mmassico/window_air_vent/firmware/README.md

# Firmware

> **Running on the installed vent, in `webui/`.** Both sketches compile without warnings (Arduino core esp32 3.3.12). The web application runs the complete unit in a window, and it's now updated over the Wi-Fi: every part answers, and the console, the firmware update and both of its rollbacks (a crash at boot, no confirmation within 5 min) work. At every boot, a boundary test finds the damper's two ends. The SCD40's temperature matches two other thermometers within 0.2 °C, so its factory offset stays. Its CO₂ agrees with a calibrated meter (a GasDoc, calibrated outdoors, where it then read 418 ppm): 808 vs 759 ppm side by side, within the SCD40's ±(50 ppm + 5 %), so it isn't recalibrated. The microphone was calibrated on the bench against a sound level meter, before it went into its tube; it's too noisy outdoors to repeat that in place, so the tube's effect on the level hasn't been measured. `baremetal/` checked every part on the bench first.

Two sketches and the library they share:

1. **`baremetal/`**: a serial command console to check every electronic part on its own, with no Wi-Fi and no control logic.
2. **`webui/`**: the standalone application. The CO₂ control runs on the ESP32, with its own web page on the home network (LAN) for status, graphs, settings and manual control. With no sensors connected, a simulation stands in for them. See [The web application](#the-web-application-webui).
3. **`libs/WindowVent/`**: the pin map (`Pins.h`) and the drivers both sketches use (SCD40, AS5600, TMC2209, fans, DS18B20, microphone, serial console).

## Board and tools

- **Board:** Freenove ESP32-S3-WROOM Lite (FNK0099): 16 MB flash, 8 MB octal PSRAM, and two USB-C connectors: **USB-UART** (the onboard code uploader, a CH343 USB-serial chip wired to the ESP32's UART0) and **USB-OTG** (the ESP32-S3's own USB, host or device). Dimensions and pinout: [doc/esp32_s3.svg](../doc/esp32_s3.svg).
- **Software:** Arduino IDE 2.x with the **esp32 by Espressif Systems** core, version 3.x (tested to compile with 3.3.12).
- **Libraries:** the project's own `WindowVent` (in `libs/`), for both sketches; and for `webui/`, **ArduinoJson** 7.x by Benoit Blanchon (Library Manager). In the Arduino IDE, copy `libs/WindowVent` into the `libraries` folder of the sketchbook (Documents > Arduino > libraries on Windows), or link it there, so the IDE finds it.
- **Arduino IDE settings (Tools menu):**

| Setting | Value |
|---|---|
| Board | ESP32S3 Dev Module |
| USB CDC On Boot | Disabled: the console (`Serial`) then goes through the USB-UART connector. Enabled would move it to the USB-OTG connector |
| Flash Size | 16MB (128Mb) |
| Partition Scheme | 16M Flash (3MB APP/9.9MB FATFS) |
| PSRAM | OPI PSRAM |
| Upload Mode | UART0 / Hardware CDC |

Plug the cable into the **USB-UART** connector (silkscreen: onboard code uploader); it is used both to flash and for the console. Windows lists it as "USB-SERIAL CH343 (COMx)" under "Ports (COM & LPT)"; if it doesn't appear, install the CH343 driver from Freenove's package. Leave the TX/RX header pins (GPIO 43/44) unconnected. For the console, use the Serial Monitor at 115200 baud, or a terminal such as PuTTY; the up and down arrows then recall earlier commands.

The same builds from the command line, run from the `firmware` folder (`--libraries libs` points arduino-cli at the shared library; `-u -p COM3` also flashes the board on COM3):

```
arduino-cli lib install ArduinoJson
arduino-cli compile --fqbn "esp32:esp32:esp32s3:FlashSize=16M,PSRAM=opi,PartitionScheme=app3M_fat9M_16MB" --libraries libs baremetal
arduino-cli compile --fqbn "esp32:esp32:esp32s3:FlashSize=16M,PSRAM=opi,PartitionScheme=app3M_fat9M_16MB" --libraries libs webui -u -p COM3
```

## Wiring

Every pin is defined in [`libs/WindowVent/src/Pins.h`](libs/WindowVent/src/Pins.h), for both sketches. "3V3" and "GND" are the ESP32 board's pins. Every ground is common.

Wiring diagram: SCD40, AS5600, 12 V sense divider and both fans on the left of the ESP32-S3, TMC2209, stepper, two DS18B20 temperature sensors and the optional MAX9814 microphone (audio mode, with its GPIO 21 to GPIO 3 wire) or INMP441 I2S microphone (SD on GPIO 21, SCK and WS on GPIO 38 and 39) on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

The table below gives the same connections, pin by pin.

| Part | Pin | Goes to | Extra parts |
|---|---|---|---|
| **SCD40** (CO₂) | VDD, GND | 3V3, GND | |
| | SDA, SCL | GPIO 8, GPIO 9 (I²C bus 0, 100 kHz) | Most modules have pull-ups; on a 1–2 m cable, 4.7 kΩ to 3V3 at the ESP32 end helps |
| **AS5600** (encoder) | VCC, GND | 3V3, GND | |
| | SDA, SCL | GPIO 6, GPIO 7 (I²C bus 1, 400 kHz) | Pull-ups are on the module |
| | DIR | GND (sets the counting direction) | |
| **TMC2209** | VM, GND | 12 V, GND | 100 µF ≥ 25 V across VM–GND, close to the module |
| | VIO | 3V3 | |
| | EN | GPIO 10 | 10 kΩ to 3V3: the motor stays off while the ESP32 boots |
| | STEP, DIR | GPIO 11, GPIO 12 | |
| | DIAG | GPIO 13 | |
| | PDN_UART | GPIO 18 directly, and GPIO 17 through 1 kΩ | Single-wire UART, on the module's UART pin, and on its PDN pin too through JP3 (PCB v1.3). Some modules route the chip's PDN_UART to their PDN pin instead, through a 0 Ω link: see step 5 below |
| | MS1, MS2 | GND | UART address 0 |
| | A1 A2 B1 B2 | Motor coils | Never plug or unplug the motor with 12 V on |
| **Fan 0, exhaust** (upper; Noctua: black GND, yellow 12 V, green tach, blue PWM) | PWM | GPIO 4 | 10 kΩ to GND: the fan stays slow while the ESP32 boots |
| | Tach | GPIO 15 | 10 kΩ to 3V3 |
| **Fan 1, intake** (lower) | PWM | GPIO 5 | 10 kΩ to GND |
| | Tach | GPIO 16 | 10 kΩ to 3V3 |
| **12 V sense** | | GPIO 1 | 100 kΩ from 12 V to GPIO 1, 22 kΩ from GPIO 1 to GND |
| **DS18B20, outdoor** (waterproof probe through the foam insert) | VDD, GND | 3V3, GND | Three wires, no parasite power |
| | DQ | GPIO 14 | 4.7 kΩ to 3V3 |
| **DS18B20, indoor** (optional: the SCD40 also reads the room's temperature) | VDD, GND | 3V3, GND | |
| | DQ | GPIO 21 | 4.7 kΩ to 3V3 |
| **Microphone, audio mode** (optional, instead of the indoor DS18B20: a MAX9814 module) | VDD, GND | 3V3, GND | On the indoor probe's header |
| | OUT | GPIO 21, wired to GPIO 3 | No pull-up: leave the indoor probe's 4.7 kΩ out |

- **On the board itself:** the blue LED (GPIO 2) blinks as a heartbeat, and the RGB LED is on GPIO 48 (`led` command).
- **Temperature sensors:** read with the `temp` command; the sketch drives the 1-Wire bus itself (`Ds18b20.cpp`), so no library is needed. The outdoor probe goes through the foam insert, out of the sun. Its template spot, above the upper hole, now sits over the exhaust (on top since the swap), so the warm air leaving the room can reach it: a better spot is still to be chosen.
- **Audio mode (optional):** an analog microphone measures the outdoor sound level, for instance to close the damper when it's too loud outside. It takes the indoor DS18B20's header, so it replaces that probe. It stays on the room side and listens through a tube in the foam insert: see [the window insert's outdoor microphone](../window_insert/README.md#outdoor-microphone). That header's line, GPIO 21, has no ADC, so GPIO 21 is joined to GPIO 3, the only free pin on ADC1: fit JP2 on the back of the PCB (a solder jumper on v1.1 and v1.2, a 0 Ω 0402 or a short wire since v1.3), or solder a short wire on a v1.0 PCB or the perfboard. ADC2 can't be used while Wi-Fi runs. Leave out that header's 4.7 kΩ pull-up: it would pull the microphone's output toward 3.3 V. `AUDIO_MODE` is 1 in `Pins.h` (audio mode); set it to 0 to use the indoor probe instead. The firmware leaves GPIO 21 disconnected (input off, no pull-up or pull-down), reads the microphone on GPIO 3, and drops the indoor probe. GPIO 3 is a strapping pin, but only for the JTAG source, and only when an eFuse selects it, so the microphone's bias at reset does no harm. The MAX9814's output rests at about 1.25 V and swings up to 2 V peak to peak, inside the ADC's 0–3.1 V range. Tie its GAIN pin to VDD (40 dB) and leave A/R open. Its automatic gain control (AGC) holds loud sounds near a fixed output level, so above it a louder sound reads no higher. Measured at 40 dB gain against a calibrated meter (below), the readings are linear from about 50 dBA, where the ADC's own noise sets the floor (a quiet room reads about 45 dBA), up to about 76 dBA for broadband noise and 84 dBA for a 1 kHz tone (the AGC watches the peaks, and noise has higher peaks than a tone). Above that, the reading stays near 76 dBA (noise) or 83 dBA (tone). Outdoor noise of interest (60 to 75 dBA: traffic, a neighbour's mower) fits; louder still reads as about 76. At 50 or 60 dB (GAIN to GND, or open), the AGC would act 10 or 20 dB lower.
- **Audio mode with an INMP441 (optional, `MIC_INMP441` 1 in `Pins.h`):** a digital I²S microphone instead of the MAX9814. It has no AGC, so its level stays linear from about 35 dBA (its own noise) to about 120 dB, and its sensitivity is set at the factory (−26 dBFS at 94 dB SPL, ±1 dB), so `micCal` defaults to 120 with no calibration needed (`sound cal` still adjusts it for the tube). SD goes on GPIO 21 (J7's IN), WS on GPIO 39 and SCK on GPIO 38: PCB v1.4's J7 is a 2 × 3 header with WS, SCK and a GND on its second row; tie the INMP441's L/R pin to that GND (the left channel). Leave JP2 open; R9 can stay. Any GPIO can carry I²S on the ESP32-S3, and 38 and 39 are free on this board (35 to 37 belong to the octal PSRAM). It samples at 8000/s like the MAX9814 (a 512 kHz clock, inside the INMP441's 0.5 to 3.2 MHz), with the same A-weighting; the ADC then stays free, so the 12 V sense reads it directly. A saved `micCal` belongs to the microphone it was set for: after a switch, the new microphone's default applies. Compiles; not yet tested with an INMP441.
- **Power:** two adapters. A 12 V brick feeds VM, the fans and the 12 V sense; a 5 V USB-C adapter powers the ESP32 through its USB-UART connector (the board makes the 3V3 for the sensors and the TMC2209 logic). Join the brick's GND and the ESP32's GND on the perfboard. The [layout drawing](../doc/ebox_layout.svg) shows where the parts go in the box.
- **Driving the fan PWM directly:** the 3.3 V PWM output drives the Noctua PWM input as is (Noctua accepts a 3.3 V signal). If you ever add an inverting transistor, set `FAN_PWM_INVERT` to 1.

## Bring-up, one part at a time

Each step only needs the parts before it. Each line shows a command, then what you should see.

1. **ESP32 alone, on USB.**
   - Flash the sketch, open the console, and type `info`: the chip, 16 MB of flash and 8 MB of PSRAM should be listed.
   - `led 0 0 40`: the RGB LED turns blue.
2. **Encoder.**
   - `i2c scan 1` shows `0x36`.
   - `enc` gives the angle, with the magnet status "OK" and an AGC around mid-range (about 60–200).
   - Turn the shaft by hand: the angle follows.
   - "Too weak" means the magnet is too far away; "too strong" means it's too close.
3. **CO₂ sensor.**
   - `i2c scan 0` shows `0x62`, and `co2 serial` prints a number.
   - `co2 start`, wait 5 s, then `co2`: about 400–1000 ppm indoors, with the room's temperature and humidity. Breathe near it and the next reading jumps up.
   - The NDIR cell reads a little high in its first hours. `co2 frc 420` sets it against outdoor air: run `co2 start` outside for 3 minutes, then `co2 stop` and `co2 frc 420`.
4. **12 V on.**
   - `info`: Supply ≈ 12 V.
   - `fan all 30`, then `fan` a few seconds later: both fans report a speed.
   - Try `fan 0 100` and `fan 1 0`: each fan follows its own command.
   - The NF-A8s tested stop at 0% and 5%, and start between 5 and 10% (about 180 rpm). With the dampers open, they reach about 2200 rpm at 100%.
5. **Driver and motor.**
   - `tmc init`, then `tmc status`: version `0x21`, and IFCNT goes up by one after each `tmc wr` or `mot cur` command. That proves both directions of the UART work.
   - No answer, while `tmc wr 0 0x1C0` still says OK: the ESP32 hears its own bytes, so the line is fine up to the module's UART pin, but the chip isn't on it. Some modules, such as the TMC2209-LA, have a 0 Ω link that routes the chip's PDN_UART to either their PDN pin (pin 4) or their UART pin (pin 5), and come with it on PDN. On a v1.3 PCB, check that JP3 (pin 4) and JP4 (pin 5) are both fitted. Nothing else uses pin 4 on an older PCB or the perfboard, so join pins 4 and 5 with a short wire on the board's underside there (or move the link to the UART pad).
   - `mot en 1`, then `mot step 800`: a quarter turn at the default 16 microsteps. The report compares the expected angle with the encoder's. If their signs are opposite, the firmware will simply flip one of them.
   - `mot step -800` comes back.
   - `mot vel 1000` turns continuously with the driver's own step generator. Run `mon`, slow the shaft with your fingers, and watch SG drop. `mot vel 0` stops it.
   - When the damper is fitted, the same test against the lips gives the StallGuard number for "closed".
6. **Temperature probes.**
   - `info` lists each DS18B20 as "answers" or "absent" (the indoor one is optional).
   - `temp`: both temperatures after a 0.75 s conversion. Warm the probe in your hand and the next reading rises.
   - `temp rom`: each probe's ROM code; family `28` is a genuine DS18B20 type.
   - "absent" means no presence pulse: check the three wires and the 4.7 kΩ pull-up. "CRC error" usually means a weak or missing pull-up, or a long cable.
7. **Microphone (audio mode only).**
   - `info`: the microphone's DC level is about 1250 mV with a MAX9814. Near 0 or 3300 mV means no bias: check its power and the GPIO 21 to GPIO 3 wire.
   - `sound`: one 0.25 s reading. It gives the level in dBFS (0 dB is a sine filling the ADC's whole range), the DC bias, the peak-to-peak swing and the achieved sample rate (8000 samples/s aimed). Clap: the level jumps.
   - "CLIPPING" means the signal reaches the ADC's limits. The MAX9814's AGC caps its output at about 2 V peak to peak, so it shouldn't happen; if it does, check that GAIN is tied to VDD and that the DC level is near 1250 mV.
   - `sound mon` prints the level every 0.5 s, with a 10 s average, the loudest so far and a bar graph.
   - To read dB SPL instead of dBFS, play a steady noise, read it on a phone sound meter app, and type `sound cal <dB>` with that value. The offset lasts until a reboot; to keep it, copy the printed value into `MIC_CAL_DB` in `Pins.h`.
   - The level is measured in short bursts of one-shot reads, after a 150 Hz high-pass filter that cuts wind rumble and the fans' hum. The 12 V sense also reads ADC1 one-shot, and the core's continuous (DMA) mode can't share a unit with it. For a sound level, that's enough.
8. **Everything at once.** `mon 1000` prints one line per second with every reading, until a key is pressed. In audio mode, the indoor temperature's place shows the sound level.

Note any number that looks wrong: the magnet status, the AGC, the SG values while turning freely and against the lips, and the fan speeds at 30% and 100%. They become the settings of the final firmware.

## Command list

Type `help` on the console for the full list. In brief:

| Group | Commands |
|---|---|
| General | `help`, `cls`, `info`, `reboot`, `led <r> <g> <b>`, `mon [ms]` |
| I²C | `i2c scan <bus>`, `i2c rd <bus> <addr> <reg> [n]`, `i2c wr <bus> <addr> <reg> <data>...` |
| CO₂ | `co2 start`, `co2 stop`, `co2`, `co2 serial`, `co2 selftest`, `co2 frc <ppm>` |
| Encoder | `enc`, `enc zero` |
| Motor | `mot en <0\|1>`, `mot step <n> [speed]`, `mot vel <speed>`, `mot cur <mA> [hold%]`, `mot ustep <n>`, `mot sgt <n>` |
| Driver registers | `tmc init`, `tmc status`, `tmc rd <reg>`, `tmc wr <reg> <value>` |
| Fans | `fan`, `fan <0\|1\|all> <duty%>` |
| Temperature | `temp`, `temp rom` |
| Sound (audio mode) | `sound`, `sound mon [ms]`, `sound cal <dB>` |

Numbers can be written as `42`, `0x2A`, `2Ah`, `0b101010` or `101010b`. A long move or `mon` stops when any key is pressed.

## Defaults

The settings applied at boot are in `baremetal.ino`:
- 16 microsteps (interpolated to 256 by the driver);
- 500 mA run current, with 50% hold current;
- StealthChop;
- 800 microsteps/s, which is a quarter turn per second.

The current calculation assumes 0.11 Ω sense resistors (`TMC_RSENSE` in `Pins.h`), the usual value on StepStick-style modules.

## The web application (`webui/`)

The ESP32 runs the ventilation on its own and serves a web page on the home network: no cloud, no app.

**First start: Wi-Fi.** With no network saved, the vent opens its own Wi-Fi network, **WindowVent-setup** (no password). Join it with a phone: the setup page opens by itself (or go to http://192.168.4.1). Pick the home network, type its password, and the vent joins it; the setup network closes two minutes later. Then open **http://window-vent.local**, or the address the router gives it (the serial console prints it, and so does `info`). The ESP32-S3 has 2.4 GHz Wi-Fi only. If it can't join the saved network, the setup network opens again (after 20 s at start-up, or 5 min after losing the network), and the vent keeps trying to join meanwhile. On the serial console, `wifi <ssid> <password>` does the same (for a network name without spaces), and `wifi forget` erases it.

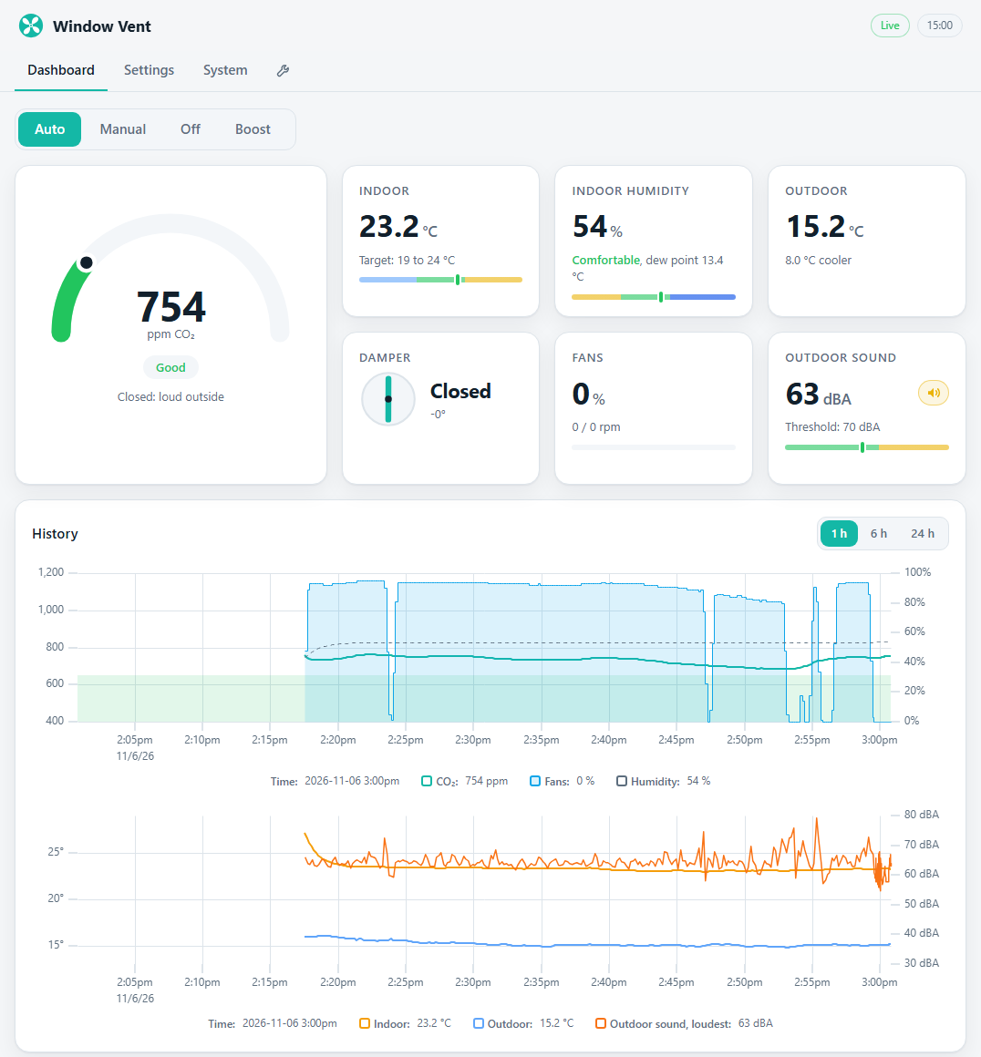
[picture p41: firmware/images/webui-dashboard.png]
The dashboard in the light theme, on the installed vent: Auto mode, a CO2 gauge at 754 ppm with the line Closed: loud outside, tiles for the indoor and outdoor temperatures, humidity, the closed damper, the fans at 0 % and the outdoor sound at 63 dBA with its loud icon, and about 40 minutes of two 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


*The dashboard on the installed vent, on a noisy day: the damper closes and the fans stop each time the outdoor sound crosses its threshold, here 70 dBA. The speaker icon in the sound's tile says so.*

**The page**, in four tabs:
- **Dashboard:** the mode (Auto, Manual, Off, Boost), a CO₂ gauge with the target range, the indoor and outdoor temperatures, humidity (with its comfort range and the dew point), the damper's position, the fans, the outdoor sound in audio mode, a line saying why the vent does what it does, and two graphs over 1, 6 or 24 hours (a point every 10 s, kept in PSRAM; a page that was in the background fetches what it missed when it comes back): CO₂ with the fans and the humidity (in %), and the indoor and outdoor temperatures with the outdoor sound in audio mode (in dBA, on the right).
- **Settings:** the CO₂ curve (drag its points), the damper's opening and closing levels, the absolute maximum and the target range; temperature, quiet hours, outdoor noise, fans, boost, the damper motor, network and time; then the page's theme and colours. The Save button stores the settings on the vent (NVS), and every other open page picks them up within a second or two, keeping any edits it hasn't saved. The theme stays with each browser; the colours can be saved on the vent and loaded in another browser. On a phone, the sliders take a horizontal drag only: a vertical swipe that starts on one scrolls the page, and a tap leaves it alone.
- **System:** the Wi-Fi network, the firmware, the local time (NTP), restart, and the firmware update.
- **Developer** (the wrench): the simulation, the control outputs, which parts answer, the damper's boundary test, and the log with a console under it.

**How it decides (Auto).** Every second, the CO₂ curve gives a fan speed. The damper opens above the opening level and closes below the closing level (the gap between them keeps it from hunting), each state held a minimum time. Caps then lower the speed: cold outside (linear between two outdoor temperatures), a room below its comfort range, warmer air outside, quiet hours, outdoor noise. A cap of 0 % closes the damper, and the dashboard says which limit did. A warm room with cooler air outside gets free cooling. Above the absolute maximum, ventilation goes full whatever the caps. The fans ramp at 5 % per second, and the balance setting trims intake against exhaust. Without a CO₂ reading, the fans run at 30 %. The details are at the top of [`webui/Control.h`](webui/Control.h).

**The damper's boundary test.** At every boot, as soon as the driver and the encoder answer, the damper closes slowly until it stops on the lips, then opens until it stops at the other end; the encoder watches it, as for any move. The closed stop becomes the encoder's zero (`encZero`, saved when it changes), and the open angle stays 2° short of the open stop, whatever `openDeg` asks. Closing then aims 2° past the closed stop, so the disc always seats on the lips. If the encoder goes more than 20° the wrong way while closing, `motorDir` is flipped and the test starts again; it's saved only if the test succeeds (a disc already on the lips bounces back a few degrees, which doesn't count). If the two stops come out too close together, it also tries the other direction, once: a disc that starts near the open stop can't show a wrong direction while closing. It fails, keeping the saved settings, if it finds no stop within 20 s or the two stops are less than 20° or more than 200° apart. It takes about 10 s; the log shows each step, `status` shows the stops, and `damper cal` (or the Developer tab's button) runs it again. On the bench: closed at raw 3569, 100.4° to the open stop.

**The microphone's calibration.** The firmware A-weights the microphone's signal (two biquads at 8000 samples/s, within 0.8 dB of IEC 61672 from 31 Hz to 3.9 kHz; see [`Sound.h`](libs/WindowVent/src/Sound.h)), so once calibrated it reads dBA, as a sound level meter does: dBA = A-weighted dBFS + `micCal`. The bench unit was calibrated against a REED R8080 meter (dBA, FAST), next to the MAX9814, with a USB speaker playing pink noise and tones stepped by 6 dB: `micCal` = 90.8 dB, now the default (`MIC_CAL_DB` in `Pins.h`). The vent's own reading then matched the meter within 0.7 dB from 57 to 75 dBA (within 0.2 dB from 63 to 75), and tones from 250 Hz to 3 kHz within ±1 dB. Without the A-weighting, the flat reading would read low-pitched noise such as traffic about 6 dB louder than the meter. For another module, or the microphone in its tube, play a steady noise above 55 dBA, read it on a meter, and type `sound cal <dBA>` on the console: it sets `micCal` and saves it. `sound [ms]` gives the level over the last ms, up to 8 s, with its loudest 1/8 s.

**How it listens.** The web firmware samples the microphone without a pause, at 8000 samples/s: the ADC's DMA mode does the sampling, and a small task filters the samples into blocks of 1/8 s, a sound level meter's FAST response (see [`SoundStream.h`](libs/WindowVent/src/SoundStream.h)). A short sound such as a dog's bark can't fall between two readings. The noise threshold looks at the loudest 1/8 s, so one bark is enough, and each one restarts the hold time. The dashboard's tile shows that same value, the loudest 1/8 s of the last second, and so does the graph: each second's loudest while the page is open, each 10 s's loudest from the vent's history, so what closed the damper stays visible. The 12 V sense shares ADC1, and DMA can't share it with one-shot reads, so its reading comes through the same stream. The vent's own fans count too: at full speed they raised the reading from 57 to about 63.5 dBA here, so keep the threshold clear of that, or the damper will close, go quiet, reopen and close again. The baremetal sketch keeps its one-shot bursts.

**The SCD40's temperature offset.** The SCD40 reads warm: it heats itself, and the ESP32, the driver and the box around it add to that. It subtracts a temperature offset (4 °C from the factory) from its temperature, and uses the corrected temperature for its humidity too, so the right offset fixes both. It depends on where the sensor ends up and the air around it, so set it with the vent in its final place, after it has run for at least an hour: put a reference thermometer beside the sensor (not in the sun, not in the fans' airflow), let both settle, and type `co2 tref <the reference's °C>` on the console. It sets the offset so the sensor reads the same, and keeps it in the sensor's EEPROM (good for about 2000 writes, so not a thing to repeat often). `co2 offset` shows it, and `co2 offset <C>` sets it directly. Both stop and restart the sensor's measurement, and its temperature drifts for a few minutes after that: wait at least 5 minutes before comparing again.

**Simulation.** At start-up, the simulation stays on unless the SCD40 answers within 8 s; the Developer tab switches it either way. It stands in for the sensors, the fans and the damper, and the real fans and motor stay still meanwhile. **Manual values**: a slider per reading. **Room model**: occupants breathe CO₂ into a room, the ventilation carries it out and moves the room toward the outdoor temperature, and time can run up to 300 times faster.

**Editing the page.** Its sources are in `webui/web/` (`index.html`, `app.css`, `app.js`, `setup.html`, and uPlot for the graphs, MIT licence, in `web/vendor/`). After a change, run `python tools/webui_pack.py` from the `window-vent` folder: it inlines and gzips them into `webui/WebPage.h` and `webui/SetupPage.h`; then build and flash. To try a change without flashing, serve the folder from the PC (`python -m http.server` in `webui/web`) and open `http://localhost:8000/?host=<the vent's address>`: the page then talks to the vent.

**Interface.** On port 80: `GET` and `POST /api/settings` (any subset, saved at once), `GET /api/history` (binary, see [`webui/History.h`](webui/History.h)), `POST /api/cmd` (a command, as on the WebSocket), `GET /api/scan` and `POST /api/wifi`, `GET` and `POST /api/ui` (the shared colours), and `/ws`, a WebSocket that sends the whole state every second and takes commands such as `{"cmd":"mode","mode":"boost"}`. The list is at the top of [`webui/Web.h`](webui/Web.h).

**The password.** The console and the firmware update need the vent's password; both are refused until one is set. Set it on the serial console with `pass <password>` (no spaces), and change it the same way, there or from the web console; `pass -` removes it. It stays in NVS and the vent never sends it back. The page asks for it once per browser tab, and other clients send it in an `X-Pass` header. A wrong password costs a second. The rest of the page (the mode, the settings) stays open to anyone on the home network, as before.

**Console and log over the Wi-Fi.** The serial console's commands also work over the Wi-Fi, from the box under the log in the Developer tab, or from a PC:

```
curl -H "X-Pass: <password>" --data-binary "status" http://window-vent.local/api/console
curl "http://window-vent.local/api/log?since=0"
```

`help` lists the commands. `info` gives the firmware, the last reset's cause (power-on, crash, watchdog, brown-out), the uptime, memory and Wi-Fi. `status` gives every reading, the control's outputs, the damper, the fans and which parts answer. `log [n]` gives the last lines. For the hardware there are `enc`, `tmc` (its registers), `tmc rd` and `tmc wr`, `i2c scan <0|1>`, `sound` and `sound cal <dBA>`, `co2 offset [C]` and `co2 tref <C>`. `cpu` gives each task's share of its core since the last `cpu`. `sockets` lists the web server's connections (HTTP or WebSocket, client, age) with its counters since boot, and the Wi-Fi drops; the System tab shows the same counters with each core's load. A page that stops reading (asleep in a background tab, or on a phone) never holds up the server: its WebSocket skips states while it is behind, and after 15 s without progress the vent closes it (counted as "closed for not reading"); the page reconnects when it wakes up. Commands run in the main loop, between its tasks, so they never collide with the sensors' readings. The log keeps the last 2000 lines since boot in PSRAM; the page fetches them when it connects, and `GET /api/log?since=N` gives them to any client, numbered from 0 at boot.

**Fan roles.** The fans mount either way round in the housing, so which connector is the intake is a setting (Settings > Fans, "Intake on the lower fan (FAN1)"; the default comes from `INTAKE_FAN` in `App.h`): FAN0 is the upper fan, FAN1 the lower one, as on the PCB. The default is the intake on FAN1: the cold air comes in low and the warm exhaust leaves high, so neither loops back into the other. The control, the balance, the dashboard and `status` work in intake and exhaust, whichever connector each one is on.

**Test mode.** `fan <0|1|all> <duty%>` (by connector) or `fan intake|exhaust <duty%>` (by role) and `damper <deg>` drive the fans and the damper directly, and switch on test mode: the control keeps computing (`status` shows it) but no longer drives them. `test off` hands them back. Test mode also ends by itself after 10 minutes without a test command, so a forgotten test can't leave the vent stuck. `damper` moves with the encoder, as the control does, and clears a previous fault.

**Firmware update over the Wi-Fi.** Once this firmware is on the vent (by USB, once), the next ones can go over the Wi-Fi. Build it (Arduino IDE: Sketch > Export Compiled Binary; arduino-cli: add `--output-dir build`) and send `webui.ino.bin`, not the much larger `webui.ino.merged.bin`. Either pick it in the System tab's Firmware update, or:

```
curl -H "X-Pass: <password>" --data-binary @build/webui.ino.bin http://window-vent.local/update
```

The flash has two application slots (`app0`, `app1`, from the partition scheme above). The update goes to the slot that isn't running, and the vent restarts into it, keeping the other one. The new firmware then has to prove itself: it confirms itself once it has been on the Wi-Fi for 30 s. If it crashes before that, or isn't on the Wi-Fi within 5 minutes, the vent goes back to the previous firmware, so a bad build can't strand the vent out of reach. The log says which happened, and `ota` shows the two slots. Settings, Wi-Fi and the password stay in NVS through an update. Uploading another sketch this way (`baremetal`) would skip that check and stay, with no way back but USB.

## License

The firmware is released under the [MIT License](LICENSE).
