mmassico/window_air_vent/doc/foam_template.pdf

# Foam insert: drilling template, full size (mm)

Print at 100 % (Actual size, not Fit to page); both bars must measure 100 mm.
Tape it on the foam, centred across the insert's width, EXHAUST on top (it works from either face). Drill a pilot hole right through each centre: mark it with an awl, or set the drill_guide on the lines. Cut with a 3-1/4 in (83 mm) hole saw, halfway from each face, centred on the pilot hole.
Outdoor probe: if possible, put it far from the exhaust (the top hole), not in the spot marked below.

100
112
insert width

# EXHAUST

Ø 83 hole
top: room air out

# INTAKE

Ø 83 hole
bottom: outdoor air in

dashed circle: stop ring Ø 90 (the housing on the room face)

### 96 between centres

Optional: outdoor DS18B20

probe, Ø 6.5 hole
keep it in the shade

100 mm

100 mm

tools/foam_template_svg.py (hole 83, pitch 96, stop_od 90, widths 100 and 112)
