mmassico/window_air_vent/window_insert/doc/latch_template.pdf

# Window insert: latch cover notch template, full size (mm)

Print two copies at 100 % (Actual size, not Fit to page); both bars must measure 100 mm.
Copy 1: cut along the OUTER rectangle. Lay it on the foam's room face, its left edge on the foam's end (the side frame's end), and trace it: that is the top edge of the three 45° slopes.
Copy 2: cut along the INNER rectangle: the notch's floor, 9.5 mm deep. Lay it in the notch to check the floor. Line both up in height with the notch in the assembled side cap; carve a little small, then sand to the cover.

OUTER: on the room face

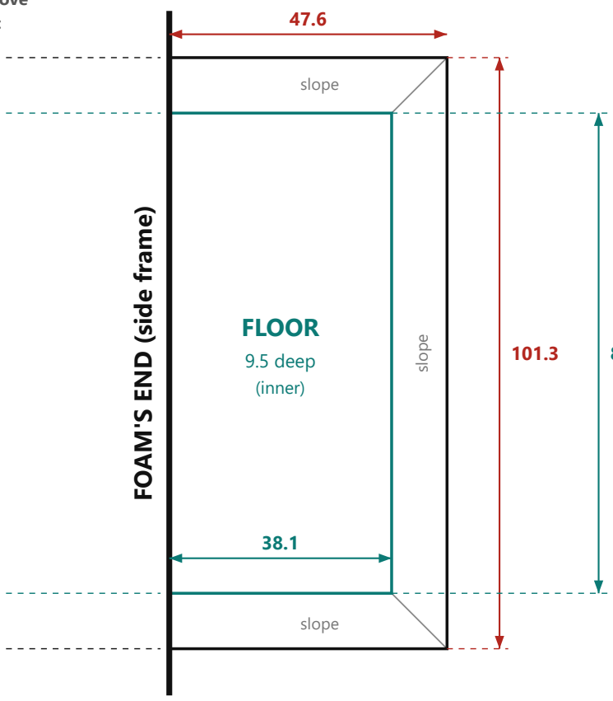
[picture p78: figure]
D (sid; e fra; slope; FLOOR; 9.5 deep (inner)

82.3

slopes: 45°, 9.5 wide on the face and 9.5 deep

On the foam, above
its bottom edge:
582.1 outer

572.6 inner

490.4 inner

480.9 outer

The foam's bottom edge is
below this page: TOP is up.

TOP

100 mm

100 mm

tools/latch_template_svg.py (outer 47.6 x 101.3, inner 38.1 x 82.3, 9.5 deep)
