mmassico/window_air_vent/pcb/view/render_top.png

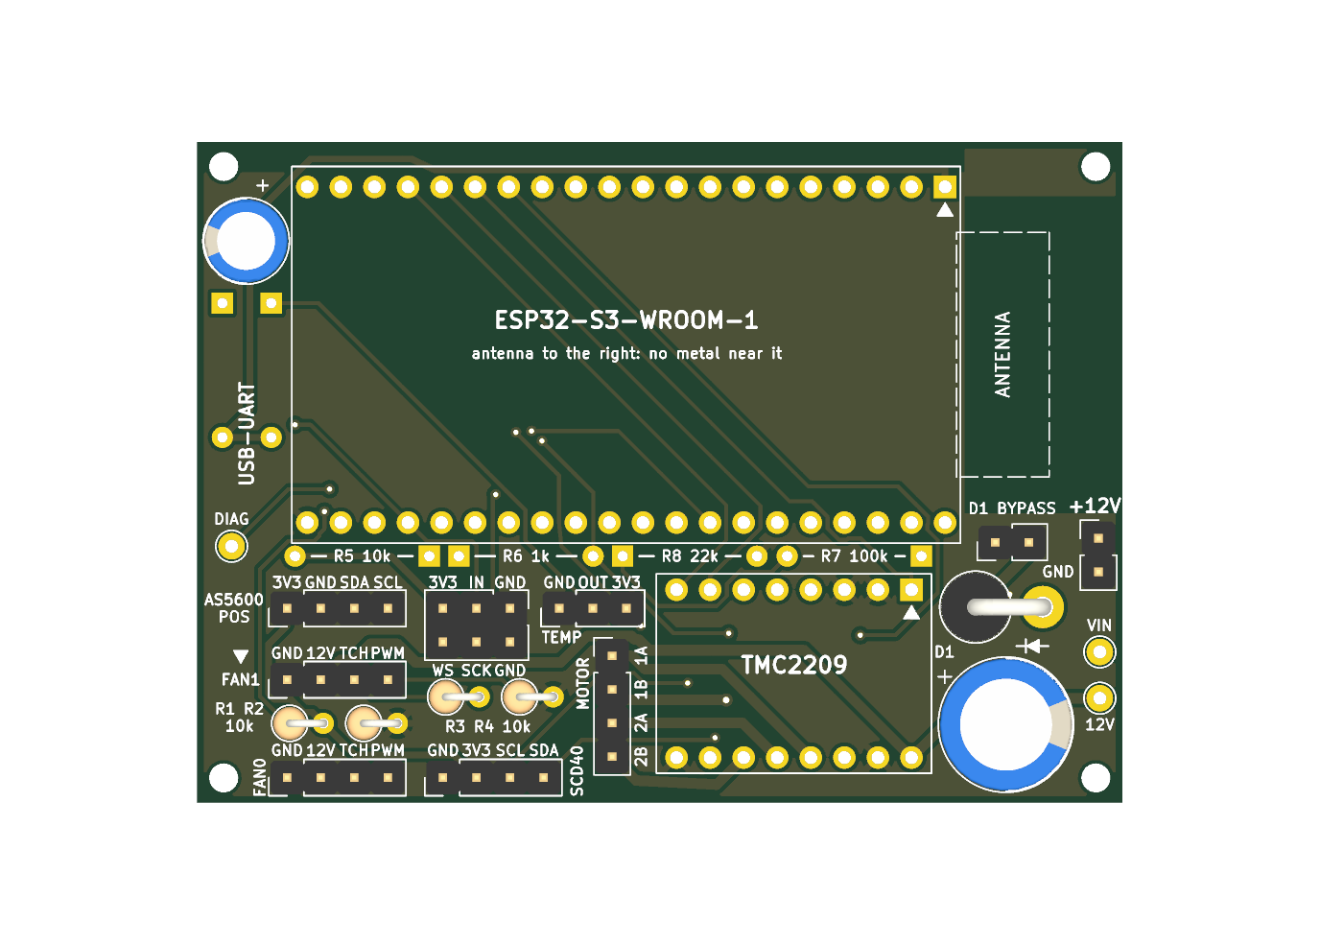
pcb/view/render_top.png
