mmassico/window_air_vent/stl/fan_shim.stl

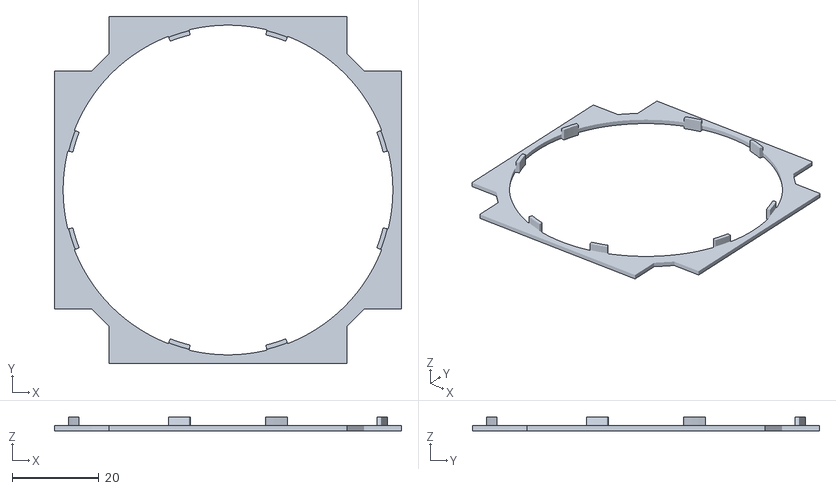
[picture p80: CAD file, 2026-11-14]
stl/fan_shim.stl
80.0 x 80.0 x 3.25
