mmassico/window_air_vent/window_insert/stl/mic_elbow_upper.stl

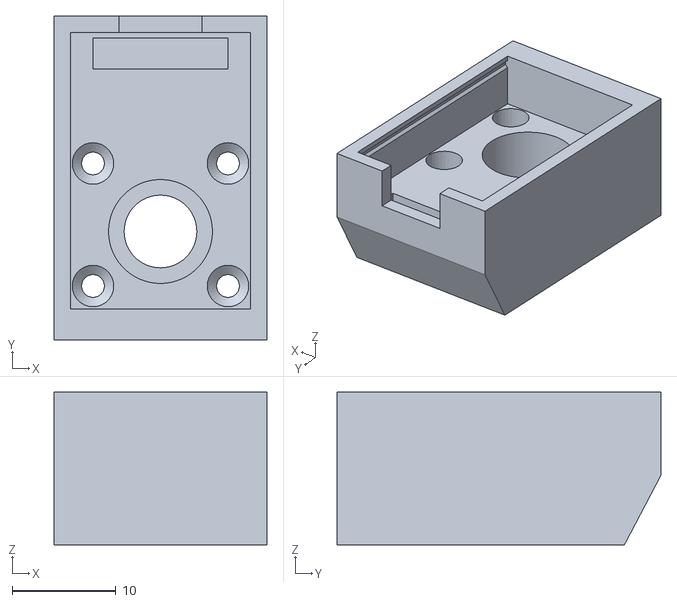
[picture p81: CAD file, 2026-11-07]
window_insert/stl/mic_elbow_upper.stl
20.5 x 31.2 x 14.7
