mmassico/window_air_vent/stl/fan_gasket_template.stl

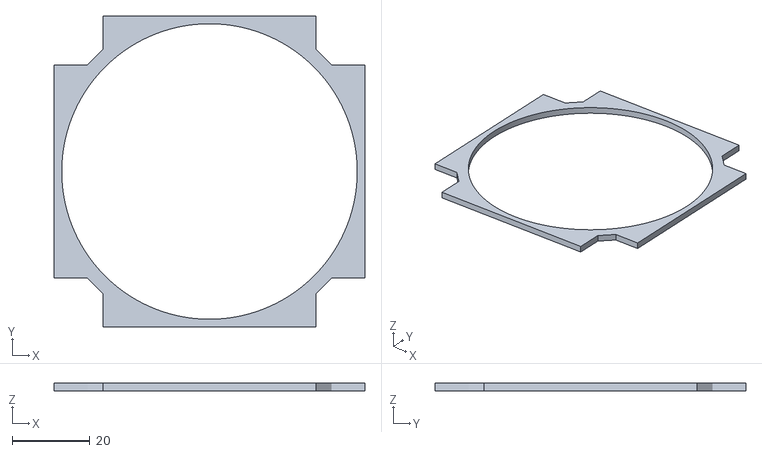
[picture p82: CAD file, 2026-11-14]
stl/fan_gasket_template.stl
80.0 x 80.0 x 2.00
