mmassico/window_air_vent/window_insert/stl/mic_elbow_lower.stl

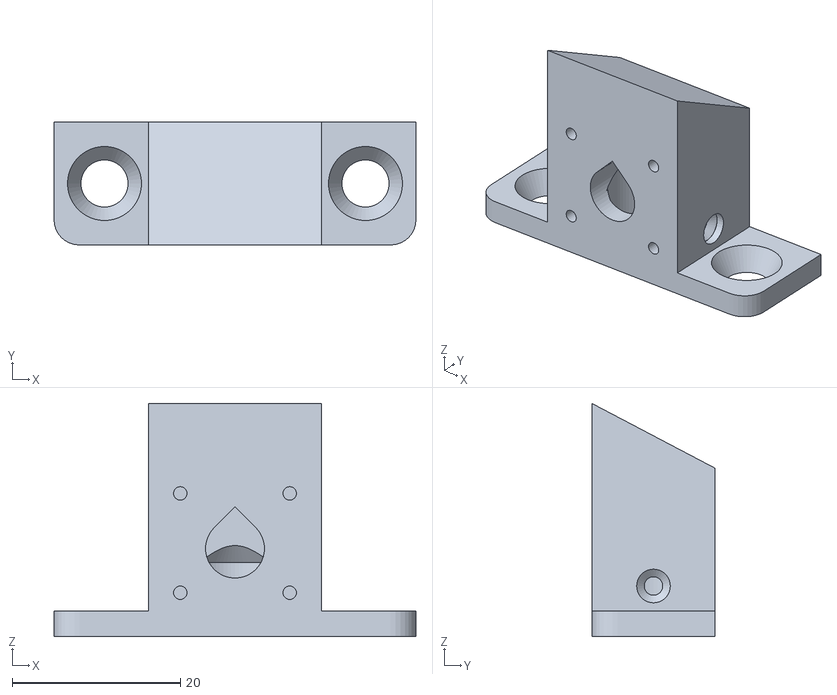
[picture p83: CAD file, 2026-11-07]
window_insert/stl/mic_elbow_lower.stl
43.0 x 14.6 x 27.7
