mmassico/window_air_vent/stl/fan_spacer.stl

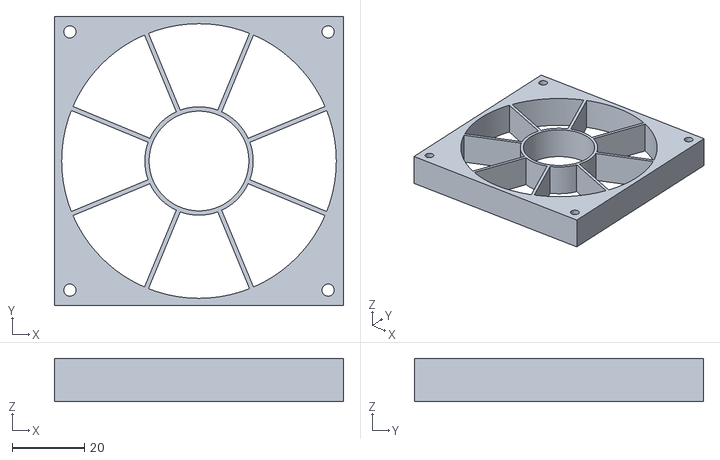
[picture p84: CAD file, 2026-11-14]
stl/fan_spacer.stl
80.0 x 80.0 x 12.0
