mmassico/window_air_vent/window_insert/stl/mic_bore_test.stl

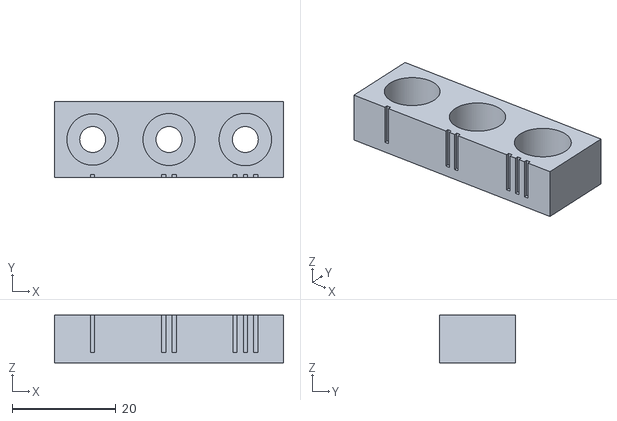
[picture p85: CAD file, 2026-11-07]
window_insert/stl/mic_bore_test.stl
44.1 x 14.7 x 9.18
