mmassico/window_air_vent/stl/body_bottom.stl

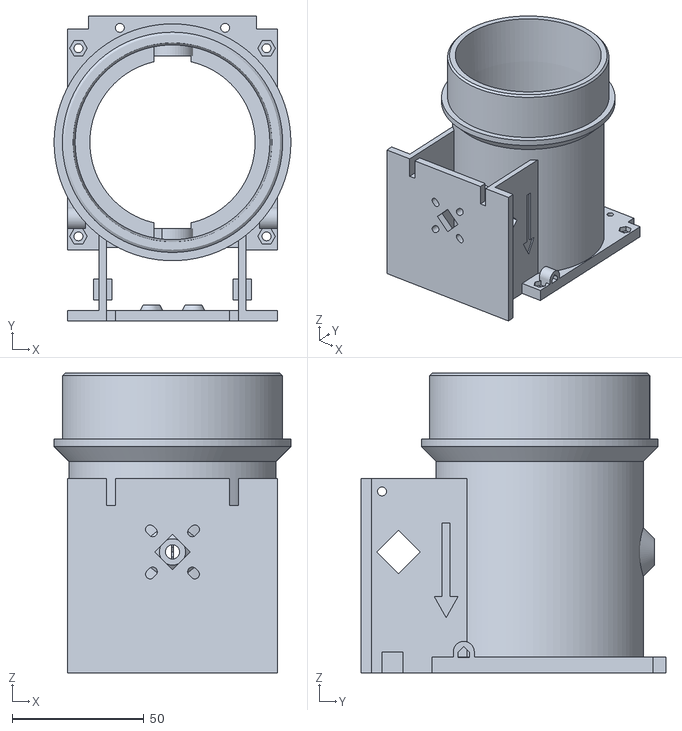
[picture p86: CAD file, 2026-11-08]
stl/body_bottom.stl
90.0 x 115.9 x 114.0
