mmassico/window_air_vent/window_insert/stl/mic_lid.stl

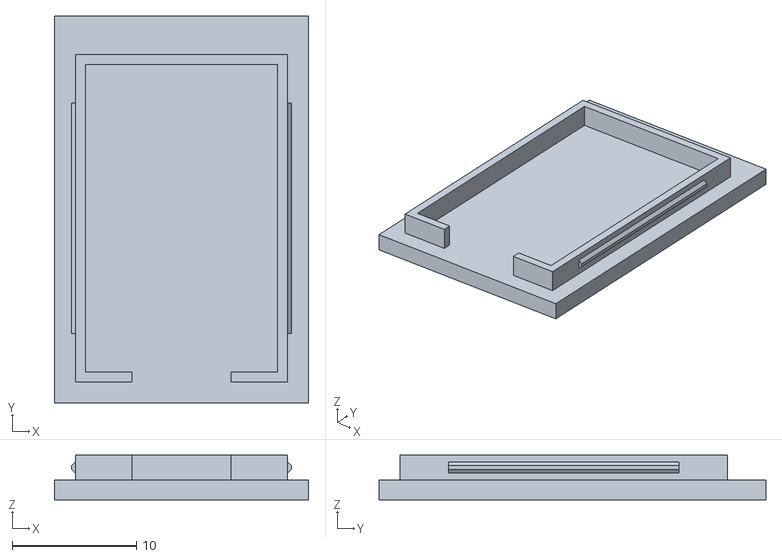
[picture p87: CAD file, 2026-11-07]
window_insert/stl/mic_lid.stl
20.5 x 31.2 x 3.60
