mmassico/window_air_vent/stl/body_top.stl

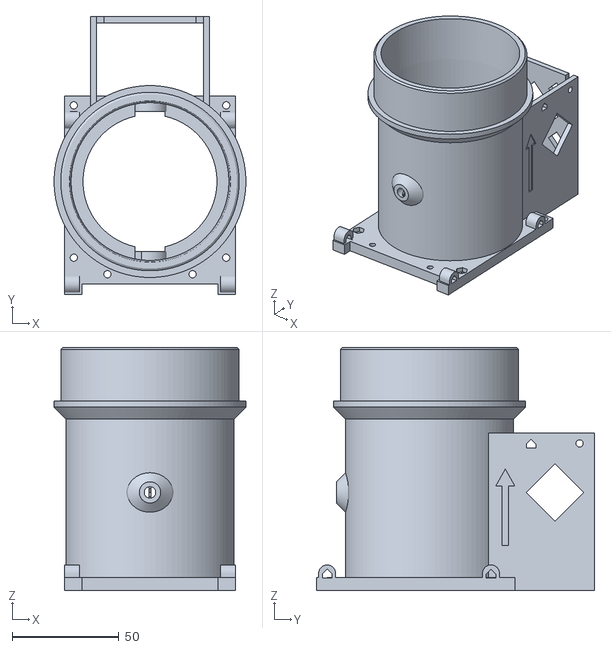
[picture p88: CAD file, 2026-11-08]
stl/body_top.stl
90.0 x 130.4 x 114.0
