mmassico/window_air_vent/window_insert/stl/mic_tube.stl

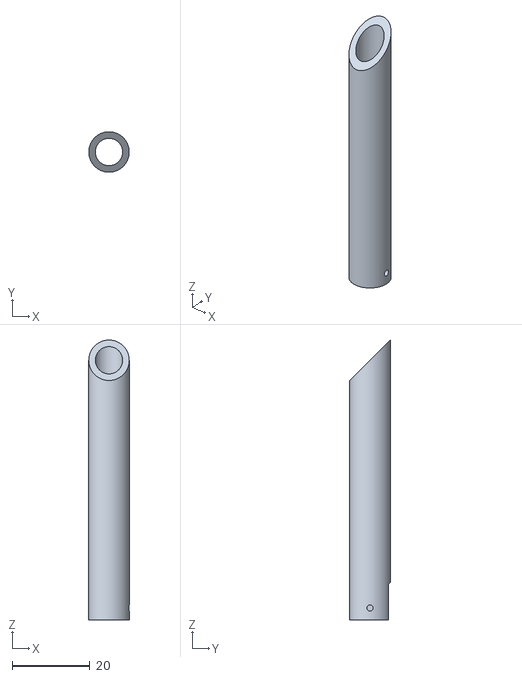
[picture p89: CAD file, 2026-11-06]
window_insert/stl/mic_tube.stl
10.4 x 10.4 x 71.9
