mmassico/window_air_vent/stl/body.stl

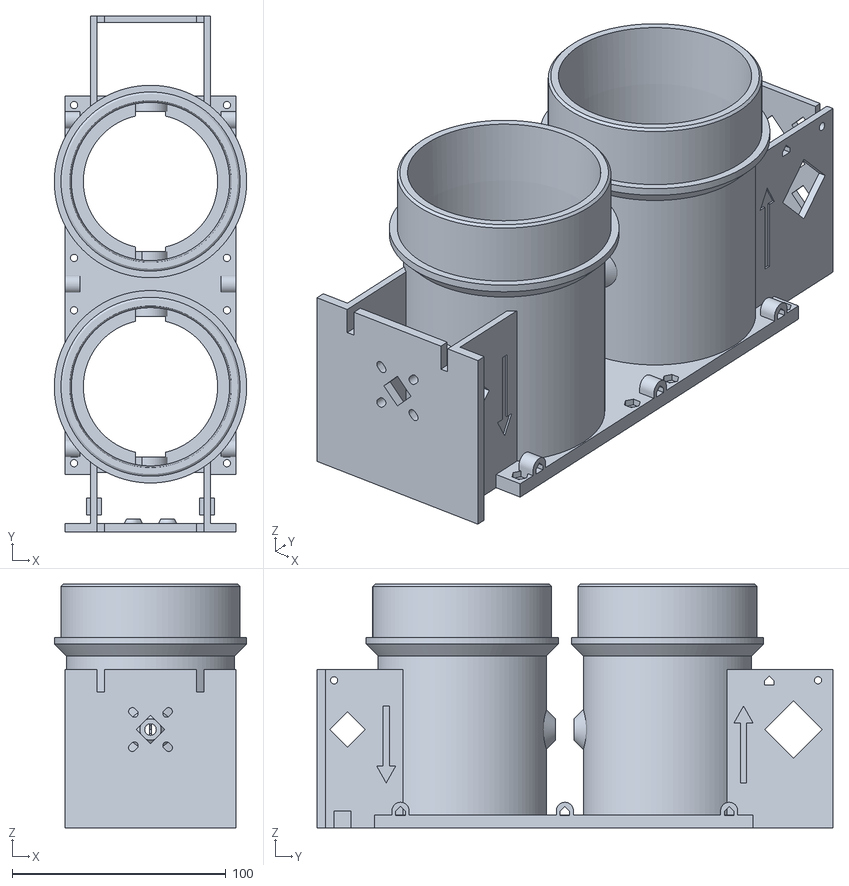
[picture p90: CAD file, 2026-11-08]
stl/body.stl
90.0 x 241.3 x 114.0
