mmassico/window_air_vent/window_insert/stl/latch_cover.stl

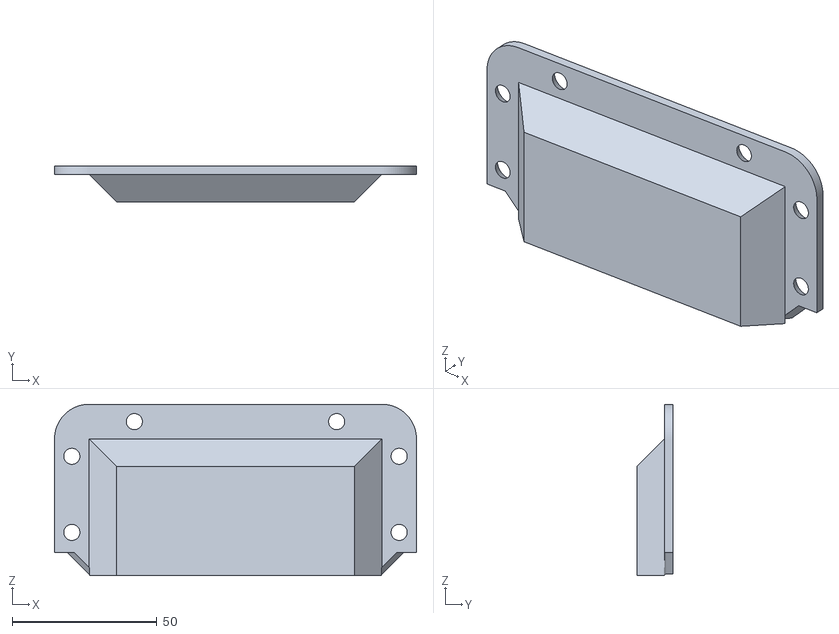
[picture p91: CAD file, 2026-11-04]
window_insert/stl/latch_cover.stl
125.3 x 12.5 x 59.3
