mmassico/window_air_vent/stl/tray_test.stl

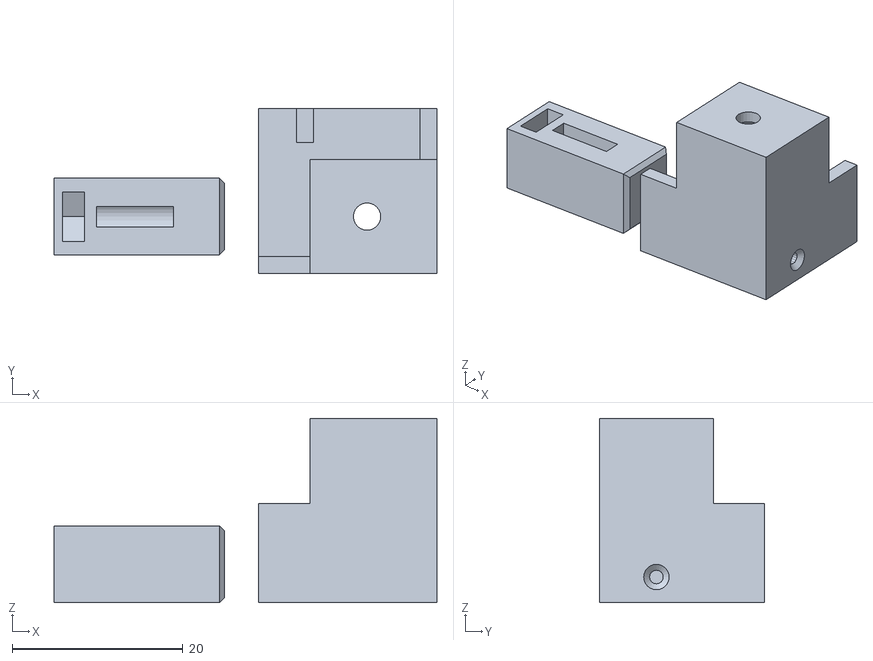
[picture p92: CAD file, 2026-11-05]
stl/tray_test.stl
44.9 x 19.4 x 21.6
