mmassico/window_air_vent/stl/tray.stl

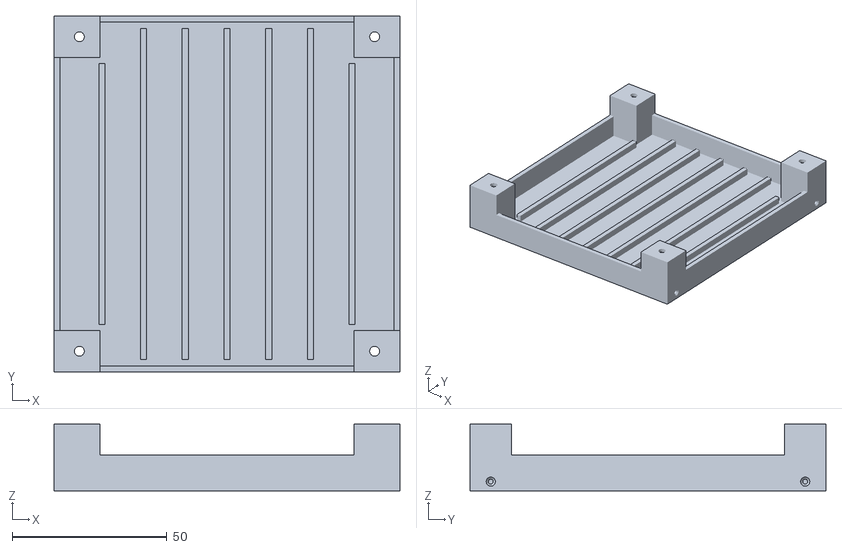
[picture p94: CAD file, 2026-11-05]
stl/tray.stl
111.8 x 115.0 x 21.6
