mmassico/window_air_vent/stl/tray_feet.stl

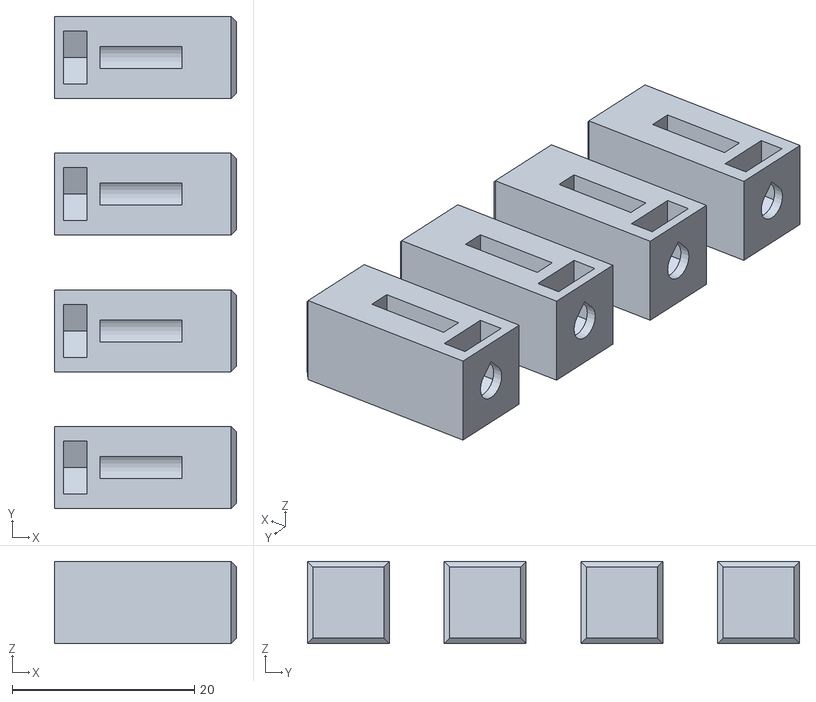
[picture p96: CAD file, 2026-11-04]
stl/tray_feet.stl
20.0 x 54.0 x 9.00
