mmassico/window_air_vent/window_insert/stl/side_3a.stl

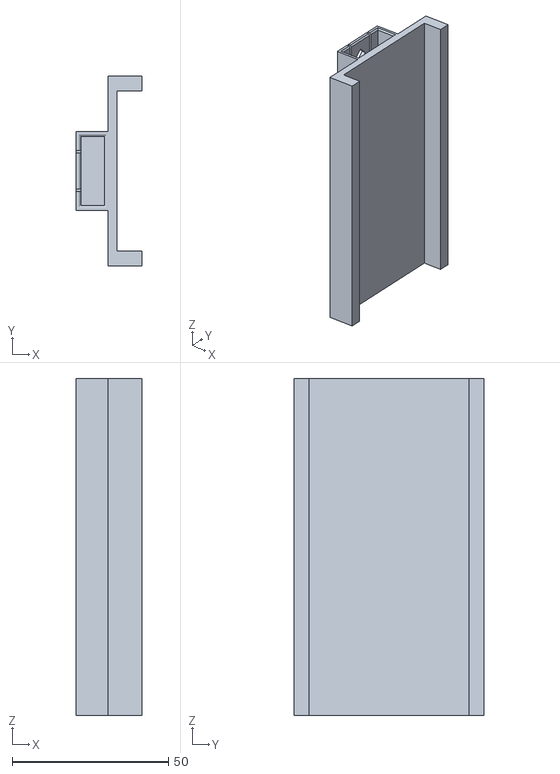
[picture p97: CAD file, 2026-11-02]
window_insert/stl/side_3a.stl
21.2 x 60.8 x 108.0
