mmassico/window_air_vent/stl/screen_test.stl

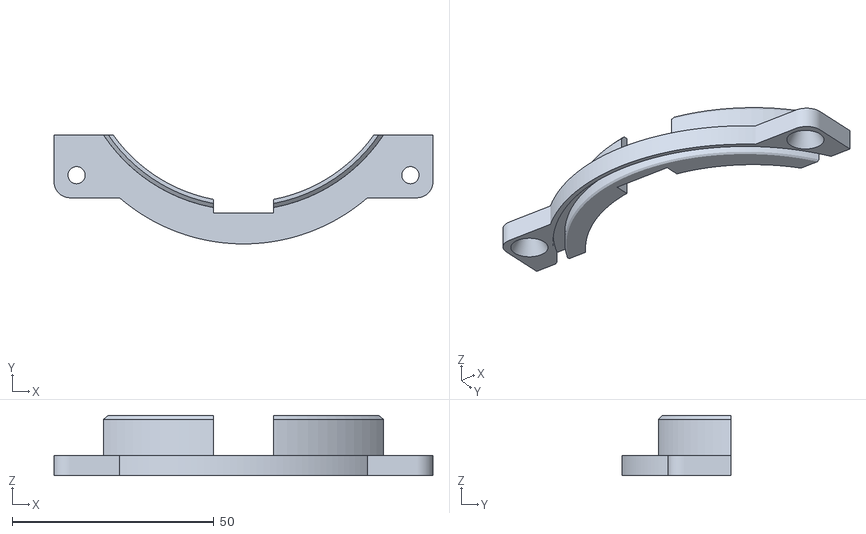
[picture p98: CAD file, 2026-11-04]
stl/screen_test.stl
94.0 x 27.0 x 15.0
