mmassico/window_air_vent/window_insert/stl/sash_1a.stl

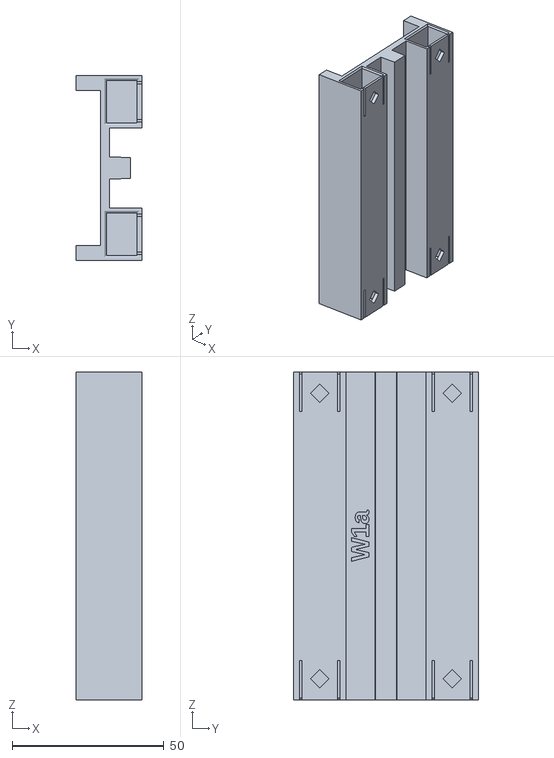
[picture p99: CAD file, 2026-11-02]
window_insert/stl/sash_1a.stl
21.7 x 60.8 x 108.0
