mmassico/window_air_vent/stl/screen_frame.stl

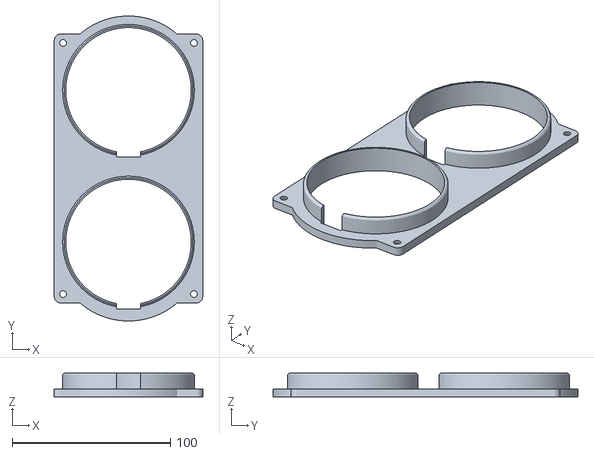
[picture p100: CAD file, 2026-11-04]
stl/screen_frame.stl
94.0 x 193.0 x 15.0
