mmassico/window_air_vent/window_insert/stl/side_0a.stl

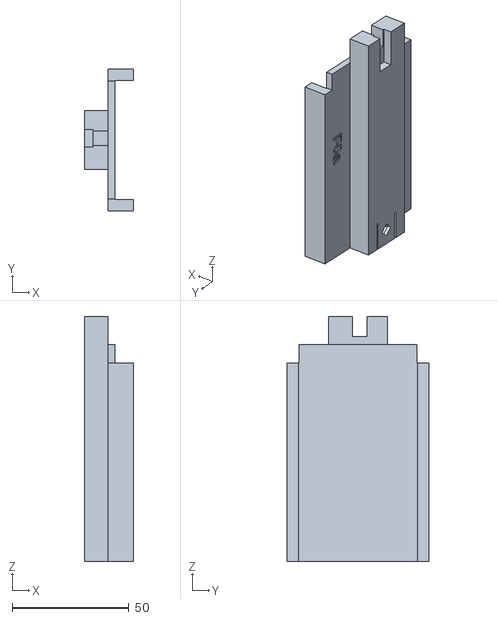
[picture p101: CAD file, 2026-11-02]
window_insert/stl/side_0a.stl
21.2 x 60.8 x 105.0
