mmassico/window_air_vent/stl/foam_guide_b.stl

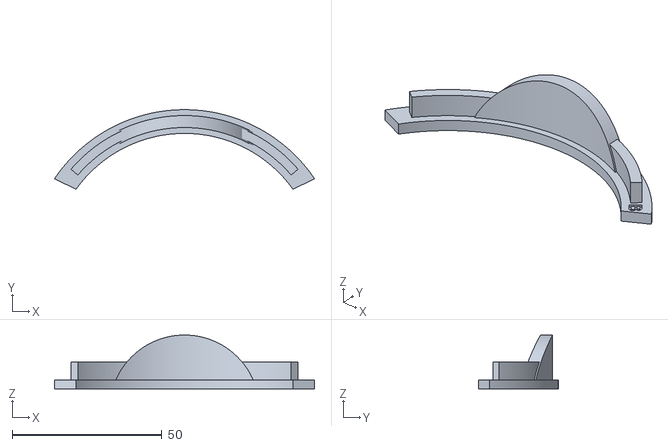
[picture p102: CAD file, 2026-10-28]
stl/foam_guide_b.stl
86.7 x 26.6 x 18.0
