mmassico/window_air_vent/window_insert/stl/side_2b.stl

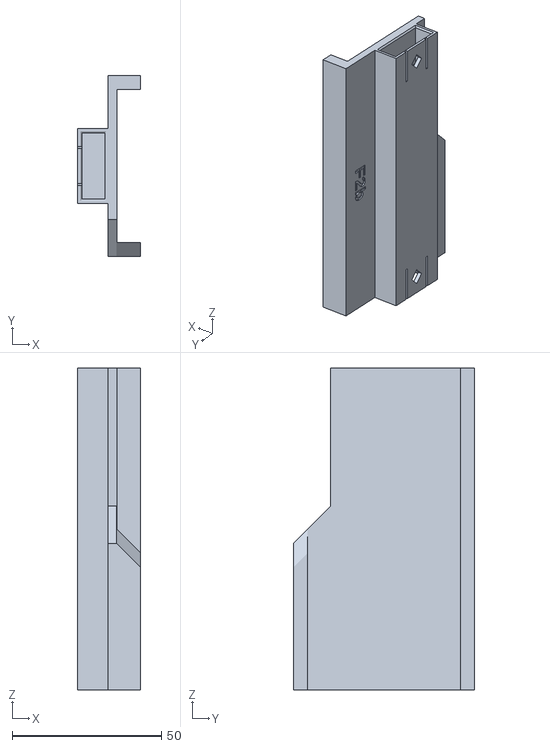
[picture p103: CAD file, 2026-11-02]
window_insert/stl/side_2b.stl
21.2 x 60.8 x 108.0
