mmassico/window_air_vent/stl/foam_guide_a.stl

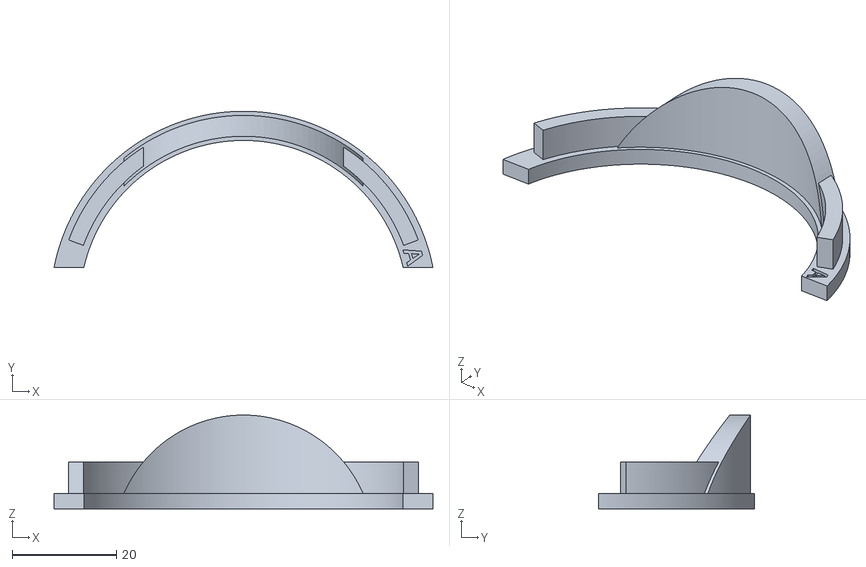
[picture p104: CAD file, 2026-10-28]
stl/foam_guide_a.stl
72.7 x 30.0 x 18.0
