mmassico/window_air_vent/stl/disc.stl

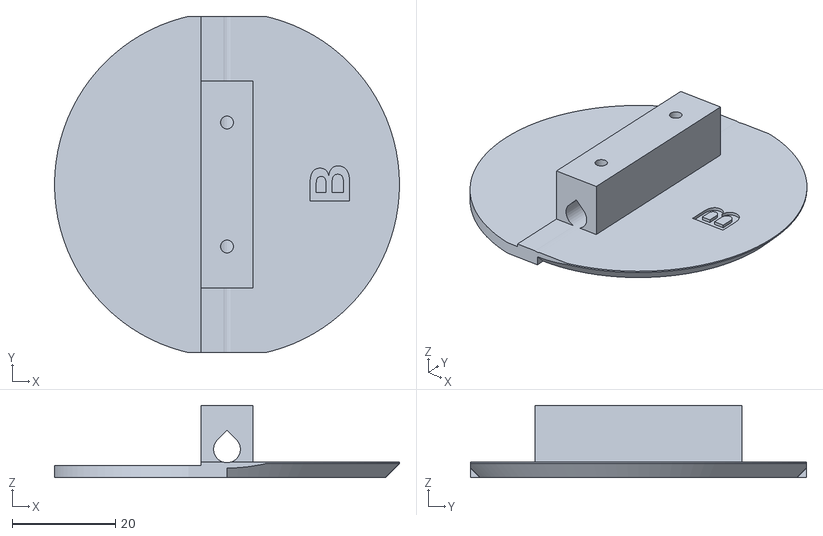
[picture p105: CAD file, 2026-10-28]
stl/disc.stl
66.8 x 65.1 x 14.0
