mmassico/window_air_vent/stl/disc_nofoam.stl

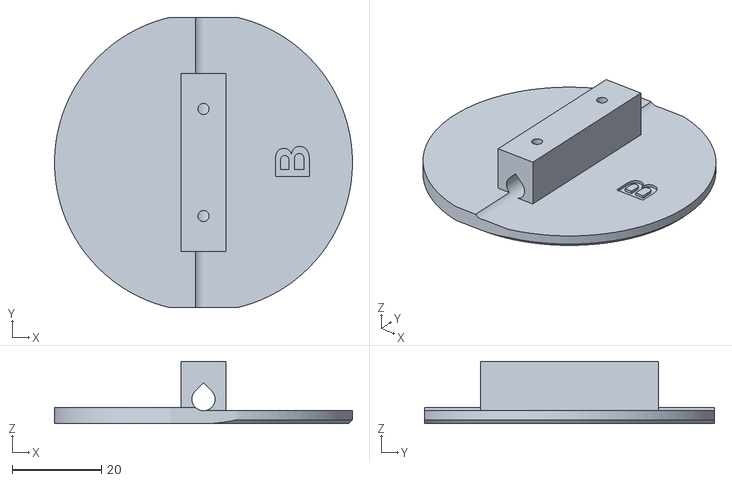
[picture p106: CAD file, 2026-10-28]
stl/disc_nofoam.stl
66.8 x 65.1 x 14.0
