mmassico/window_air_vent/stl/drill_guide.stl

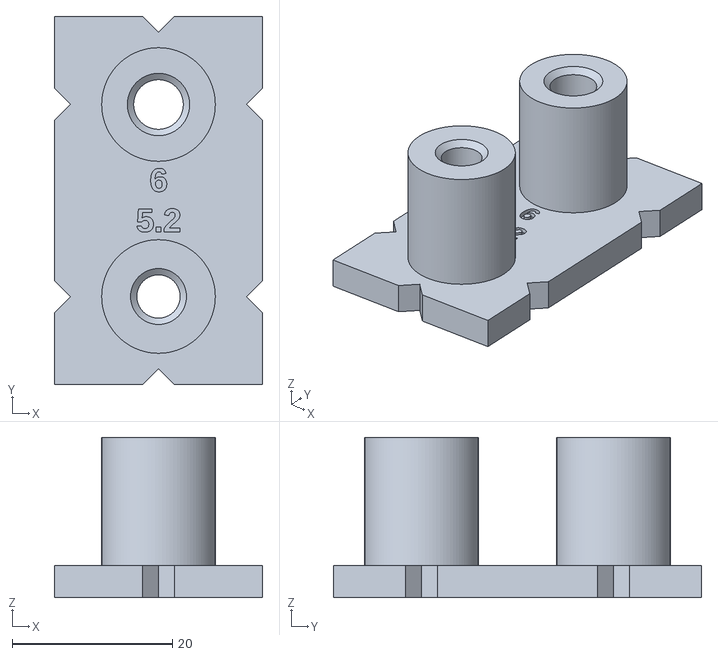
[picture p107: CAD file, 2026-10-27]
stl/drill_guide.stl
26.0 x 46.0 x 20.0
