mmassico/window_air_vent/window_insert/stl/sash_4b.stl

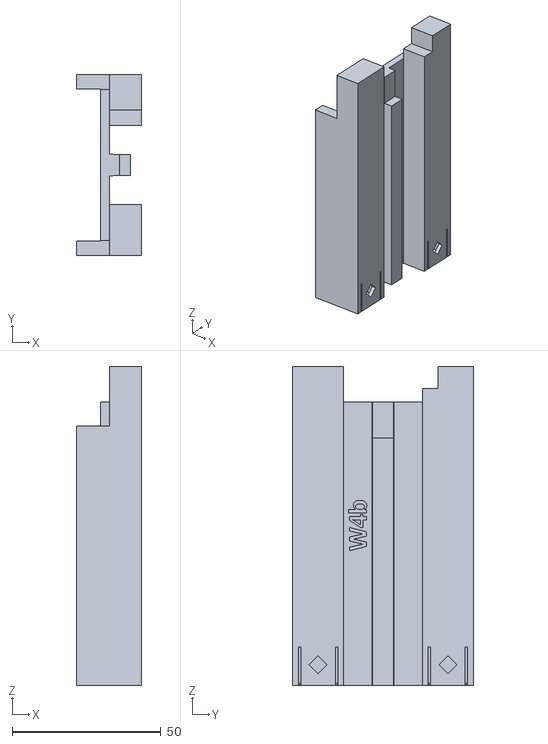
[picture p108: CAD file, 2026-11-02]
window_insert/stl/sash_4b.stl
21.7 x 60.8 x 107.2
