mmassico/window_air_vent/stl/tube_spacer.stl

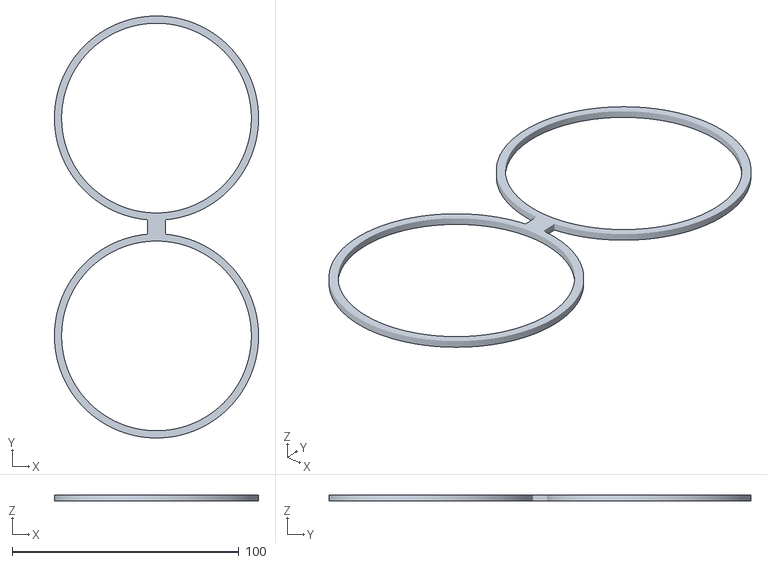
[picture p109: CAD file, 2026-10-26]
stl/tube_spacer.stl
90.0 x 186.0 x 2.50
