mmassico/window_air_vent/stl/louver_link.stl

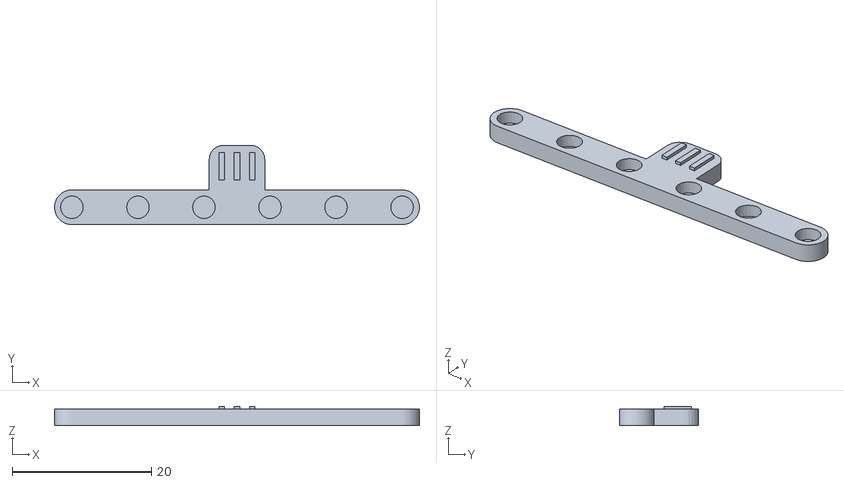
[picture p110: CAD file, 2026-10-26]
stl/louver_link.stl
52.5 x 11.4 x 2.80
