mmassico/window_air_vent/stl/louver_link_nopad.stl

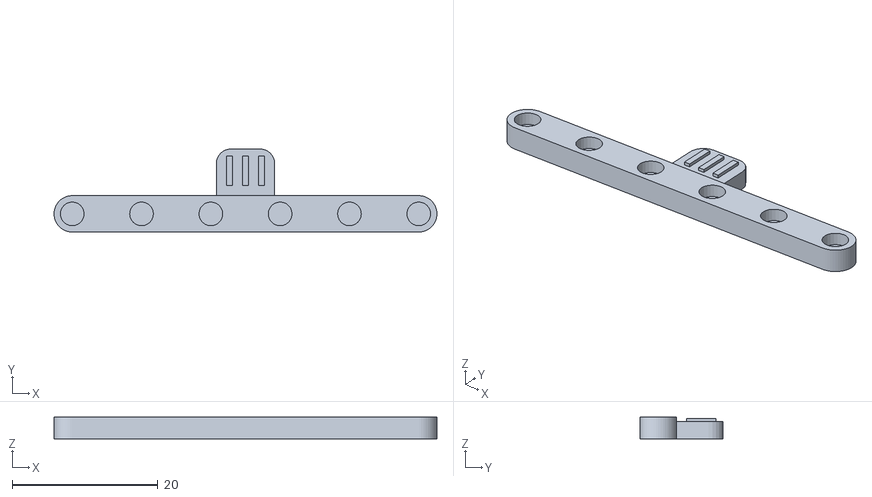
[picture p111: CAD file, 2026-10-26]
stl/louver_link_nopad.stl
52.5 x 11.4 x 3.00
