mmassico/window_air_vent/stl/louver_chassis.stl

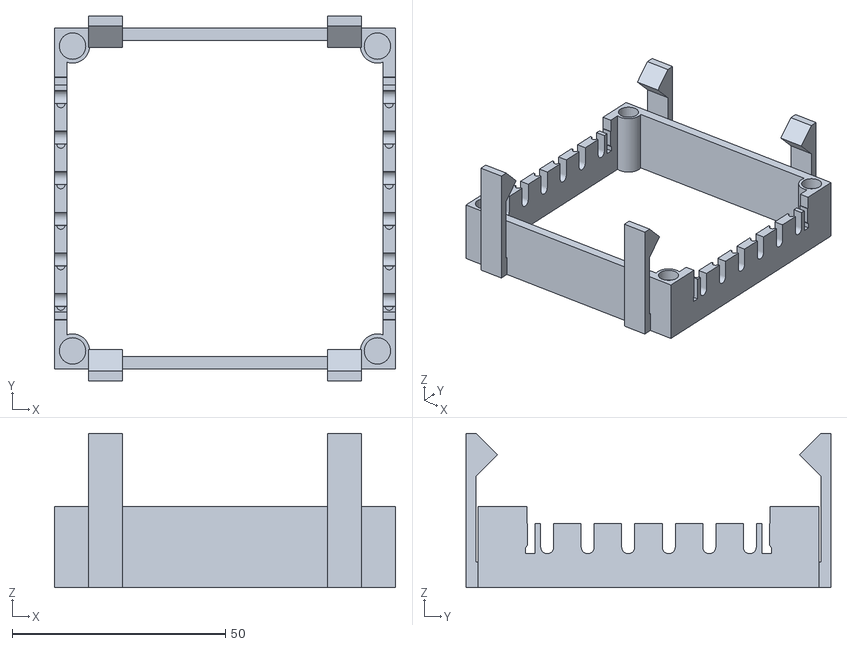
[picture p112: CAD file, 2026-10-26]
stl/louver_chassis.stl
80.0 x 85.6 x 36.2
