mmassico/window_air_vent/stl/louver_peg_test2.stl

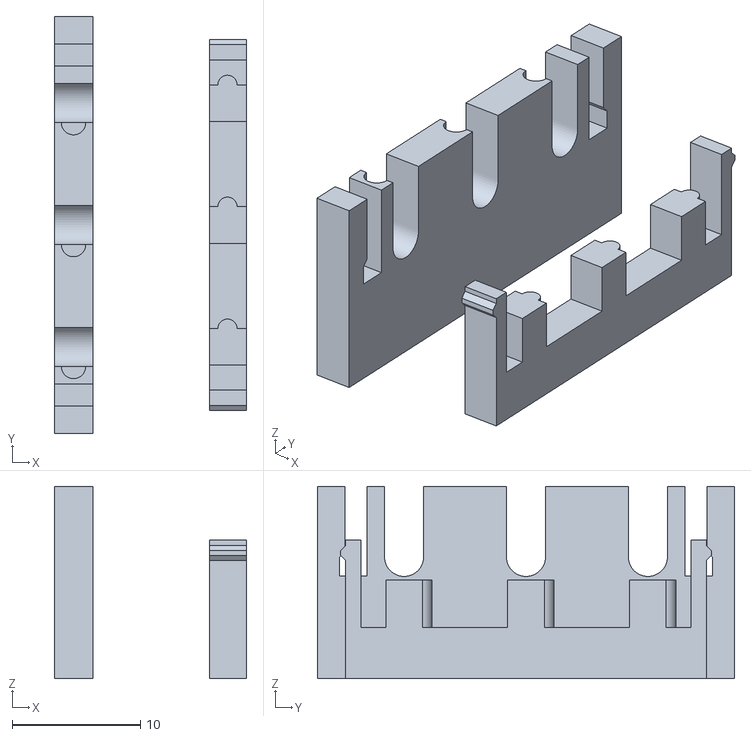
[picture p113: CAD file, 2026-10-26]
stl/louver_peg_test2.stl
15.0 x 32.5 x 15.0
