mmassico/window_air_vent/stl/louver_retainer.stl

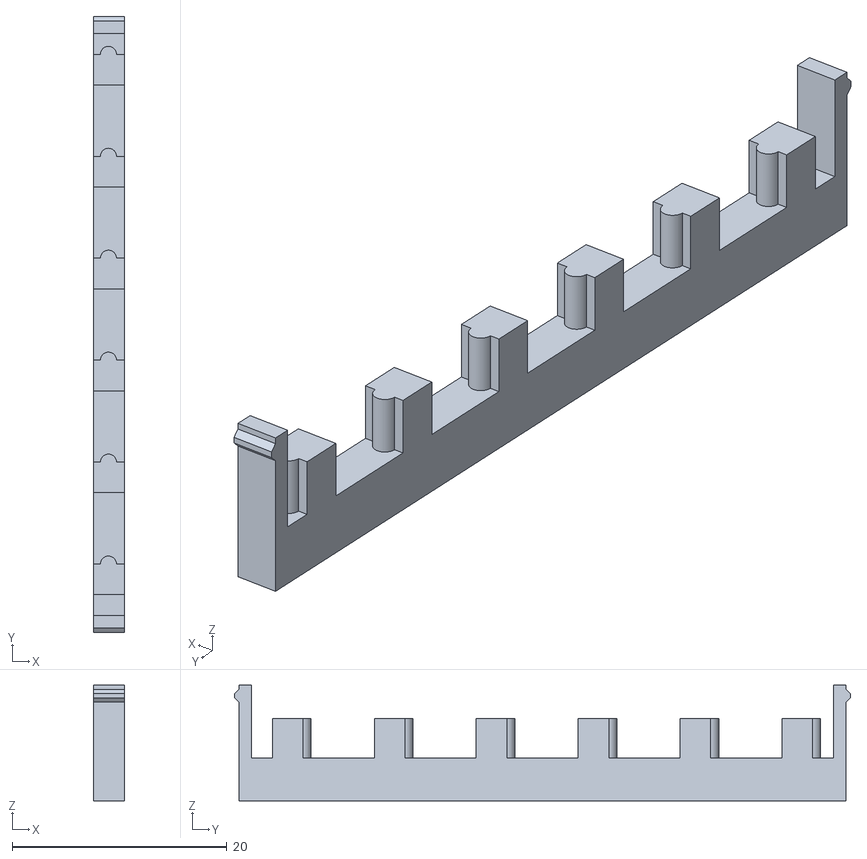
[picture p114: CAD file, 2026-10-26]
stl/louver_retainer.stl
2.90 x 57.4 x 10.8
