mmassico/window_air_vent/window_insert/stl/joiners.stl

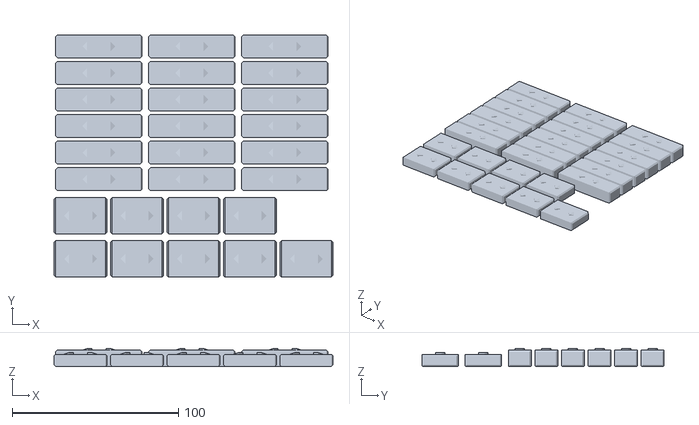
[picture p115: CAD file, 2026-11-02]
window_insert/stl/joiners.stl
168.0 x 145.8 x 10.9
