mmassico/window_air_vent/stl/fin_test.stl

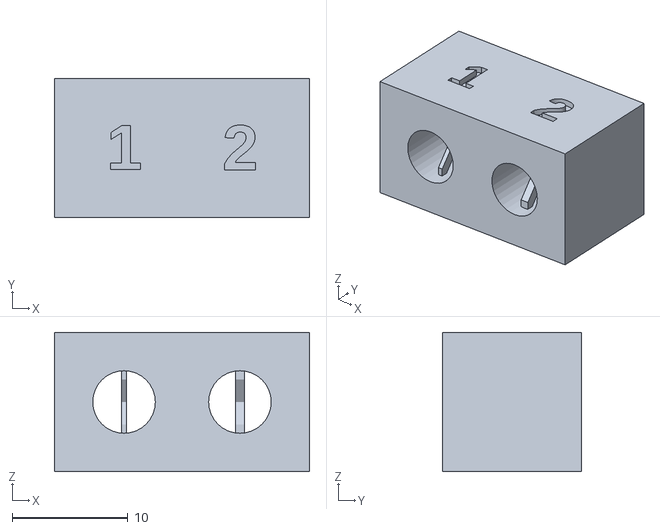
[picture p116: CAD file, 2026-10-25]
stl/fin_test.stl
22.0 x 12.0 x 12.0
