mmassico/window_air_vent/stl/ebox.stl

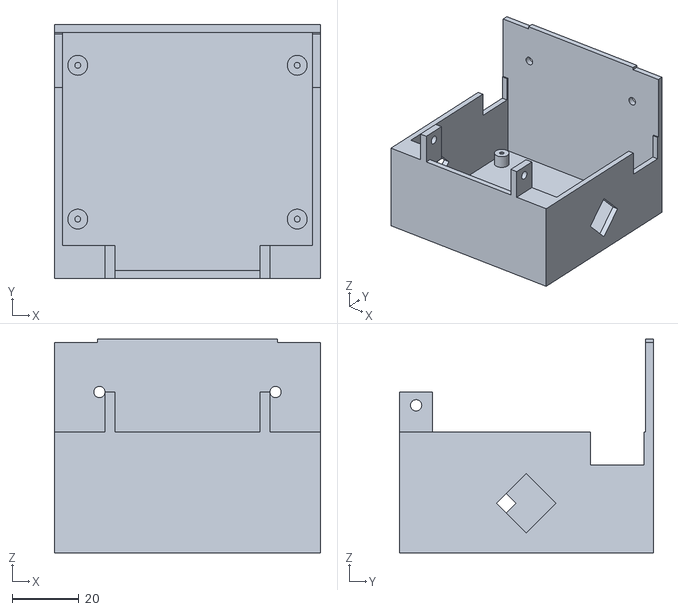
[picture p117: CAD file, 2026-10-25]
stl/ebox.stl
80.0 x 76.4 x 64.3
