mmassico/window_air_vent/stl/fittest.stl

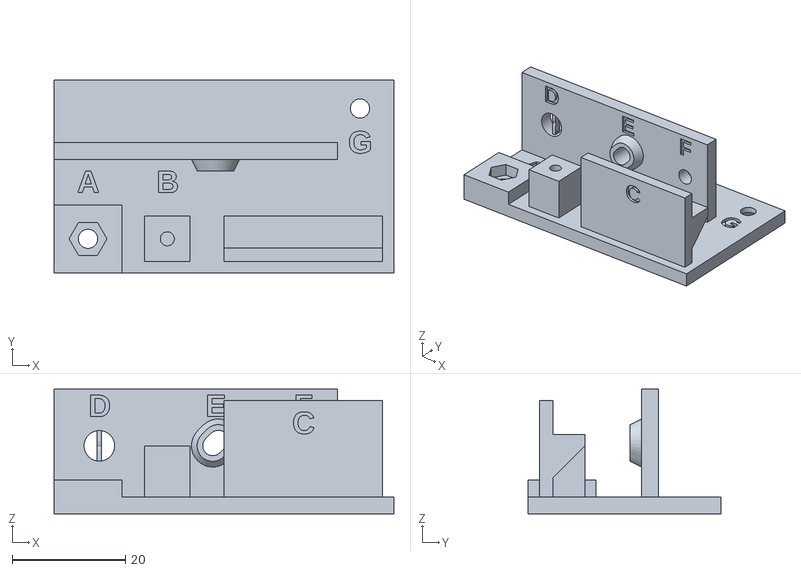
[picture p118: CAD file, 2026-10-25]
stl/fittest.stl
60.0 x 34.0 x 22.0
