mmassico/window_air_vent/stl/oring_test.stl

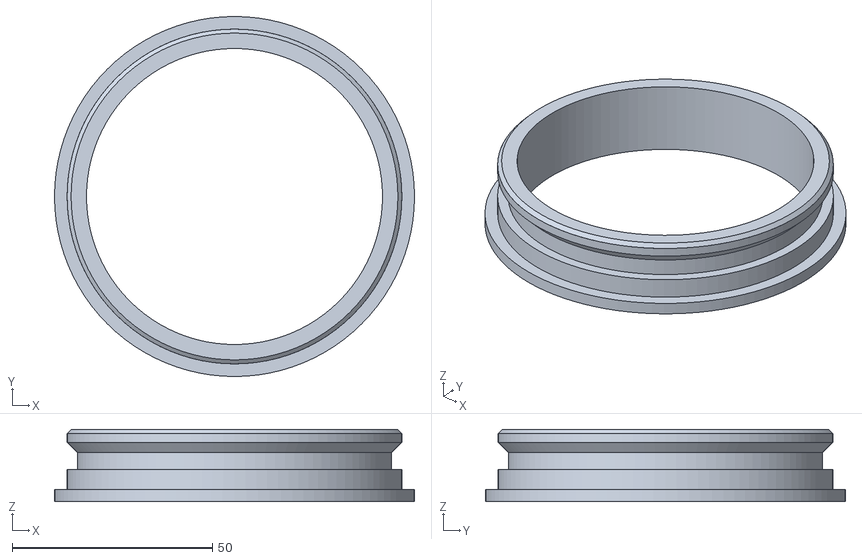
[picture p119: CAD file, 2026-10-22]
stl/oring_test.stl
90.0 x 90.0 x 18.0
