mmassico/window_air_vent/stl/motor_plate.stl

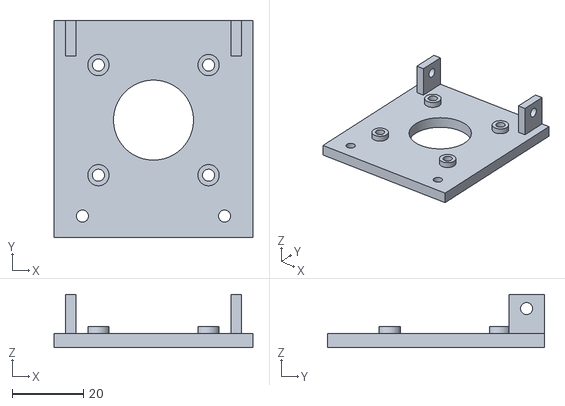
[picture p120: CAD file, 2026-10-21]
stl/motor_plate.stl
56.0 x 61.0 x 15.0
