mmassico/window_air_vent/stl/magnet_cap.stl

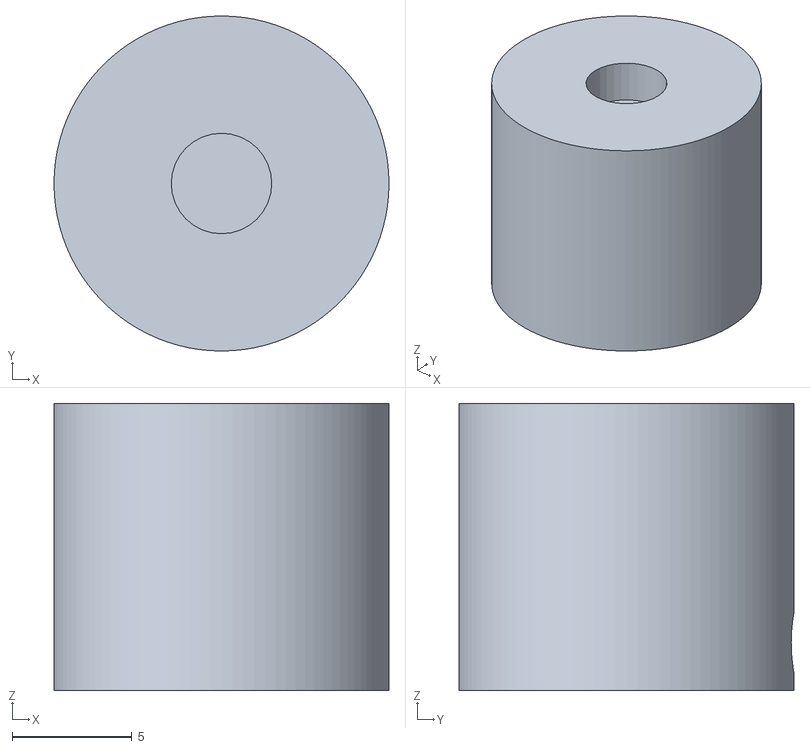
[picture p121: CAD file, 2026-10-21]
stl/magnet_cap.stl
14.0 x 14.0 x 12.0
