mmassico/window_air_vent/window_insert/stl/snap_test.stl

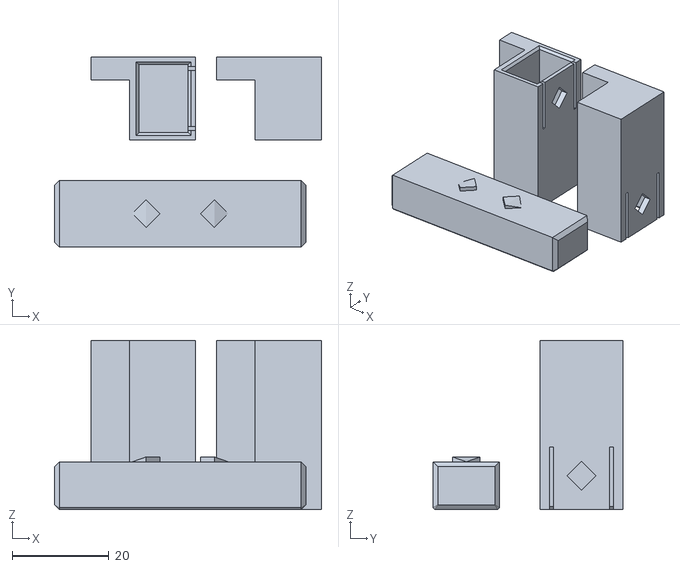
[picture p122: CAD file, 2026-11-02]
window_insert/stl/snap_test.stl
55.2 x 39.3 x 35.0
