mmassico/window_air_vent/stl/splice.stl

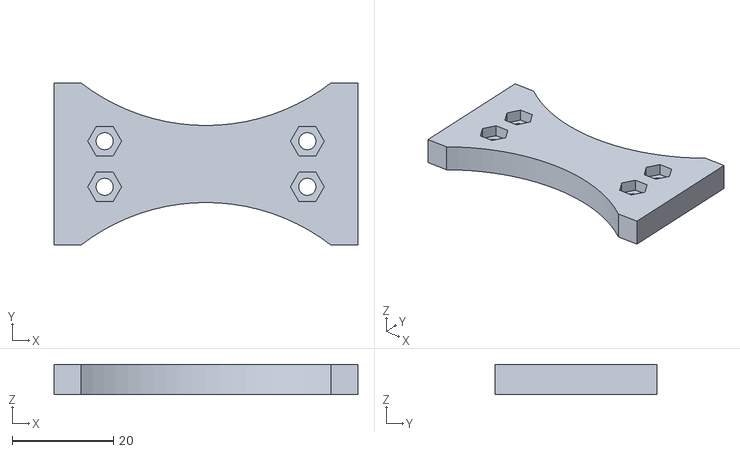
[picture p123: CAD file, 2026-10-21]
stl/splice.stl
60.0 x 32.0 x 6.00
