mmassico/window_air_vent/window_insert/stl/box_3.stl

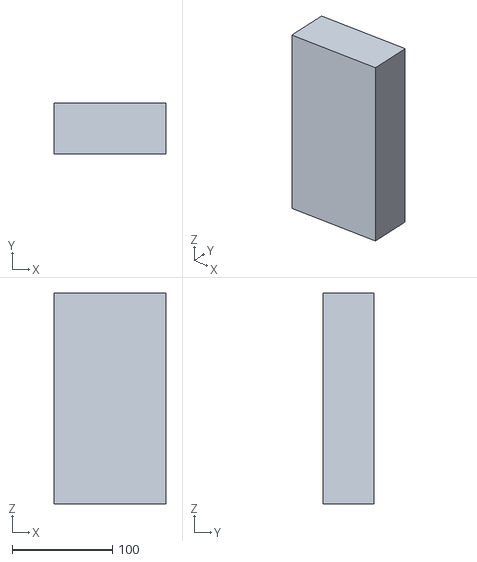
[picture p124: CAD file, 2026-11-02]
window_insert/stl/box_3.stl
111.5 x 50.8 x 210.1
