mmassico/window_air_vent/stl/louver_blade.stl

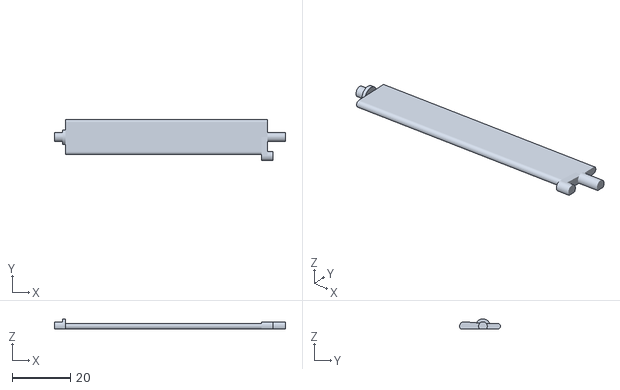
[picture p125: CAD file, 2026-10-20]
stl/louver_blade.stl
79.0 x 14.0 x 3.50
