mmassico/window_air_vent/window_insert/stl/joint_side_lower.stl

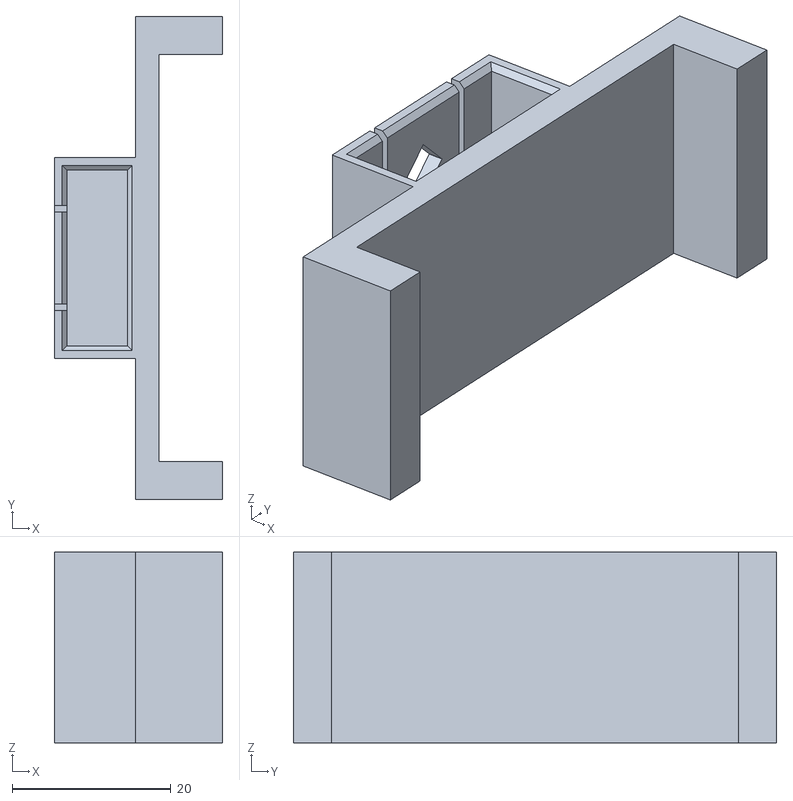
[picture p126: CAD file, 2026-11-02]
window_insert/stl/joint_side_lower.stl
21.2 x 60.8 x 24.0
