mmassico/window_air_vent/window_insert/stl/joint_side_upper.stl

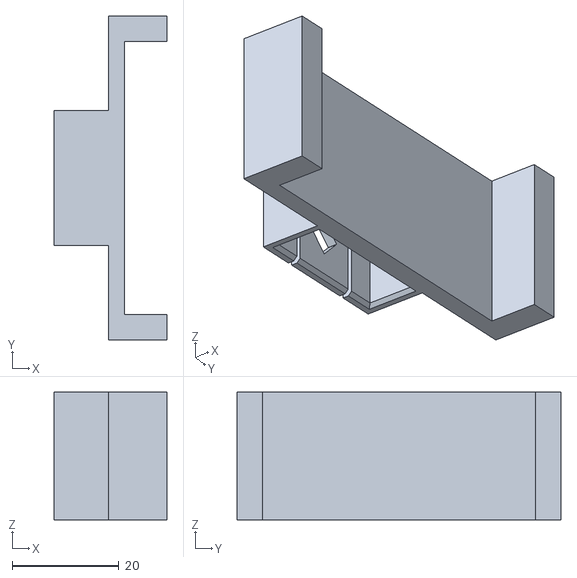
[picture p127: CAD file, 2026-11-02]
window_insert/stl/joint_side_upper.stl
21.2 x 60.8 x 24.0
