mmassico/window_air_vent/window_insert/stl/box_1c.stl

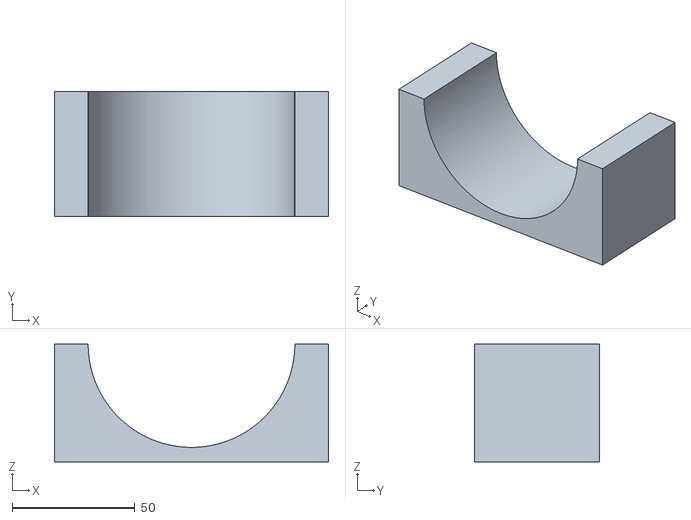
[picture p128: CAD file, 2026-11-02]
window_insert/stl/box_1c.stl
111.5 x 50.8 x 48.0
