mmassico/window_air_vent/window_insert/stl/box_1d.stl

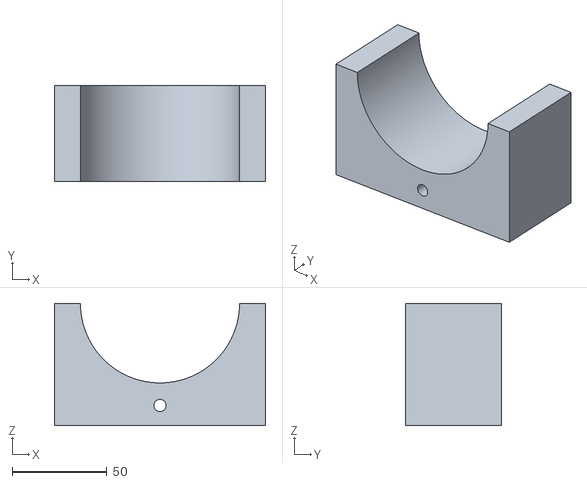
[picture p129: CAD file, 2026-11-02]
window_insert/stl/box_1d.stl
111.5 x 50.8 x 64.6
