mmassico/window_air_vent/window_insert/stl/joint_tests.stl

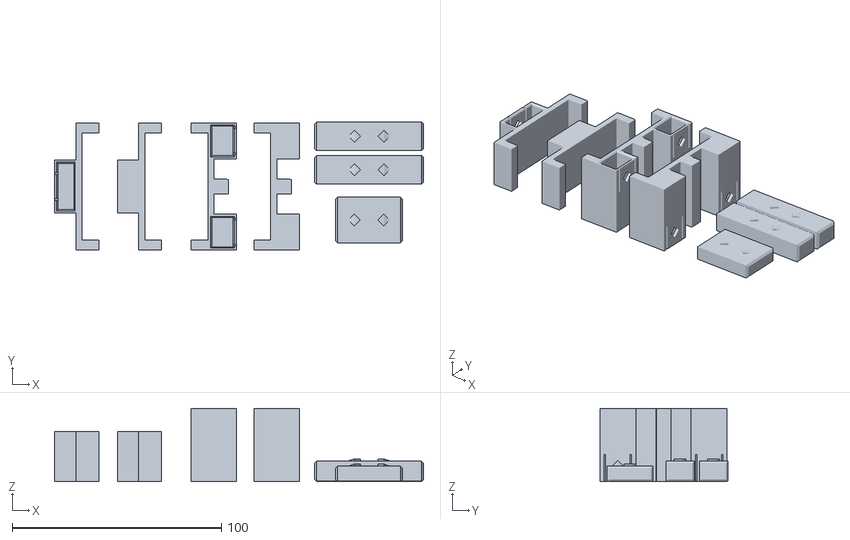
[picture p130: CAD file, 2026-11-02]
window_insert/stl/joint_tests.stl
176.2 x 61.3 x 35.0
