mmassico/window_air_vent/window_insert/stl/joiner_sash.stl

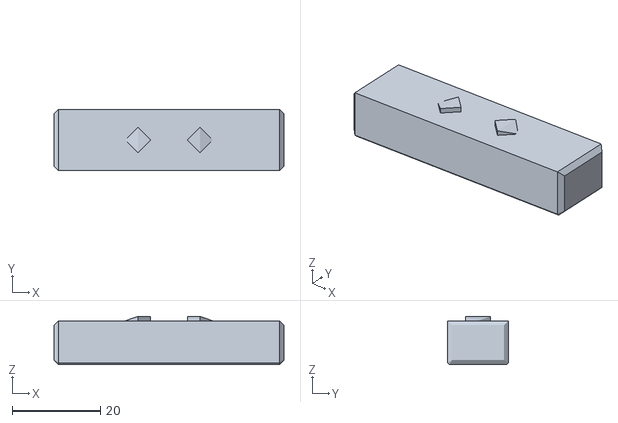
[picture p131: CAD file, 2026-11-02]
window_insert/stl/joiner_sash.stl
52.0 x 13.8 x 10.9
