mmassico/window_air_vent/window_insert/stl/bore_test.stl

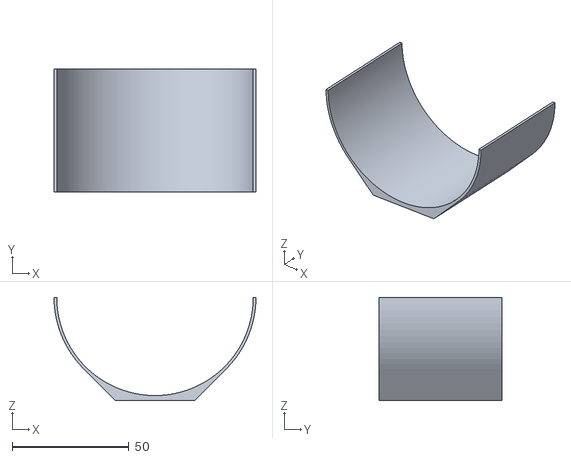
[picture p133: CAD file, 2026-11-02]
window_insert/stl/bore_test.stl
86.5 x 52.8 x 44.2
