mmassico/window_air_vent/window_insert/stl/joint_sash_upper.stl

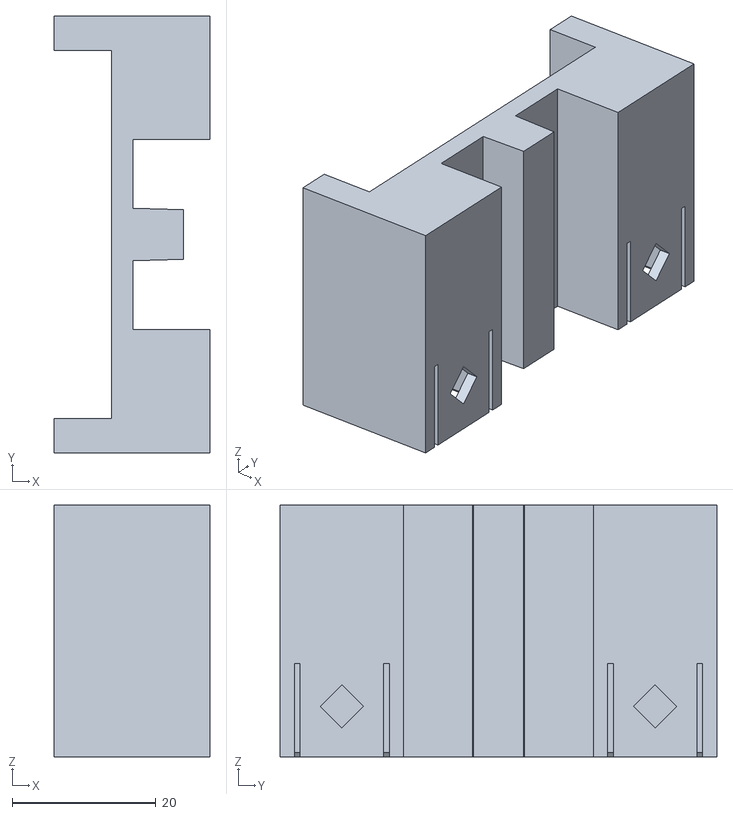
[picture p134: CAD file, 2026-11-02]
window_insert/stl/joint_sash_upper.stl
21.7 x 60.8 x 35.0
