mmassico/window_air_vent/window_insert/stl/box_1a.stl

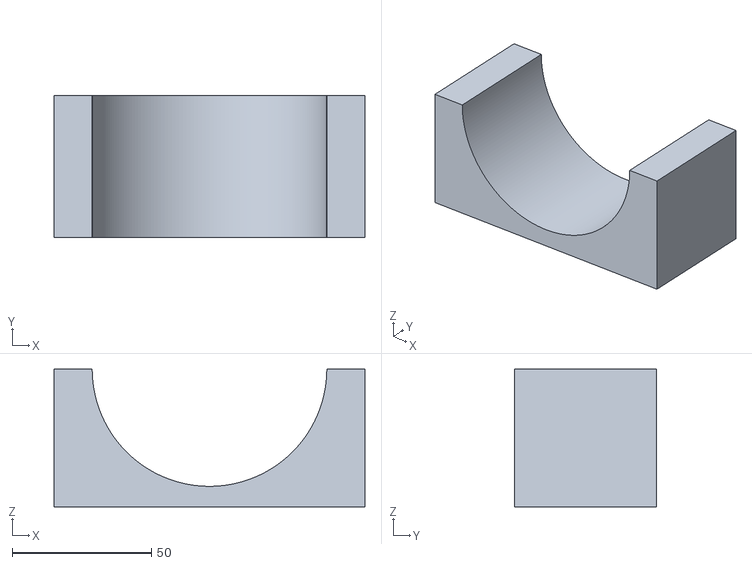
[picture p135: CAD file, 2026-11-02]
window_insert/stl/box_1a.stl
111.5 x 50.8 x 49.5
