mmassico/window_air_vent/window_insert/stl/cap_bottom.stl

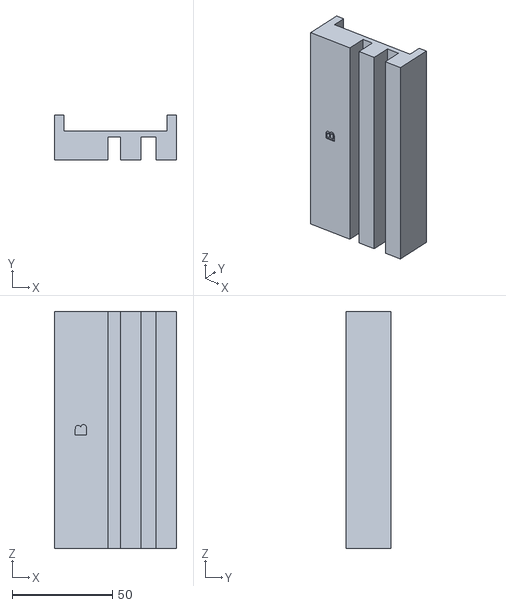
[picture p136: CAD file, 2026-11-01]
window_insert/stl/cap_bottom.stl
60.8 x 22.5 x 118.0
