mmassico/window_air_vent/window_insert/stl/cap_top.stl

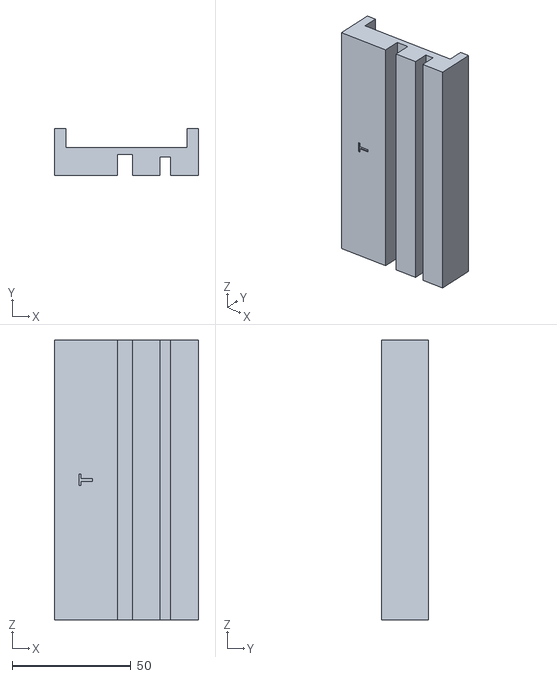
[picture p137: CAD file, 2026-11-01]
window_insert/stl/cap_top.stl
60.8 x 20.0 x 118.0
