mmassico/window_air_vent/window_insert/stl/latch_slice.stl

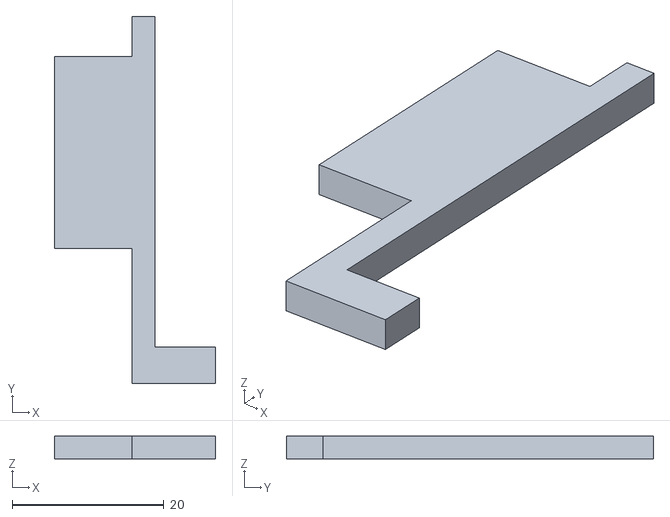
[picture p138: CAD file, 2026-11-01]
window_insert/stl/latch_slice.stl
21.2 x 48.3 x 3.00
