mmassico/window_air_vent/window_insert/stl/joiner_side.stl

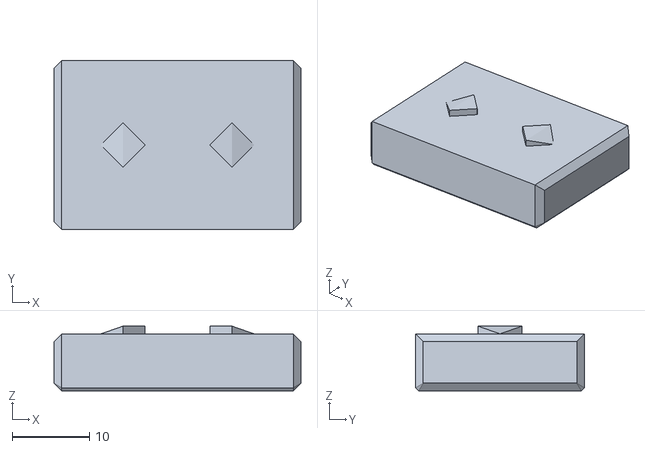
[picture p139: CAD file, 2026-11-01]
window_insert/stl/joiner_side.stl
32.0 x 21.9 x 8.40
