mmassico/window_air_vent/window_insert/stl/corner_side_top.stl

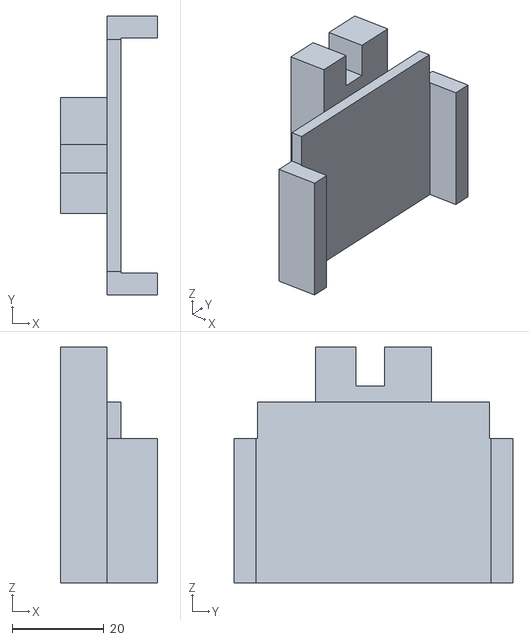
[picture p140: CAD file, 2026-11-01]
window_insert/stl/corner_side_top.stl
21.2 x 60.8 x 51.5
