mmassico/window_air_vent/window_insert/stl/corner_sash_bottom.stl

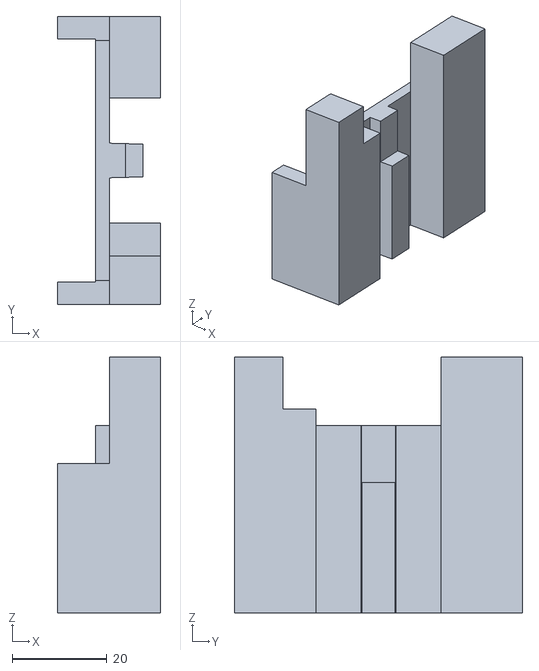
[picture p142: CAD file, 2026-11-01]
window_insert/stl/corner_sash_bottom.stl
21.7 x 60.8 x 54.0
