mmassico/window_air_vent/window_insert/stl/corner_sash_top.stl

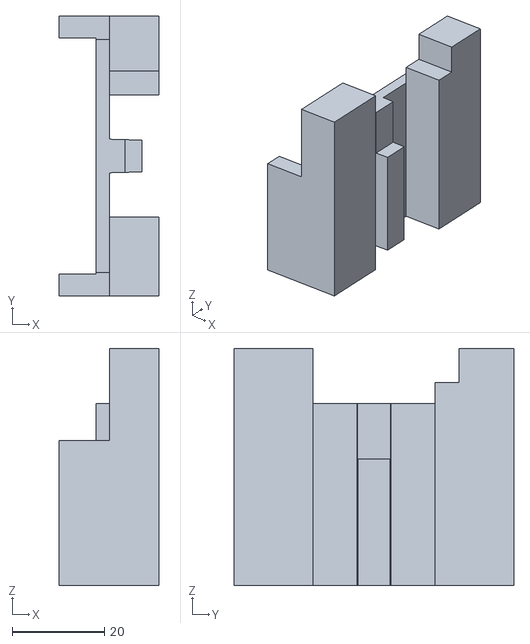
[picture p143: CAD file, 2026-11-01]
window_insert/stl/corner_sash_top.stl
21.7 x 60.8 x 51.5
