mmassico/window_air_vent/window_insert/stl/corners.stl

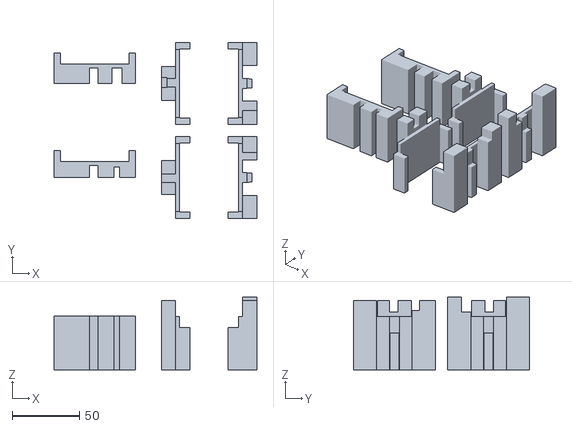
[picture p144: CAD file, 2026-11-01]
window_insert/stl/corners.stl
151.1 x 130.8 x 54.0
