mmassico/window_air_vent/window_insert/stl/corner_bottom.stl

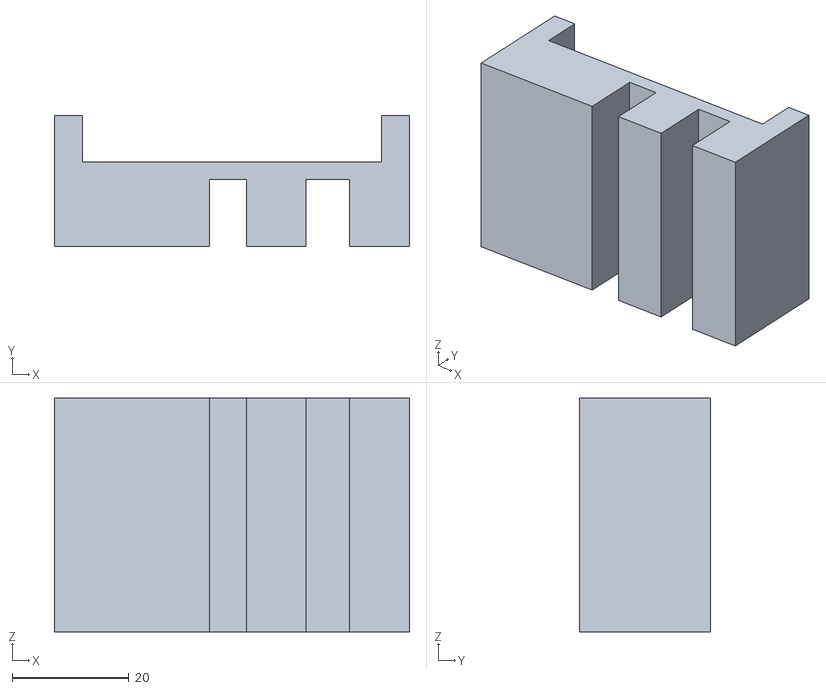
[picture p145: CAD file, 2026-11-01]
window_insert/stl/corner_bottom.stl
60.8 x 22.5 x 40.0
