mmassico/window_air_vent/window_insert/stl/corner_top.stl

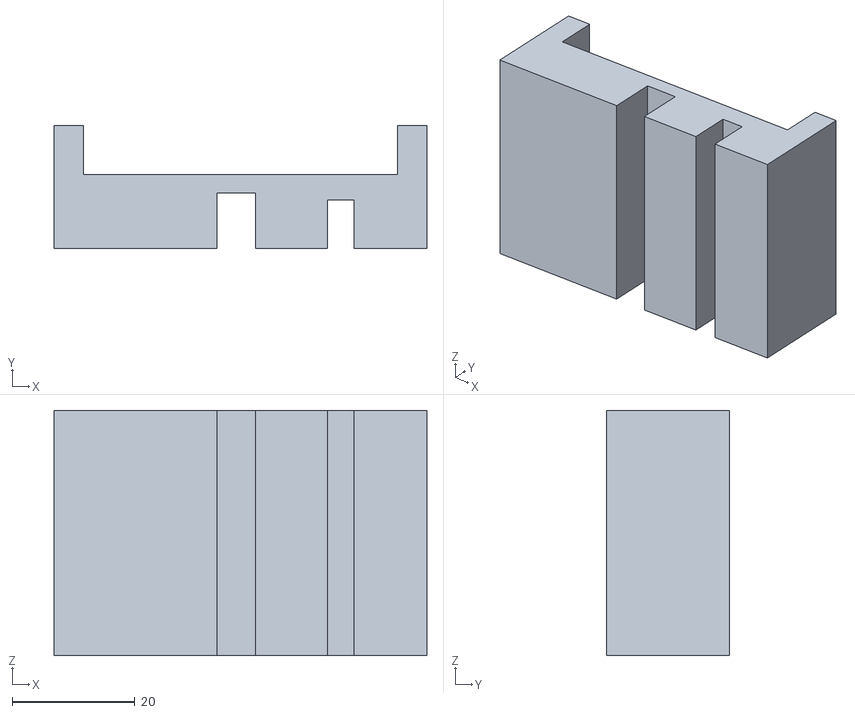
[picture p146: CAD file, 2026-11-01]
window_insert/stl/corner_top.stl
60.8 x 20.0 x 40.0
