mmassico/window_air_vent/window_insert/stl/slice_top.stl

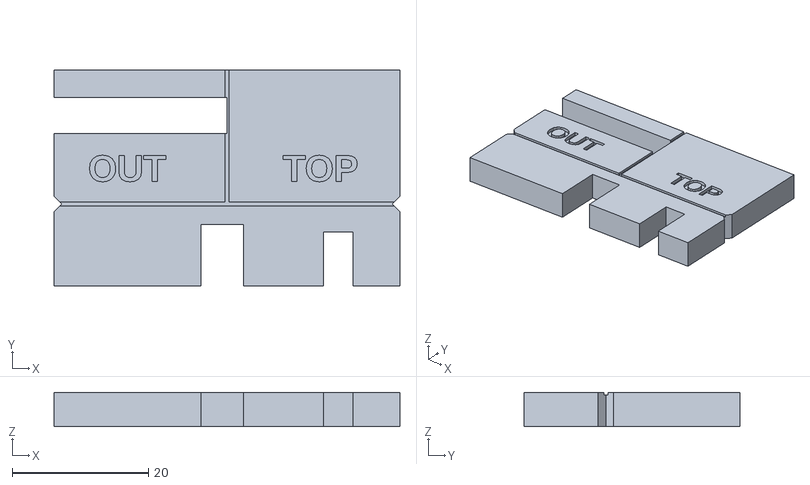
[picture p147: CAD file, 2026-10-31]
window_insert/stl/slice_top.stl
50.8 x 31.6 x 5.00
