mmassico/window_air_vent/window_insert/stl/slice_sash.stl

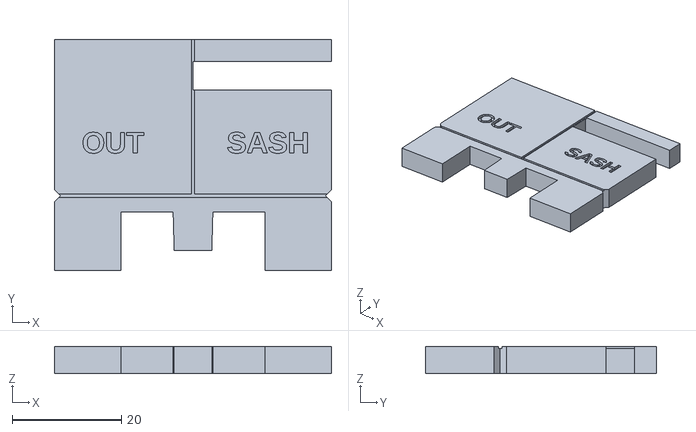
[picture p148: CAD file, 2026-10-31]
window_insert/stl/slice_sash.stl
50.8 x 42.3 x 5.00
