mmassico/window_air_vent/window_insert/stl/slices.stl

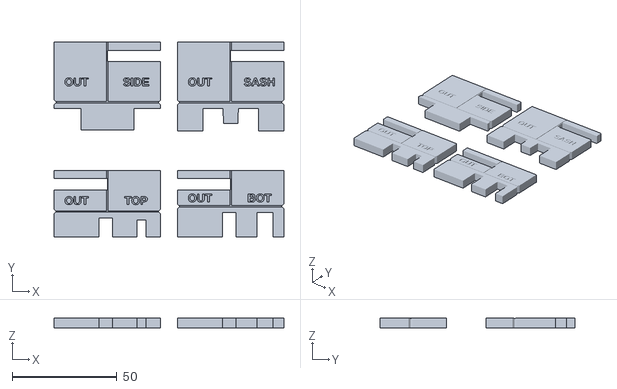
[picture p149: CAD file, 2026-10-31]
window_insert/stl/slices.stl
109.6 x 92.7 x 5.00
