mmassico/window_air_vent/window_insert/stl/slice_side.stl

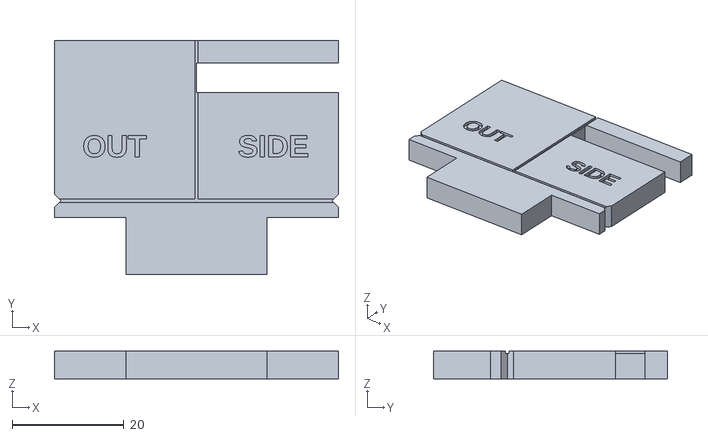
[picture p150: CAD file, 2026-10-31]
window_insert/stl/slice_side.stl
50.8 x 41.8 x 5.00
