mmassico/window_air_vent/cad/louvers.scad

// =====================================================================
//  Window vent: adjustable louvers for the intake fan (optional add-on)
//  Parametric OpenSCAD model (tested with OpenSCAD 2021.01).
//
//  * A frame clips onto the room face of the intake fan: four hooks reach
//    back over the fan's corner flanges and catch behind them. Recesses in
//    its corners fit over the fan's screw heads. A firm pull takes it off.
//  * Six horizontal blades pivot on pins at both ends, in U-slots that
//    open toward the fan: the blades drop in from behind, and the fan's
//    face closes the slots.
//  * A link bar joins an offset pin on each blade, so turning any blade
//    turns them all. The pins' snug fit in the slots holds the angle.
//  * Two retaining combs, one per side wall, plug the slots behind the
//    pins, so the blades can't come out.
//  * The link bar runs 0.2 mm from the side wall (link_nopad). Optionally,
//    a thinner bar with a strip of 1 mm felt or foam tape on its outer face
//    rubs on the wall instead, for vibration damping and friction
//    (link_pad = true). On the other side, a collar on each blade's pivot
//    bears on the wall.
//
//  Coordinates: x across (blade span), z up, y along the airflow
//  (y = 0 on the fan face, y = depth on the room side).
// =====================================================================

/* [Part to show or export] */
part  = "assembly"; // [assembly, chassis, blade, link, link_nopad, retainer, peg_test2, peg_test2_view]
angle = 30;         // [-45:5:45] blade angle in the assembly preview (positive: air deflected upward)

/* [Frame] */
fan      = 80;      // fan size (the frame matches it)
fan_hole = 71.5;    // fan screw spacing
depth    = 19;      // frame depth along the airflow (room for the link's swing)
wall     = 3;       // frame walls
tube_r   = 4;       // corner posts, over the fan's screw heads
head     = [6.2, 3.5];  // recess for the fan screw heads (diameter, depth from the back face)

/* [Clips] */
flange   = 7;       // fan corner flange, front face (with the rubber pad) to its back side
clip_w   = 8;       // clip width (along x)
clip_edge = 8;      // distance from the fan's side edge to the clip: 8+ keeps them clear of the corner screws
                    // (closer, the retainer must stay under 2.8); the fan's flange allows clips up to 16 mm from the edge
clip_lip = 5;       // how far the retainer reaches in behind the flange (the fan allows 5 for clips under 14 wide)
clip_t   = 2.4;     // arm thickness
clip_root = 6;      // the arms are joined to the frame only over its front clip_root mm, so they flex over a long length

/* [Blades] */
n_blades = 6;
pitch    = 9.5;     // blade spacing (z); the link bar's ends then clear the corner posts at 45 deg
chord    = 12;      // blade width (along the airflow when open)
thick    = 2;       // blade thickness
pin_d    = 3;       // pivot and link pins
slot_w   = 3.05;    // pivot slots: just over the pin, so the blades turn stiffly and hold their angle
pin_in   = 2.5;     // how far the pivot pins reach into the walls
arm      = 6.5;     // link pin offset from the pivot (the bar clears the pivot pins up to 45 deg)

/* [Retaining combs] */
comb_t   = 4;       // spine thickness (y), in a rebate at the back of each side wall
comb_clr = 0.3;     // pegs stop this far short of the pivot pins
comb_fit = 0.2;     // peg clearance in its slot (z) (test prints: 0.15 a bit tight, 0.25 a bit loose)
comb_key = [1.5, 0.75];   // guide ridge under each peg (width, height), in a groove in the slot's floor: it keeps the
                    //   pegs centred in the wall as the comb goes in
key_shape = "round";  // [round, v] the ridge and groove: a half-cylinder (no sharp corners for the nozzle to round off)
                    //   or a 90 deg V (with comb_key[1] = comb_key[0] / 2)
key_clr  = 0.2;     // the groove's clearance around the ridge
snap_l   = 7;       // snap arm at each end of the comb: its length past the spine (y),
snap_t   = 1.2;     //   its thickness (z),
snap_b   = 0.4;     //   and the height of the barb near its tip

/* [Link] */
link_side = "front";  // [front, back] front: the blades go in turned over, so the link runs on the room side,
                    //   where a tab on it sets the angle; back: hidden between the blades and the fan
tab_w    = 8;       // front link: the tab's width (z)
tab_out  = 4;       //   how far it sticks out of the frame at +/- 45 deg (6.5 at 0)
rib      = [3, 0.4];   //   grip ribs along the tab near its tip, across the push (up or down), on the blade side
                    //   (count, height)
link_t   = 2.4;     // link bar thickness (x)
link_w   = 5;       // link bar width (y)
link_hole = 1.6;    // blind holes for the link pins, from the blade side (the pad side stays solid)
gap      = 0.5;     // running clearance
pad_t    = 1;       // friction pad on the link bar's outer face (felt or foam tape)
pad_sq   = 0.2;     // how much the pad is squeezed against the wall
link_pad = false;   // false: link_nopad, its bar thick enough to need no strip (tested); true: the link with a felt strip
nopad_clr = 0.2;    // link_nopad: its bar's clearance to the wall
collar   = [5, 1];  // collar on each blade's pivot, plain side (diameter, thickness), 0.2 from the wall

/* [Hidden] */
$fn = 48;
eps = 0.01;
xi  = fan / 2 - wall;                         // inner face of the side walls
yp  = depth / 2;                              // pivot axis (y)
zs  = [for (i = [0 : n_blades - 1]) (i - (n_blades - 1) / 2) * pitch];   // pivot heights
x0  = -xi + 0.2 + collar[1];                  // blade end, plain side (the collar sits between it and the wall)
xl  = xi - pad_t + pad_sq - link_t;           // link bar, inner face (its pad touches the wall)
link_np_t = xi - nopad_clr - xl;              // link_nopad: its bar's thickness (it fills the pad's room)
ya  = link_side == "front" ? arm : -arm;     // the link pins' offset from the pivot axis (y), installed
comb_peg = yp - pin_d / 2 - comb_clr;         // the comb's pegs reach this far (y)
x1  = xl - gap;                               // blade end, link side

assert(max(zs) + chord / 2 < fan_hole / 2 - tube_r, "outer blades would hit the corner tubes when turned");
assert(arm * cos(45) > link_w / 2 + pin_d / 2 + 0.3, "at 45 deg the link bar would touch the pivot pins");
assert(link_side == "front" || yp - arm - link_w / 2 > 0.3, "the link bar would touch the fan");
assert(link_side == "back" || yp + arm + link_w / 2 < depth, "the link bar would stick out of the frame");

/* =================== CHASSIS =================== */
// Prints front face down (y = depth on the bed): the slots open upward, nothing overhangs.
module chassis() {
    difference() {
        union() {
            difference() {
                translate([-fan / 2, 0, -fan / 2]) cube([fan, depth, fan]);
                translate([-xi, -1, -xi]) cube([2 * xi, depth + 2, 2 * xi]);
            }
            for (dx = [-1, 1], dz = [-1, 1])   // corner posts
                translate([dx * fan_hole / 2, 0, dz * fan_hole / 2]) rotate([-90, 0, 0]) cylinder(r = tube_r, h = depth);
            clips();
        }
        for (dx = [-1, 1], dz = [-1, 1])       // recesses over the fan's screw heads
            translate([dx * fan_hole / 2, -1, dz * fan_hole / 2]) rotate([-90, 0, 0]) cylinder(d = head[0], h = head[1] + 1, $fn = 32);
        for (sx = [-1, 1])                     // rebates for the retaining combs, at the back of the side walls
            translate([sx > 0 ? xi - eps : -fan / 2 - 1, -1, zs[0] - pitch / 2]) cube([wall + 1 + eps, comb_t + 1, (n_blades) * pitch]);
        for (z = zs, sx = [-1, 1]) {           // pivot slots, open toward the fan, through the side walls
            translate([sx > 0 ? xi - 1 : -fan / 2 - 1, 0, z]) rotate([0, 90, 0]) linear_extrude(wall + 2)
                hull() { translate([0, yp]) circle(d = slot_w); translate([0, -1]) circle(d = slot_w); }
            // the comb's guide groove in the slot floor, centred in the wall, 0.2 past the peg's end
            translate([sx * (xi + wall / 2), -1, z - slot_w / 2]) comb_key_shape(comb_key[0] + 2 * key_clr, comb_key[1] + key_clr, 1 + comb_peg + 0.2);
        }
        for (sx = [0, 1]) mirror([sx, 0, 0]) {   // channels for the combs' snap arms
            snap_channel(0, -1);
            snap_channel(n_blades - 1, 1);
        }
    }
}

// Four snap hooks, top and bottom near the corners. Seen from the side, each arm lies just outside the frame
// (0.4 mm away, so it flexes freely) and is joined to it only at the front; behind the frame it runs over the fan's
// flange, then a triangular retainer with 45 deg faces reaches in behind it (both faces print without overhang).
module clips() {
    g  = 0.4;                        // arm to frame gap
    z0 = fan / 2 + g;                // arm inner face
    yc = -(flange + 0.2);            // where the retainer starts (0.2 mm clearance behind the flange)
    for (sx = [-1, 1], sz = [-1, 1])
        translate([sx * (fan / 2 - clip_edge - clip_w / 2) - clip_w / 2, 0, 0]) mirror([0, 0, sz < 0 ? 1 : 0])
            rotate([90, 0, 90]) linear_extrude(clip_w) polygon([
                [depth, fan / 2 - eps], [depth, z0 + clip_t], [yc - 2 * clip_lip, z0 + clip_t], [yc - 2 * clip_lip, z0],
                [yc - clip_lip, z0 - clip_lip], [yc, z0], [depth - clip_root, z0], [depth - clip_root, fan / 2 - eps]]);
}

/* =================== BLADE =================== */
// Modelled open (chord along y), pivot axis on the x axis. Prints flat: the pins are flattened on the bed side.
module blade() {
    intersection() {
        union() {
            translate([x0, 0, 0]) rotate([0, 90, 0]) linear_extrude(x1 - x0)   // rounded-edge slat
                hull() for (s = [-1, 1]) translate([0, s * (chord / 2 - thick / 2)]) circle(d = thick);
            translate([-xi - pin_in, 0, 0]) rotate([0, 90, 0]) cylinder(d = pin_d, h = x0 + xi + pin_in + eps);   // pivot, plain side
            translate([x0 - collar[1], 0, 0]) rotate([0, 90, 0]) cylinder(d = collar[0], h = collar[1] + eps);       // collar
            translate([x1 - eps, 0, 0]) rotate([0, 90, 0]) cylinder(d = pin_d, h = xi + pin_in - x1 + eps);       // pivot, link side
            translate([x1 - eps, -arm, 0]) rotate([0, 90, 0]) cylinder(d = pin_d, h = gap + link_hole - 0.2 + eps); // link pin
            hull() {   // arm carrying the link pin, inside the blade's end
                translate([x1 - 2, 0, 0]) rotate([0, 90, 0]) cylinder(d = thick, h = 2);
                translate([x1 - 2, -arm, 0]) rotate([0, 90, 0]) cylinder(d = pin_d, h = 2);
            }
        }
        translate([-fan, -fan, -thick / 2]) cube([2 * fan, 2 * fan, fan]);   // flat underside for printing
    }
}

/* =================== RETAINING COMB =================== */
// Modelled in place in the +x wall (mirror it for the other one). A spine in the wall's back rebate, and a peg
// in each slot up to just short of the pivot pin. Prints flat, spine down.
// Each peg has a guide ridge along its underside, in a groove in the slot's floor. Past each end peg, a snap arm
// runs from the spine into its own channel through the wall, parallel to the pegs, 7 mm long so it flexes easily:
// a barb near its tip (45 deg faces) pushes it toward the pegs as it goes in, then clicks into a pocket at the
// bottom of the channel. A firm pull takes the comb out again (45 deg catch). Once the frame is on the fan, the
// fan's face holds the combs in anyway.
// i0, i1: its first and last pegs (0-based; the peg test makes a short one).
module retainer(i0 = 0, i1 = n_blades - 1) {
    zr = [zs[i0] - pitch / 2 + 0.2, zs[i1] + pitch / 2 - 0.2];
    snap_arm(i0, -1);
    snap_arm(i1, 1);
    translate([xi + 0.1, 0, 0]) {
        translate([0, 0, zr[0]]) cube([wall - 0.1, comb_t, zr[1] - zr[0]]);
        for (i = [i0 : i1]) {
            w = slot_w - comb_fit;
            translate([0, 0, zs[i] - w / 2]) {
                cube([wall - 0.1, comb_peg, w]);
                translate([wall / 2 - 0.1, 0, eps]) comb_key_shape(comb_key[0], comb_key[1] + eps, comb_peg);
            }
        }
    }
}
// the ridge or groove profile (width b, reaching down by h: a half-ellipse, a half-circle when h = b / 2, or a
// triangle), along y from 0 to len, its flat side centred on the origin
module comb_key_shape(b, h, len) rotate([-90, 0, 0]) linear_extrude(len)
    if (key_shape == "v") polygon([[-b / 2, 0], [b / 2, 0], [0, h]]);
    else intersection() { scale([1, 2 * h / b]) circle(d = b, $fn = 48); translate([-b, 0]) square(2 * b); }
// The arm and barb (comb), or the channel and pocket (wall, with clearances), past peg i, on side s (+1: up, -1: down).
// Drawn in (y, u), u outward from the arm's outer face, which is flush with the end of the spine.
module snap_arm(i, s) {
    zo = zs[i] + s * (pitch / 2 - 0.2);
    cd = comb_t + snap_l;
    translate([xi + 0.1, 0, 0]) rotate([90, 0, 90]) linear_extrude(wall - 0.1) polygon([for (q = [
        [comb_t - eps, -snap_t], [cd - 0.2, -snap_t], [cd - 0.2, 0],
        [cd - 0.6, 0], [cd - 0.6 - snap_b, snap_b], [cd - 1.0 - snap_b, snap_b],
        [cd - 1.0 - 2 * snap_b, 0], [comb_t - eps, 0]]) [q[0], zo + s * q[1]]]);
}
module snap_channel(i, s) {
    zo = zs[i] + s * (pitch / 2 - 0.2);
    cd = comb_t + snap_l;
    gi = snap_b + 0.05;   // room on the inner side for the arm to flex into
    yb = cd - 1.0 - 2 * snap_b;   // where the barb's catch face starts
    translate([xi - 1, 0, 0]) rotate([90, 0, 90]) linear_extrude(wall + 2) polygon([for (q = [
        [-1, -snap_t - gi], [cd, -snap_t - gi], [cd, snap_b + 0.1],
        [yb - 0.15 + snap_b + 0.1, snap_b + 0.1], [yb - 0.15, 0.05], [-1, 0.05]]) [q[0], zo + s * q[1]]]);
}

/* =================== LINK =================== */
// Prints flat. Modelled in place for the open position (blade angle 0). In front, it carries a tab in its middle,
// reaching out of the frame's front at every angle (the bar draws back by arm * (1 - cos a) as the blades turn).
// tb: the bar's thickness, link_t (with the felt strip) or link_np_t (link_nopad, no strip). The tab keeps link_t,
// flush with the bar's outer face, so both lie on the bed when printing.
module link(tb = link_t) {
    tab_l = depth + tab_out - (yp + arm * cos(45));   // the tab's reach, from the link pins' line
    y1 = yp + ya + tab_l;                              // its tip
    xt = xl + tb - link_t;                             // the tab's inner face
    difference() {
        union() {
            hull() for (z = [zs[0], zs[n_blades - 1]]) translate([xl, yp + ya, z]) rotate([0, 90, 0]) cylinder(d = link_w, h = tb);
            if (link_side == "front") {
                translate([xt, 0, 0]) rotate([90, 0, 90]) linear_extrude(link_t) hull() {   // drawn in (y, z)
                    translate([yp + ya, -tab_w / 2]) square([eps, tab_w]);
                    for (s = [-1, 1]) translate([y1 - 2, s * (tab_w / 2 - 2)]) circle(r = 2, $fn = 24);
                }
                for (i = [0 : rib[0] - 1])   // grip ribs along the tab, on the blade side (up when printing), clear of the blades
                    translate([xt - rib[1], y1 - 5, (i - (rib[0] - 1) / 2) * 2.2 - 0.4]) cube([rib[1] + eps, 4, 0.8]);
            }
        }
        for (z = zs) translate([xl - 1, yp + ya, z]) rotate([0, 90, 0]) cylinder(d = pin_d + 0.25, h = 1 + link_hole, $fn = 24);
    }
}

// The friction pad (bought: felt or foam tape), on the link bar's outer face, for the preview only.
module pad() hull() for (z = [zs[0], zs[n_blades - 1]]) translate([xl + link_t, yp + ya, z]) rotate([0, 90, 0]) cylinder(d = link_w, h = pad_t - pad_sq);

/* =================== PREVIEW =================== */
// The blade is modelled with its link pin toward the fan; in front, it goes in turned over (the same printed part).
module blade_at(z, a) translate([0, yp, z]) rotate([a + (link_side == "front" ? 180 : 0), 0, 0]) blade();
// the link follows the link pins: they turn about the pivot axis with the blades
module link_at(a) translate([0, ya * cos(a) - ya, ya * sin(a)]) link(link_pad ? link_t : link_np_t);

module assembly(a = angle) {
    color([0.85, 0.85, 0.88]) chassis();
    for (z = zs) color([0.55, 0.75, 0.95]) blade_at(z, a);
    color([0.95, 0.6, 0.25]) link_at(a);
    for (sx = [0, 1]) color([0.4, 0.75, 0.4]) mirror([sx, 0, 0]) retainer();
    if (link_pad) color([0.3, 0.3, 0.3]) translate([0, ya * cos(a) - ya, ya * sin(a)]) pad();
    %translate([-fan / 2, -25, -fan / 2]) cube([fan, 25, fan]);   // the fan (ghost)
}

if (part == "assembly") assembly();
if (part == "chassis")  translate([0, 0, depth]) rotate([-90, 0, 0]) chassis();              // front face on the bed
if (part == "blade")    translate([-x0 + pin_in + 3, 0, thick / 2]) blade();                  // flat, flattened pins down
if (part == "link")     rotate([0, 90, 0]) translate([-(xl + link_t), 0, 0]) link();   // flat, holes up
if (part == "link_nopad") rotate([0, 90, 0]) translate([-(xl + link_np_t), 0, 0]) link(link_np_t);   // the same, no felt
if (part == "retainer") rotate([90, 0, 0]) translate([-xi, 0, 0]) retainer();   // x2, spine down, pegs up
if (part == "peg_test2") peg_test2();
if (part == "peg_test2_view") peg_test2_view();

/* =================== PEG TEST (optional) =================== */
// The combs' fit without printing the whole frame: a slice of the +x side wall with three slots, cut from the
// chassis itself (so the same rebate, slots, grooves and snap channels), front face on the bed as the chassis
// prints; and a three-peg comb with its snap arms beside it, spine down.
module peg_test2_wall() {
    z0 = zs[1] - pitch / 2 - 2;
    difference() {
        intersection() {
            chassis();
            translate([xi - 1, -1, z0]) cube([wall + 2, depth + 2, 3 * pitch + 4]);
        }
        snap_channel(1, -1);
        snap_channel(3, 1);
    }
}
module peg_test2_comb() retainer(1, 3);
module peg_test2() {
    translate([0, 0, depth]) rotate([-90, 0, 0]) translate([-xi, 0, -zs[2]]) peg_test2_wall();
    translate([12, 0, 0]) rotate([90, 0, 0]) translate([-xi, 0, -zs[2]]) peg_test2_comb();
}
// in place, cut through the middle of the wall: how the arms sit in their channels
module peg_test2_view() intersection() {
    union() { color([0.8, 0.8, 0.85]) peg_test2_wall(); color([0.3, 0.7, 0.35]) peg_test2_comb(); }
    translate([xi + wall / 2, -2, zs[0]]) cube([wall, depth + 4, 4 * pitch]);
}
