mmassico/window_air_vent/cad/window_vent.scad

// =====================================================================
//  Window vent: dual butterfly damper with two 80 mm fans (prototype)
//  Parametric OpenSCAD model (tested with OpenSCAD 2021.01).
//
//  * A foam insert fills the window gap (about 100 mm wide). Two 83 mm
//    holes, stacked vertically, go through it: exhaust on top, intake
//    below (the cold air comes in low, the warm exhaust leaves high, so
//    neither loops back into the other).
//  * This housing sits on the ROOM face of the foam (warm side, so no
//    ice on the moving parts). Its spigots slide into the foam holes and
//    fit snugly (two O-rings each are optional).
//  * One vertical 5 mm shaft runs through both ducts and carries a
//    butterfly disc in each, so a quarter turn opens or closes both.
//    A NEMA 17 pancake stepper drives it from the top; an AS5600 magnetic
//    encoder reads the shaft angle at the bottom.
//  * Each disc closes against two half-ring lips (lined with thin foam
//    tape), one on each side of the shaft: the classic butterfly seat.
//  * Two 80 mm fans screw onto the room end.
//
//  Coordinates (installed): x across the window, y toward the room
//  (y = 0 on the room face of the foam), z up.
// =====================================================================

/* [Part to show or export] */
part  = "assembly"; // [assembly, tray, tray_feet, tray_test, tray_view, assembly_noplug, assembly_spc, body, disc, disc_nofoam, motor_plate, magnet_cap, ebox, fittest, fin_test, oring_test, assembly_nofan, body_top, body_bottom, splice, split_view, split_assembly, ebox_elec, ebox_elec_alt, drill_guide, foam_guide_a, foam_guide_b, tube_spacer, screen_frame, screen_test]
angle = 30;         // [0:5:90] damper opening in the assembly preview (0 = closed)

/* [Ducts and foam] */
duct_id   = 74;     // duct bore (80 mm fans have about a 76 mm blade circle)
wall      = 2.4;    // duct wall (6 perimeters at 0.4 mm)
pitch     = 96;     // vertical distance between the two duct centres
sp_len    = 25;     // spigot length inside the foam hole
sp_od     = 83.7;   // spigot OD: snug in the foam hole, about 0.4 mm of squeeze in XPS. The 3-1/4 in hole saw measures
                    //   83.3 across its teeth, so its hole is about 83.3 (doc/holesaw_83.svg);
                    //   a tight hole can be sanded, a loose one takes the O-rings
sp_lead   = 1;      // 45 deg lead-in chamfer on the spigot tip, so it enters the foam without tearing it
sp_wall   = 4;      // spigot wall at its tip: the bore widens from duct_id at the stop ring to sp_od - 2 sp_wall at
                    //   the tip, so condensation runs out toward the outdoor end
orings    = false;  // O-ring grooves in the housing's spigots: off, the plain spigot grips the foam along its whole
                    //   length; on, for 74 x 3 O-rings in a hole that came out loose (oring_test always has one)
oring_cs  = 3;      // O-ring cross-section (default: 74 x 3 mm O-rings; optional, see sp_od)
oring_floor = 78.5; // groove floor diameter: the 74 x 3 O-rings stretch about 6%, squeeze about 20% in an 83.3 hole;
                    //   width is 1.4 x cs
oring_pos = [6, 16];// groove starts, measured from the foam face into the foam
oring_slope = true; // 45 deg groove wall on the spigot-tip side: the spigots print tip up, so that wall would
                    // otherwise be a flat overhang; floor depth (squeeze) and the other wall are unchanged
stop_od   = 90;     // stop ring that rests on the room face of the foam
stop_t    = 3;
spacer   = [2.5, -0.05, 8];  // tube_spacer (optional): thickness, clearance on the spigots (negative: a press fit;
                    //   0.2 and 0.05 were loose), width of the bridge between its two rings (it grips both spigots
                    //   against the stop rings, so their ends can't spread)

/* [Damper] */
ys       = 43;      // shaft position, from the foam face
duct_len = 89;      // foam face to the fan face of the housing
disc_t   = 3;       // disc plate thickness
hc       = 5.5;     // shaft axis above the disc plate bottom (the disc prints flat, hub up)
hub_w    = 10;      // hub width
hub_l    = 40;      // hub length along the shaft
hub_h    = 14;      // hub height above the plate bottom
grub_n   = 2;       // [1:1:3] M3 grub screws per disc (2 = no rocking on the shaft)
grub_sp  = 24;      // spacing between them along the shaft
gasket   = 1;       // foam tape thickness on the lips (sets the lips' position in the housing)
// The housing stays as printed (lips placed by gasket); each disc seat moves instead, by seat_rlf: [0] half A's face
// (lowered when positive, raised when negative), [1] half B's bevel (set back square to the slope when positive,
// brought forward when negative). The gap at a seat is then gasket + seat_rlf, less 0.1 on A and plus 0.07 on B: the
// grub screws press the shaft into one side of its bore (0.2 larger), which moves the disc 0.1 toward lip A.
lip_foam  = true;          // false: no lip foam, the disc closes on the bare lips (disc_nofoam)
seat_foam = [0.6, 0.5];    // with 1.6 mm neoprene: gaps 1.5 (A, face at 2.4) and 1.57 (B), squeezed lightly
                           // (at gasket = 1 with no relief, a finger could not close the disc)
seat_bare = [-0.6, -0.8];  // without foam: gaps 0.3 (A, face at 3.6) and 0.27 (B). Smaller risks a binding disc
seat_rlf  = lip_foam ? seat_foam : seat_bare;
lip_ovl  = 2;       // lips overlap the disc edge by this much
lip_t    = 2;       // lip thickness (along the flow)
lip_gap  = 7;       // no lip within this distance of the shaft (clears the hub and the edge-on disc)
disc_bev = 2;       // 45 deg bevel on the foam-side rim of the disc half that closes against lip B (engraved B);
                    // lip B is a matching 45 deg cone, so neither prints a flat overhang
dam_h    = 3;       // drip dam near the fan end, on the lower part of each bore (sizes the disc; its inner face follows the disc sweep)
dam_ang  = 60;      // the dam covers +/- this angle from the bottom of the bore
sboss_d  = 16;      // bosses around both shaft holes inside each duct: at the bottom, water flows around it
                    // instead of down the shaft; at both ends, they close the gap the lips leave around the shaft
flat_boss = true;   // the bosses' inner faces are flat, square to the shaft, and the disc's two shaft ends are cut to
                    // matching flats. A flat end turning about the shaft stays in its plane, so the gap is fboss_clr
                    // at every angle. false: the first design (v1), curved faces coaxial with the bore (0.75 mm gap
                    // closed, 0.3 at worst). Housing and discs must match: print discs with false for a v1 housing
fboss_clr = 0.2;    // flat_boss: gap between each disc flat and its boss face (0.4 in all along the shaft: centre the
                    // disc with 0.2 mm shims before tightening its grub screws)
sboss_clr = 0.3;    // flat_boss = false: the curved face sits this far outside the disc's sweep

/* [Fans] */
fan       = 80;     // fan frame size
fan_t     = 25;
fan_hole  = 71.5;   // fan screw spacing (80 mm fans)
fan_plate = 6;      // fan plate thickness; M3 nuts sit in pockets on its back

/* [Shaft, motor and encoder] */
shaft_d   = 5;      // steel rod, same as the NEMA 17 shaft
shaft_clr = 0.4;    // clearance in the bearing holes
fin_t     = 0.8;    // sacrificial X fin in the bearing holes, horizontal when printing (two 0.4 mm nozzle lines; 0 = none):
                    //   it holds up the top of the hole instead of slicer supports; drill it out with the bit
boss_h    = 4;      // bearing bosses on the duct walls
nema      = 42.3;   // NEMA 17 frame
nema_hole = 31;     // NEMA 17 screw spacing (M3)
nema_boss = 22;     // NEMA 17 centring boss
coupler_room = 31;  // space under the frame for a 5-5 mm flexible coupler (19 x 25 mm)
mp_t      = 3;      // motor frame (the tower's roof) thickness, the same as the walls
mplate    = 56;     // motor plate width; it covers the top of the tower from its open back to just past the front screws. The motor screws to it
mplate_t  = 4;      //   on the bench, then it goes on the frame: two screws in front of the motor (M3 x 10 + nuts,
mp_front  = [20, 27];  //   from the tower's open front), at x = +/- [0], [1] in front of the shaft, and two tabs at the back
mp_tab    = [3, 10, 8];  // back tabs (thickness, width, depth below the frame), flush with the back edge: through notches in the frame, against the
                    //   inner faces of the tower walls, one M3 + nut each through the wall
mp_boss   = [6, 2]; // motor screw bosses under the plate (diameter, height): with the 4 mm plate, an M3 x 8 reaches 2 mm
                    //   into the motor, whose holes are 2.5 deep. They sit in the frame's small diamonds
mp_pocket = 8;      // those diamonds, across their flats: 1 mm clear around each boss
tower_t   = 3;      // motor and encoder bracket walls
cap_h     = 12;     // magnet cap on the shaft end
cap_d     = 14;     // wide enough for a radial M3 grub screw
cap_grub_z = 2;     // grub screw height above the cap's shaft end (the shaft reaches about 4.6 mm in)
cap_slide = 1;      // the cap can slide this much up or down before its grub screw is tightened
magnet    = "diametric"; // [diametric:diametric disc lying flat (as sold with AS5600 boards), sideways:2 x 2 mm axial cylinder lying across the shaft]
magnet_d  = 4;      // diametric magnet diameter (the kit magnet measures 3.95 x 2 mm; other kits: 6 x 2.5 or 6 x 3)
magnet_h  = 2;      // diametric magnet thickness
enc_gap   = 1.5;    // nominal magnet face to AS5600 chip top (datasheet: 0.5-3); set on assembly with a shim
enc_chip  = 1.62;   // AS5600 package height above the board (kit board measured: 3.22 with the 1.6 board)
enc_board = 1.6;    // board thickness (measured)
enc_standoff = 2;   // pads lift the board over its solder joints
enc_holes = [15, 17];  // board hole squares supported by the diagonal slots (20 x 20 boards: 15 x 15; the kit
                       // board, 23.3 x 22.8: 16.7 x 16.2, a rectangle, so its screws sit 0.18 off the slot axis)
enc_slot  = 3.5;    // slot width: an M3 screw (3.0) passes even 0.18 off the slot axis
enc_pad   = 5.5;    // standoff pads around the slots (a 1 mm wall around a 3.5 slot)
enc_pad_bev = 1;    // 45 deg flare at the pads' base (they stick out sideways when printing); more would reach the
                    // solder joints under the board's end pins
enc_win   = 13.5;   // wire window: a diamond (point to point) under the chip; the wires soldered to the board
                    // run inward under it (the standoffs leave 2 mm) and down through it

/* [Electronics box and cables] */
ebox_w    = 80;     // box width (= fan width); the encoder plate widens to match and becomes its lid
ebox_h    = 34;     // inside height under the encoder plate (soldered, the TMC2209's heatsink reaches 24.0; in female
                    // headers, 32.5)
ebox_t    = 2.4;    // walls and floor
eb_tab    = [3, 10, 8];  // back tabs (thickness, width, height above the encoder plate), flush with the back edge:
                    //   up through notches in the plate, against the inner faces of the bay walls, as the motor plate's
fan_rubber = [1, 13];  // the lower fan's corner rubber bumpers: notches in both top corners of the box's front cover
                    //   (depth down from its top edge, length in from each side)
pb_size   = [70, 50];  // perfboard carrier (5 x 7 cm protoboard)
pb_holes  = [66, 46.26]; // its corner hole spacing (measured: Ø 2.3 holes, for M2, about 2 mm from the edges)
pb_t      = 1.51;   // its thickness (measured)
pb_grid   = [24, 18]; // its pin holes, 2.54 apart and centred: 24 columns along x (labelled A to X), 18 rows along y
                    //   (18 at the back to 1 at the front, as printed). Indices below count from 0: column 0 (A) at
                    //   the right wall's side, row 0 (18) at the back
pb_y      = 56;     // perfboard centre (y)
pb_stand  = 5;      // standoff height
usb_port  = "diamond"; // [none, mark, diamond] the ESP32's USB-C cable (5 V power and console) through a side wall:
                    // an 18 mm diamond opening, or only an engraved cross to drill a 12 mm hole later
usb_side  = "both"; // [left, right, both] which side wall gets it: both lets one box take either ESP32 layout
esp_usb   = "left"; // [left, right] the ESP32's USB end toward the left wall (view ebox_elec) or the right one
                    // (turned 180 deg, view ebox_elec_alt); shown in the assembly
esp_mount = "soldered"; // [soldered, headers] ESP32 soldered straight into the perfboard, or in female headers
tmc_mount = "soldered"; // [soldered, headers] TMC2209 likewise
header_h  = 8.5;    // female header height
esp_w     = 28.5;   // ESP32 board width; it lies across the back half of the perfboard, USB end toward a side wall
esp_l     = 50;     // ESP32 PCB length (the module's antenna sticks out 7 more, over the middle 18.5)
esp_col   = 22;     // ESP32 soldered on the grid: its USB-end pins in column 22 (0 to 23; the right layout mirrors it
                    //   into column 1). One free column beyond them, easy to solder; the pins clear the corner
                    //   standoff by 3.1 and the spacer clears the M2 screw head by 3.6. The plug enters the box
esp_row   = 0;      // its back pin row in row 0; the front row is 10 holes on (25.4; the board's rows are 25.3 apart)
esp_pcb   = [1.62, 2.78, 5.54];  // ESP32 PCB thickness, pin spacer, pin length below the spacer (measured)
tmc_pcb   = [20.81, 15.08, 1.62]; // TMC2209 module, measured (along x = along its pin rows, along y, thickness; see doc/tmc2209.svg)
tmc_spacer = 2.62;  // its pin spacer, measured
tmc_pin   = 5.8;    // its pins below the spacer, measured; 2 rows of 8, 12.7 apart
tmc_sink  = [15, 14.4, 13.08]; // its heatsink, on top, fins along the pin rows; measured 15 x 14.4 x 13.2 with its thermal
                    //   sticker, 14.70 from the PCB underside to its top once pressed on
tmc_col   = 4;      // TMC2209 on the grid: its first pin in column 4 (room for the 12 V terminal by the right wall)
tmc_row   = 12;     // its back pin row in row 12, the front one in row 17: one free row behind the ESP32's front row
usb_dy    = 6;      // the USB-UART connector's offset from the board's centre line, toward the room (measured: 8.25 from the
                    // board's TX/GND edge, which faces the room; the USB-OTG one is 5.5 off on the other side)
cable_in  = [16, 10];  // cable entries at the top of both side walls, toward the front (length along y, depth)
anchor_h  = 6;      // tie-wrap anchors: height off the back of the fan plate, to the top of their rounded back (the
                    // wires rest on it). Their slot is house-shaped (floor on the plate, 2 mm straight walls 4.5 apart,
                    // 45 deg roof), so it prints without a flat ceiling

/* [Split housing, for printers under 241 mm (e.g. 180 mm beds)] */
splice_t  = 6;      // splice plate behind the fan plate, in the gap between the ducts
splice_w  = 60;     // its width (x); stays inside the tie-wrap anchors
splice_h  = 32;     // its height (z), before the 1 mm clearance cuts around the ducts
split_sx  = 20;     // joint screws (4 x M3 x 12 countersunk) at x = +/- split_sx ...
split_sz  = 4.5;    //   ... and z = +/- split_sz: in the band between the fans
split_csk = 7;      // 90 deg countersinks for their heads, this wide at the fan face (M3 flat heads: 5.5-6.7); 45 deg walls print from the bed

/* [Drill guide for the foam insert's pilot holes] */
guide_d     = [5.2, 6];   // bits: A, the hole saw's pilot holes (5.2: the saw's 5.8 pilot drill follows it); B, the
                           //   outdoor probe's hole (6: snug on the 6 mm probe). Set them to your bits; each bore gets
                           //   guide_clear more, and the bit itself sizes it on the first pass
guide_clear = 0.2;
guide_h     = 20;   // bushing height, base included: 20 mm and 0.2 clearance keep the bit within about 0.6 deg
guide_pitch = 24;   // between the two bushings
guide_base  = [26, 46, 4];   // base: width, length (along the bushings), thickness
guide_notch = 2;    // depth of the 90 deg V-notches set on the template's lines

/* [Cutting guides for the lip foam] */
fg_t    = 3;          // plate: the foam strip's exact outline, this thick; the knife runs along its edges
fg_rib  = [3, 6, 5];  // stiffening rib along the middle of the strip: width, height above the plate, and how far it
                      //   stops short of each end (room for the knife across the ends)
fg_grip = [4, 18, 25];  // finger grip in the middle of the rib: width, top height above the bed, radius of its arched top
                      //   (sets its length: about 38 mm above the rib)

/* [Insect screen frame] */
// a frame on the foam's outdoor face, over both holes: fibreglass mesh pressed into a groove around its edge by screen
// spline (0.125 in) or 3 mm O-ring cord, one loop. Sleeves on its back plug into the holes' outdoor ends (the spigots
// fill only 25 mm of the foam), so it is centred and held by them; four countersunk screws into the foam keep it there
scr_w      = 94;    // width: the foam shows 96 mm between the caps' lips
scr_t      = 5;     // plate thickness: flush with the caps' lips, 5 mm proud of the foam
scr_groove = [2.8, 3, 1.5];   // spline groove: width, depth, and the wall outside it at the frame's sides
scr_chamf  = 0.4;   // 45 deg chamfer on the groove's mouth (on the bed): eases the cord in, offsets elephant's foot
scr_sleeve = [83.3, 2, 10, 1];   // sleeves: OD (the hole saw's 83.3), wall, length past the plate, lead-in chamfer;
                    //   the windows in the plate are the sleeves' bore
scr_screw  = [4.25, 8, 3.5];  // screws: hole, head diameter, head height (countersunk; as the latch cover's)
scr_csk    = 0.8;   // the countersinks' diameter at the face, past the head's: the head sits 0.75 below the face
                    //   (about 0.5 as printed: the latch cover's, 0.4 wide at the top, came out 0.25 shallower)
scr_edge   = 1.2;   // material between a countersink and the groove or the frame's edge
scr_drain  = [15, 1];   // drain at the bottom of each hole: width, and the drop of its floor from the hole's floor
                    //   (inside) to the outdoor face, so condensation runs out under the mesh instead of pooling
                    //   against the sleeve's end

/* [Drip tray] */
// a tray under the unit on the window ledge, for drips of condensation (they evaporate indoors); the electronics box
// stands on ribs above its floor. A leg in each corner levels it: an M3 button head screw, put in from below with its
// head up in a pyramid at the top of a corner post's socket and turned from above with a 2 mm hex key, drives a
// square foot with a captive nut up and down in the socket. An M2 screw through the post's wall rides in a groove up
// the foot: it holds the leg in and stops its travel. Nothing in the post or the foot needs a bridge or a support.
// The posts stand beside the box, inside the tray's outline
tray_gap   = 1;     // between the electronics box and the posts, each side
tray_back  = 6;     // the back face's distance from the foam's room face: clear of the bottom cap's lip (4.8 thick)
tray_wall  = 2;     // walls
tray_floor = 1.6;   // floor (5 bottom layers or more, so it holds water)
tray_rim   = 10;    // the walls' height above the floor
tray_front = 5;     // the inside reaches this far past the fans' front faces
tray_rib   = [3, 2, 7];   // ribs along the tray: height, width, count, evenly spaced across the inside. Each
                    //   stops one rib width short of the walls at its ends, so water can pass from one channel to
                    //   the next; a rib that would pass close beside the posts stops as short of them instead
tray_post  = 13.4;  // corner posts: outside size along the tray (a 2 mm wall around the socket) ...
tray_pwall = 3.5;   // ... and their outer wall, thicker for the M2 stop's thread (the posts grow outward)
tray_sock  = 17;    // the socket's straight part, from the floor's underside up; a 45 deg pyramid closes it above
tray_foot  = [9, 0.2, 20];   // feet: square side, clearance each side in the socket, length
tray_screw = [20, 3.4, 5.7, 0.5];   // screws: length, hole, button head diameter (M3 x 20, ISO 7380), and the height
                    //   of the head's rim, which bears on the pyramid's faces, above its underside (about)
tray_pin   = [1.6, 3, 3.0, 2.4];   // the M2 x 6 stop (flat head): pilot hole, height above the floor's underside,
                    //   its 90 deg countersink (shallow: 2.8 mm of thread in the 3.5 wall), and the width of the
                    //   groove it rides in; the tip reaches 2.1 into the socket, 1.1 clear of the M3.
                    //   The groove runs up the foot's face with the nut's slot (that face toward the post's outer
                    //   wall; it is up when printing, so it has no overhang), open through to the screw's bore
tray_range = [4, 11];   // the floor's underside above the ledge: the groove's two ends
tray_h     = 7;     // the floor's underside above the ledge, in the tray_view

/* [Hidden] */
$fn = 96;
eps = 0.01;
r      = duct_id / 2;
ro     = r + wall;
zc     = [pitch / 2, -pitch / 2];          // upper (exhaust), lower (intake)
z_top  = pitch / 2 + ro;                   // top of the upper duct
z_mp0  = z_top + boss_h + coupler_room;    // motor plate bottom
z_mp1  = z_mp0 + mp_t;
z_cap1 = -(z_top + boss_h + 1 + cap_slide);   // magnet cap top (nominal; it can rise cap_slide)
z_mag  = z_cap1 - cap_h + 0.2;             // magnet face (the magnet sits 0.2 deep in its pocket)
z_ep1  = z_mag - enc_gap - enc_chip - enc_board - enc_standoff;  // encoder plate top
z_ep0  = z_ep1 - 4;
z_bb1  = r - 0.25 + wall + boss_h + 0.5;     // flat top of the outer bearing bosses, from the duct axis
// The disc goes in edge-on, so it must clear the drip dam: that sets its size.
disc_d = duct_id - 2 * (dam_h + 0.6);
lip_w  = (duct_id - disc_d) / 2 + lip_ovl;   // lips reach in far enough to overlap the disc
// The plate is hc off the shaft, so while it turns its edge reaches this far from the bore axis.
r_sweep = sqrt(pow(disc_d / 2, 2) + pow(hc, 2));
boss_rc = r_sweep + sboss_clr;               // curved inner face of the shaft bosses
// flat_boss: the disc's flats, from its centre along the shaft; at this distance the circular rim is lip_gap + 0.5
// from the shaft, so the flat spans the whole gap between the lip ends. The boss faces sit fboss_clr beyond it.
disc_flat = sqrt(pow(disc_d / 2, 2) - pow(lip_gap + 0.5, 2));
boss_flat = disc_flat + fboss_clr;
boss_in   = flat_boss ? boss_flat : boss_rc;   // where the bearing holes start (the bosses' inner faces, at the shaft)
y_br   = ys - mplate / 2;                  // bracket walls start here (they run to the fan plate)
x_br   = mplate / 2;                       // bracket walls: x from x_br - tower_t to x_br, under the frame corners
y_dam  = ys + (r - 0.4) + 1;               // drip dam face, just outside the disc swing
y_sp0  = duct_len - fan_plate - splice_t;  // splice plate back face
ebox_top    = -pitch / 2 - fan / 2;         // the box cover rises to the bottom of the lower fan
ebox_screw_z = z_ep1 + 8;                   // front cover screws: in the bay, above the encoder plate
// electronics heights, above the box's inner floor
pb_top    = pb_stand + pb_t;                                                     // perfboard top
function pb_col(i) = (i - (pb_grid[0] - 1) / 2) * 2.54;                          // grid column i -> x
function pb_row(j) = pb_y + (j - (pb_grid[1] - 1) / 2) * 2.54;                   // grid row j -> y
esp_z0    = pb_top + (esp_mount == "headers" ? header_h : 0) + esp_pcb[1];        // ESP32 PCB underside
usb_z     = esp_z0 + esp_pcb[0] + 3.25 / 2;                                     // USB-C socket centre (the diamond's)
tmc_z0    = pb_top + (tmc_mount == "headers" ? header_h : 0) + tmc_spacer;        // TMC2209 PCB underside
esp_yc    = pb_row(esp_row) + 5 * 2.54;                                          // ESP32 centre line (y), between its pin rows
// tie-wrap anchors on the back of the fan plate, right side: the top and bottom ones touch the
// outer fan nut pockets (hex flat at fan_hole / 2 - 2.9 from the fan centre), the middle one sits between the fans
anchor_zt = pitch / 2 + fan_hole / 2 - 5.8 / 2 - 4;
anchor_z  = [anchor_zt, 0, -anchor_zt];

assert(sqrt(pow(disc_d / 2, 2) + pow(hc, 2)) < r - 0.4, "disc too large to rotate in the bore");

// cylinder along +y, from y0 to y1, centred on (0, z)
module ycyl(y0, y1, d, z = 0, d2 = undef)
    translate([0, y0, z]) rotate([-90, 0, 0]) cylinder(d1 = d, d2 = (d2 == undef ? d : d2), h = y1 - y0);

/* =================== HOUSING =================== */
// O-ring groove cut, as one profile turned around the spigot axis (+z here, toward the spigot tip):
// flat floor from z = 0 to 1.4 cs, straight wall at z = 0, and with oring_slope a 45 deg wall at the tip end.
module oring_groove() {
    rf = oring_floor / 2;                    // floor radius
    ro = sp_od / 2 + 1;                      // beyond the spigot surface
    w  = 1.4 * oring_cs;
    rotate_extrude($fn = 96) polygon(oring_slope
        ? [[rf, 0], [ro, 0], [ro, w + (ro - rf)], [rf, w]]
        : [[rf, 0], [ro, 0], [ro, w], [rf, w]]);
}

// AS5600 standoff pad post, along +z from its base: flares 45 deg over its lower enc_pad_bev
module enc_pad_post(extra = 0) {
    cylinder(d1 = enc_pad + 2 * enc_pad_bev, d2 = enc_pad, h = enc_pad_bev + extra, $fn = 32);
    cylinder(d = enc_pad, h = enc_standoff + extra, $fn = 32);
}

// Tie-wrap slot cross-section, in (y, z) once extruded along x with rotate([90, 0, 90]): floor at y = +1 (toward the
// fan plate, i.e. the bed when printing), 2 mm straight walls 4.5 mm apart, and a 45 deg roof peaking at y = -3.25.
module house_slot() polygon([[1, -2.25], [1, 2.25], [-1, 2.25], [-3.25, 0], [-1, -2.25]]);

module duct_outer(z) {
    ycyl(-sp_len, -sp_len + sp_lead, sp_od - 2 * sp_lead, z, sp_od);   // spigot: lead-in chamfer at the tip
    ycyl(-sp_len + sp_lead, 0, sp_od, z);
    ycyl(0, stop_t, stop_od, z);                                  // stop ring
    ycyl(stop_t, stop_t + (stop_od / 2 - ro), stop_od, z, 2 * ro);// 45 deg underside (prints without support)
    ycyl(0, duct_len, 2 * ro, z);                                 // damper duct
    for (s = [-1, 1])                                             // shaft bearing bosses: 45 deg cones with a 10 mm flat top
        translate([0, ys, z + s * (r - 0.25)]) mirror([0, 0, s < 0 ? 1 : 0])   // (they stick out sideways when printing)
            cylinder(d1 = 10 + 2 * (wall + boss_h + 0.5), d2 = 10, h = wall + boss_h + 0.5, $fn = 64);
}

module lips(z) {
    // A: x > lip_gap, room side of the closed disc; B: x < -lip_gap, foam side
    ya = ys - hc + disc_t + gasket;
    intersection() {
        translate([lip_gap, -sp_len, z - ro]) cube([ro, duct_len + sp_len, 2 * ro]);
        union() {
            difference() { ycyl(ya, ya + lip_t, duct_id + 1, z); ycyl(ya - 1, ya + lip_t + 1, duct_id - 2 * lip_w, z); }
            difference() {   // 45 deg chamfer on the room side of lip A
                ycyl(ya + lip_t, ya + lip_t + lip_w, duct_id + 1, z);
                ycyl(ya + lip_t - eps, ya + lip_t + lip_w + eps, duct_id - 2 * lip_w, z, duct_id + 2 * eps);
            }
        }
    }
    // B: a 45 deg conical seat (it faces the fan plate, i.e. the bed when printing), one gasket thickness
    // (measured square to the slope) from the disc's bevelled rim; a flat land lip_t deep behind its inner edge
    r_in = r - lip_w;
    yc0  = ys - hc + r_in - (disc_d / 2 - disc_bev) - gasket * sqrt(2);   // the cone starts at r_in here
    yc1  = yc0 + (r + 1 - r_in);                                          // and passes the bore wall here
    intersection() {
        translate([-lip_gap - ro, -sp_len, z - ro]) cube([ro, duct_len + sp_len, 2 * ro]);
        difference() {
            ycyl(yc0 - lip_t, yc1, duct_id + 1, z);
            ycyl(yc0 - lip_t - 1, yc0 + eps, 2 * r_in, z);
            ycyl(yc0, yc1 + eps, 2 * r_in, z, 2 * (r + 1));
        }
    }
}

// Two side walls from z0 to z1, running to the fan plate (they rest on the bed when printing),
// with a diamond access window (45 deg edges print without support) between wz0 and wz1.
module bracket(z0, z1, wz0, wz1) {
    s = (wz1 - wz0 - 4) / sqrt(2);
    for (sx = [-1, 1]) difference() {
        translate([sx > 0 ? x_br - tower_t : -x_br, y_br, z0]) cube([tower_t, duct_len - y_br, z1 - z0]);
        translate([sx * (x_br - tower_t / 2), ys, (wz0 + wz1) / 2]) rotate([45, 0, 0]) cube([tower_t + 2, s, s], center = true);
    }
}

// Airflow arrow engraved in the outer face of both bracket walls: dir = +1 toward the room
// (intake, lower duct), -1 toward the foam (exhaust, upper duct). Same direction seen from either side.
module flow_arrows(zm, dir, len = 36, shaft = 3, head = 9, depth = 0.8) {
    yc = ys + 7;
    pts = [[-len / 2, -shaft / 2], [len / 2 - 8, -shaft / 2], [len / 2 - 8, -head / 2], [len / 2, 0],
           [len / 2 - 8, head / 2], [len / 2 - 8, shaft / 2], [-len / 2, shaft / 2]];
    for (sx = [-1, 1])
        translate([sx > 0 ? x_br - depth : -x_br - eps, yc, zm]) rotate([90, 0, 90])
            linear_extrude(depth + eps) scale([dir, 1]) polygon(pts);
}

module drip_dam(z) {   // lower part of the bore, flat face toward the foam, 45 deg chamfer on the room side
    intersection() {
        translate([-ro, y_dam - 1, z - ro]) cube([2 * ro, duct_len, ro - r * cos(dam_ang)]);
        union() {
            difference() { ycyl(y_dam, y_dam + 2, duct_id + 1, z); ycyl(y_dam - 1, y_dam + 3, 2 * boss_rc, z); }
            difference() {
                ycyl(y_dam + 2, y_dam + 2 + dam_h, duct_id + 1, z);
                ycyl(y_dam + 2 - eps, y_dam + 2 + dam_h + eps, 2 * boss_rc, z, duct_id + 2 * eps);
            }
        }
    }
}

// Square frame on top of the bracket. The motor plate's four screws pass inside the tower walls,
// so their nuts go on from below, in the space under the frame.
module motor_frame() {
    difference() {
        // runs to the fan plate, so it rests on the bed when printing (no bridge)
        translate([-mplate / 2, ys - mplate / 2, z_mp0]) cube([mplate, duct_len - (ys - mplate / 2), mp_t]);
        // diamond openings (pointed up and down when printing, so no bridges): a big one the coupler (19 mm) passes with 2 mm to spare
        // through when the motor goes on, and four small ones for the motor screw bosses and heads under the motor plate
        translate([0, ys, z_mp0 - 1]) linear_extrude(mp_t + 2) rotate(45) square(23.1, center = true);   // flats a little wider than the plate's 22.5 hole
        for (dx = [-1, 1], dy = [-1, 1])
            translate([dx * nema_hole / 2, ys + dy * nema_hole / 2, z_mp0 - 1]) linear_extrude(mp_t + 2) rotate(45) square(mp_pocket, center = true);
        for (sx = [-1, 1]) {
            // front: M3 holes for the plate's two front screws (nuts from the tower's open front, above the fan plate)
            translate([sx * mp_front[0], ys + mp_front[1], z_mp0 - 1]) cylinder(d = 3.4, h = mp_t + 2, $fn = 24);
            // back: notches for the plate's tabs, open at the back edge, against the inner faces of the tower walls
            translate([sx > 0 ? x_br - tower_t - mp_tab[0] - 0.4 : -(x_br - tower_t), y_br - 1, z_mp0 - 1])
                cube([mp_tab[0] + 0.4, mp_tab[1] + 1.4, mp_t + 2]);
        }
    }
}

// Modelled with the motor axis at the origin, the plate's underside at z = 0 (installed: on top of the frame).
// The motor screws to it from below (4 x M3 x 8 through bosses under the plate: the motor's holes are 2.5 deep; the
// bosses and heads go down through the frame's small diamonds); it covers the top of the
// tower from its open back to just past the front screws. Front: two M3 x 10 + nuts through the frame. Back: two tabs down through the frame, against the
// inner faces of the tower walls, each held by an M3 x 10 through the wall with a nut inside.
module motor_plate() {
    y0 = y_br - ys;                  // back edge (the tower's open back)
    y1 = mp_front[1] + 6;            // front edge: 6 mm past the front screws (the roof carries on to the fan plate)
    difference() {
        union() {
            translate([-mplate / 2, y0, 0]) cube([mplate, y1 - y0, mplate_t]);
            for (dx = [-1, 1], dy = [-1, 1])   // motor screw bosses (they print upward: the plate prints top face down)
                translate([dx * nema_hole / 2, dy * nema_hole / 2, -mp_boss[1]]) cylinder(d = mp_boss[0], h = mp_boss[1] + eps, $fn = 32);
            for (sx = [-1, 1])
                translate([sx > 0 ? x_br - tower_t - mp_tab[0] - 0.2 : -(x_br - tower_t - 0.2), y0, -(mp_t + mp_tab[2])])
                    cube([mp_tab[0], mp_tab[1], mp_t + mp_tab[2] + eps]);
        }
        translate([0, 0, -1]) cylinder(d = nema_boss + 0.5, h = mplate_t + 2);
        for (dx = [-1, 1], dy = [-1, 1])
            translate([dx * nema_hole / 2, dy * nema_hole / 2, -mp_boss[1] - 1]) cylinder(d = 3.4, h = mplate_t + mp_boss[1] + 2, $fn = 24);
        for (sx = [-1, 1]) {
            translate([sx * mp_front[0], mp_front[1], -1]) cylinder(d = 3.4, h = mplate_t + 2, $fn = 24);
            // tab screw, across the tab (along x), level with the wall hole
            translate([sx * (x_br - tower_t - mp_tab[0] / 2) - mp_tab[0], y0 + mp_tab[1] / 2, -(mp_t + mp_tab[2] / 2)])
                rotate([0, 90, 0]) cylinder(d = 3.4, h = 2 * mp_tab[0], $fn = 24);
        }
    }
}

// the housing, with the sacrificial fins in its four bearing holes (each from the inner boss face to the outer boss top)
module body() {
    body_bored();
    if (fin_t > 0) for (z = zc, s = [-1, 1])
        translate([0, ys, z + (s > 0 ? boss_in : -z_bb1)]) rotate([90, 0, 0])   // fin vertical when printing
            shaft_fin(shaft_d + shaft_clr, z_bb1 - boss_in, fin_t);
}
module body_bored() {
    difference() {
        union() {
            difference() {
                union() {
                    for (z = zc) duct_outer(z);
                    translate([-fan / 2, duct_len - fan_plate, -pitch / 2 - fan / 2]) cube([fan, fan_plate, pitch + fan]);
                    for (sx = [-1, 1])   // the fan plate reaches down behind the box cover's fan rubber notches, closing them
                        translate([sx < 0 ? -fan / 2 : ebox_w / 2 - fan_rubber[1], duct_len - fan_plate, ebox_top - fan_rubber[0]])
                            cube([fan_rubber[1] + fan / 2 - ebox_w / 2, fan_plate, fan_rubber[0] + eps]);
                    // motor bracket and frame
                    bracket(pitch / 2 + 25, z_mp0 + eps, z_top + boss_h, z_mp0);   // starts inside the bore (cut away below)
                    motor_frame();
                    // encoder bracket and plate
                    bracket(z_ep1 - eps, -pitch / 2 - 25, z_ep1, -(z_top + boss_h));
                    translate([-ebox_w / 2, y_br, z_ep0]) cube([ebox_w, duct_len - y_br, z_ep1 - z_ep0]);   // encoder plate = box lid
                    for (sx = [-1, 1])   // bosses at the front of the bay walls for the box cover screws
                        translate([sx * (x_br - tower_t / 2) - 3.5, duct_len - 8, ebox_screw_z - 4]) cube([7, 8, 8]);
                    for (sx = [-1, 1], z = anchor_z)   // tie-wrap anchors on both sides (cables on the right, -x, by default):
                                                       // 8 wide, walls up to anchor_h - 4, then a half-cylinder back
                        translate([sx < 0 ? -fan / 2 : fan / 2 - 7, duct_len - fan_plate, z]) rotate([90, 0, 90]) linear_extrude(7)
                            hull() {
                                translate([-(anchor_h - 4), 0]) circle(r = 4, $fn = 48);
                                translate([-(anchor_h - 4), -4]) square([anchor_h - 4 + eps, 8]);
                            }
                    for (dx = [-1, 1], dy = [-1, 1]) hull() for (h = enc_holes)   // standoff pads under the board corners
                        translate([dx * h / 2, ys + dy * h / 2, z_ep1 - eps]) enc_pad_post(eps);
                }
                for (z = zc) {
                    ycyl(-sp_len - 1, duct_len + 1, duct_id, z);                     // bore
                    sp_bore = sp_od - 2 * sp_wall;                                    // spigot bore: a long taper from the
                    ycyl(-sp_len - 1, 0, sp_bore + (sp_bore - duct_id) / sp_len, z, duct_id);   // tip (past it by 1) to the stop ring
                    if (orings) for (p = oring_pos)                                   // O-ring grooves (spigot tip toward -y)
                        translate([0, -p, z]) rotate([90, 0, 0]) oring_groove();
                    for (dx = [-1, 1], dz = [-1, 1]) {                                 // fan screws + M3 nut pockets
                        translate([dx * fan_hole / 2, duct_len - fan_plate - 1, z + dz * fan_hole / 2]) rotate([-90, 0, 0]) cylinder(d = 3.4, h = fan_plate + 2, $fn = 24);
                        translate([dx * fan_hole / 2, duct_len - fan_plate - eps, z + dz * fan_hole / 2]) rotate([-90, 0, 0]) cylinder(r = 5.8 / sqrt(3), h = 2.6, $fn = 6);
                    }
                }
                // encoder plate: diagonal slots for both AS5600 board sizes (M3 or smaller screws)
                for (dx = [-1, 1], dy = [-1, 1]) hull() for (h = enc_holes)
                    translate([dx * h / 2, ys + dy * h / 2, z_ep0 - 1]) cylinder(d = enc_slot, h = z_ep1 - z_ep0 + enc_standoff + 2, $fn = 24);
                // wire window: a diamond under the chip (pointed up and down when printing)
                translate([0, ys, z_ep0 - 1]) linear_extrude(z_ep1 - z_ep0 + 2) rotate(45) square(enc_win / sqrt(2), center = true);
                // box fixing: cover screws into the front bosses (self-tapping M3); at the back, notches in the plate
                // for the box's tabs, and an M3 clearance hole through each bay wall (nut on the inside)
                for (sx = [-1, 1]) {
                    translate([sx * (x_br - tower_t / 2), duct_len + 1, ebox_screw_z]) rotate([90, 0, 0]) cylinder(d = 2.5, h = 9, $fn = 24);
                    translate([sx > 0 ? x_br - tower_t - eb_tab[0] - 0.4 : -(x_br - tower_t), y_br - 1, z_ep0 - 1])
                        cube([eb_tab[0] + 0.4, eb_tab[1] + 1.4, z_ep1 - z_ep0 + 2]);
                    translate([sx * (x_br - tower_t / 2) - tower_t, y_br + eb_tab[1] / 2, z_ep1 + eb_tab[2] / 2])
                        rotate([0, 90, 0]) cylinder(d = 3.4, h = 2 * tower_t, $fn = 24);
                }
                // airflow arrows: exhaust (upper duct) toward the foam, intake (lower duct) toward the room,
                // centred in the band between each diamond window and its duct
                flow_arrows((z_top + boss_h + pitch / 2 + sqrt(ro * ro - x_br * x_br)) / 2, -1);
                flow_arrows(-(z_top + boss_h + pitch / 2 + sqrt(ro * ro - x_br * x_br)) / 2, 1);
                for (sx = [-1, 1])   // M3 clearance holes for the motor plate's back tabs, through the tower walls
                    translate([sx * (x_br - tower_t / 2) - tower_t, y_br + mp_tab[1] / 2, z_mp0 - mp_tab[2] / 2])
                        rotate([0, 90, 0]) cylinder(d = 3.4, h = 2 * tower_t, $fn = 24);
                for (sx = [-1, 1])   // tie-wrap slot near the back edge of each motor tower wall, level with the bottom
                                     // tip of its diamond window; house-shaped, roof toward the back edge (up when printing),
                                     // leaving a 3 mm strip behind the peak for the tie to wrap around
                    translate([sx * (x_br - tower_t / 2) - (tower_t + 2) / 2, y_br + 3 + 3.25, z_top + boss_h + 2 + 2.25]) rotate([90, 0, 90])
                        linear_extrude(tower_t + 2) house_slot();
                for (sx = [-1, 1], z = anchor_z)   // tie-wrap slot through each anchor, across the cable run: house-shaped,
                                                   // its roof pointing away from the fan plate (up when printing)
                    translate([sx < 0 ? -fan / 2 - 1 : fan / 2 - 8, duct_len - fan_plate - 0.8, z]) rotate([90, 0, 90])
                        linear_extrude(9) house_slot();   // floor 0.2 mm into the plate, so no faces coincide
            }
            // inside the bores
            for (z = zc) {
                lips(z);
                drip_dam(z);
                for (s = [-1, 1]) intersection() {   // shaft bosses, floor and ceiling: a cylinder from the bore wall,
                                                     // cut by the bore-axis cylinder
                    difference() {
                        translate([0, ys, z + s * (r + 1)]) mirror([0, 0, s > 0 ? 1 : 0]) cylinder(d = sboss_d, h = r + 1, $fn = 48);
                        // 45 deg plane cut on the fan-plate side only: that side faces the bed when printing.
                        // The footprint on the bore wall stays sboss_d, so water and air see the same boss.
                        translate([0, ys + sboss_d / 2, z + s * r]) mirror([0, 0, s > 0 ? 1 : 0])
                            rotate([-45, 0, 0]) translate([-50, -50, 0]) cube([100, 100, 50]);
                        // floor only: a water channel past the end of lip B (x = -lip_gap). The conical lip reaches
                        // the boss along the floor, so the boss gives way within 3 mm of the lip end, up to 3 mm past
                        // the lip on the fan side; it keeps a 1.3 mm rim around the shaft hole
                        if (s < 0) translate([-(lip_gap + 3), ys - sboss_d, z - r - 1]) cube([6, sboss_d + 2, sboss_d / 2]);
                    }
                    difference() {
                        ycyl(ys - sboss_d, ys + sboss_d, duct_id + 1, z);
                        if (flat_boss)   // flat faces square to the shaft, boss_flat from the bore axis
                            translate([-r - 1, ys - sboss_d - 1, z - boss_flat]) cube([2 * r + 2, 2 * sboss_d + 2, 2 * boss_flat]);
                        else
                            ycyl(ys - sboss_d - 1, ys + sboss_d + 1, 2 * boss_rc, z, undef);
                    }
                }
            }
        }
        // shaft
        translate([0, ys, -(z_top + boss_h) - 1]) cylinder(d = shaft_d + shaft_clr, h = z_mp0 + z_top + boss_h + 2, $fn = 32);
    }
}

/* =================== SPLIT HOUSING (printers under 241 mm) =================== */
// The housing cut at z = 0, midway between the ducts. In that band only the fan plate joins
// the two ducts, so a splice plate on its back, in the gap between the ducts, joins the halves
// again: 4 x M3 x 12 countersunk from the fan face (between the two fans, heads flush) into nuts in the splice.
// Each half prints like the full housing, fan plate on the bed.
module split_screws()
    for (sx = [-1, 1], sz = [-1, 1])
        translate([sx * split_sx, y_sp0 - 1, sz * split_sz]) rotate([-90, 0, 0]) {
            cylinder(d = 3.4, h = splice_t + fan_plate + 2, $fn = 24);
            translate([0, 0, splice_t + fan_plate + 1 - (split_csk - 3.4) / 2]) {   // 90 deg countersink, open at the fan face
                cylinder(d1 = 3.4, d2 = split_csk, h = (split_csk - 3.4) / 2, $fn = 32);
                translate([0, 0, (split_csk - 3.4) / 2 - eps]) cylinder(d = split_csk, h = 1, $fn = 32);
            }
        }

// The middle tie-wrap anchors (z = -4 to 4) stay whole on the upper half: under each one, the cut
// steps down to z = -5 (1 mm below the anchor, so no faces coincide), so the upper half keeps the fan
// plate under the anchor and it still prints from the bed.
module mid_anchor_zone()
    for (sx = [-1, 1])
        translate([sx < 0 ? -fan / 2 - 1 : fan / 2 - 8, duct_len - fan_plate - anchor_h - 1, -5]) cube([9, fan_plate + anchor_h + 2, 6]);   // to z = +1: no face in the cut plane

module body_half(upper) intersection() {
    difference() { body(); split_screws(); }
    if (upper) union() { translate([-100, -50, 0]) cube([200, 200, 300]); mid_anchor_zone(); }
    else difference() { translate([-100, -50, -300]) cube([200, 200, 300]); mid_anchor_zone(); }
}

module splice() {   // modelled in place (installed coordinates)
    difference() {
        translate([-splice_w / 2, y_sp0, -splice_h / 2]) cube([splice_w, splice_t, splice_h]);
        for (z = zc) ycyl(y_sp0 - 1, duct_len, 2 * (ro + 1), z);   // 1 mm clear of both ducts
        split_screws();
        for (sx = [-1, 1], sz = [-1, 1])   // M3 nut pockets on its back face
            translate([sx * split_sx, y_sp0 - eps, sz * split_sz]) rotate([-90, 0, 0]) cylinder(r = 5.8 / sqrt(3), h = 2.6, $fn = 6);
    }
}

// Exploded view: halves pulled apart, splice pulled back toward the foam, screws in front of the fan plate.
module split_view(gap = 36, back = 30) {
    color([0.85, 0.85, 0.88]) translate([0, 0, gap / 2]) body_half(true);
    color([0.75, 0.78, 0.85]) translate([0, 0, -gap / 2]) body_half(false);
    color([0.95, 0.6, 0.25]) translate([0, -back, 0]) splice();
    for (sx = [-1, 1], sz = [-1, 1]) color([0.25, 0.25, 0.27])
        translate([sx * split_sx, duct_len + 20, sz * (split_sz + gap / 2)]) rotate([-90, 0, 0]) {
            cylinder(d = 3, h = 10.3, $fn = 16);
            translate([0, 0, 10.3]) cylinder(d1 = 3, d2 = 6, h = 1.7, $fn = 24);   // flat (countersunk) head
        }
}

// The same parts assembled, with the four countersunk M3 x 12 (heads flush in the fan face, tips at the back of the
// splice) and their nuts in the splice's pockets.
module split_assembly() {
    color([0.85, 0.85, 0.88]) body_half(true);
    color([0.75, 0.78, 0.85]) body_half(false);
    color([0.95, 0.6, 0.25]) splice();
    for (sx = [-1, 1], sz = [-1, 1]) translate([sx * split_sx, 0, sz * split_sz]) {
        color([0.25, 0.25, 0.27]) translate([0, duct_len - 12, 0]) rotate([-90, 0, 0]) {
            cylinder(d = 3, h = 10.3, $fn = 16);
            translate([0, 0, 10.3]) cylinder(d1 = 3, d2 = 6, h = 1.7, $fn = 24);   // flat head
        }
        color([0.7, 0.7, 0.72]) translate([0, y_sp0, 0]) rotate([-90, 0, 0])   // M3 nut (5.5 across flats, 2.4 thick)
            difference() { cylinder(r = 5.5 / sqrt(3), h = 2.4, $fn = 6); translate([0, 0, -1]) cylinder(d = 3, h = 5, $fn = 16); }
    }
}

/* =================== DISC (print frame: plate on the bed, hub up, shaft along y) =================== */
module disc(s = seat_rlf) {
    bev = disc_bev + s[1] * sqrt(2);   // half B's bevel, set back (or forward) s[1] square to the slope
    assert(bev > 0 && bev < disc_t, "seat_rlf[1] out of range");
    difference() {
        intersection() {
            union() {
                cylinder(d = disc_d, h = disc_t);
                translate([-hub_w / 2, -hub_l / 2, 0]) cube([hub_w, hub_l, hub_h]);
                if (s[0] < 0)   // half A (x < 0) thickened by -s[0]
                    intersection() {
                        cylinder(d = disc_d, h = disc_t - s[0]);
                        translate([-disc_d, -disc_d, 0]) cube([disc_d, 2 * disc_d, disc_t - s[0]]);
                    }
            }
            translate([0, 0, hc]) sphere(r = r - 0.4);   // stays inside the bore at every angle
        }
        // shaft bore: a teardrop, 45 deg point up (toward the grub screws), so it prints without support; the
        // grub screws press the shaft into its round lower half
        translate([0, 50, hc]) rotate([90, 0, 0]) linear_extrude(100) hull() {
            circle(d = shaft_d + 0.2, $fn = 32);
            translate([0, (shaft_d + 0.2) / 2 * sqrt(2)]) square(0.01, center = true);
        }
        // half B (x > 0 here, the half that closes against the conical lip B): 45 deg bevel on the bed-side rim
        difference() {
            translate([0, -disc_d, -1]) cube([disc_d, 2 * disc_d, bev + 1]);
            translate([0, 0, -1]) cylinder(r1 = disc_d / 2 - bev - 1, r2 = disc_d / 2, h = bev + 1);
        }
        // half A (x < 0): its top face, which closes against the flat lip A, lowered by s[0] beside the hub
        if (s[0] > 0)
            translate([-disc_d, -disc_d, disc_t - s[0]]) cube([disc_d - hub_w / 2, 2 * disc_d, s[0] + 1]);
        if (flat_boss)   // the two shaft ends cut flat, square to the shaft, disc_flat from the centre
            for (s = [-1, 1]) translate([-disc_d, s > 0 ? disc_flat : -disc_flat - disc_d, -1]) cube([2 * disc_d, disc_d, hub_h + 2]);
        translate([20, 0, disc_t - 0.6]) linear_extrude(1) rotate(90) fittest_letter_big("B");   // marks half B
        for (k = [0 : grub_n - 1])   // M3 grub screws (self-tapping), spread along the hub
            translate([0, (k - (grub_n - 1) / 2) * (grub_n > 1 ? grub_sp / (grub_n - 1) : 0), hc]) cylinder(d = 2.5, h = hub_h, $fn = 24);
    }
}

// disc in the installed position, opened by a degrees (x > 0 half swings toward the foam)
module disc_installed(z, a)
    translate([0, ys, z]) rotate([0, 0, -a]) translate([0, -hc, 0]) rotate([0, 0, 180]) rotate([90, 0, 0]) disc();

/* =================== MAGNET CAP =================== */
// Printed bore down; the magnet is glued into the pocket on top (it faces the AS5600 once
// installed). The AS5600 reads the field direction across the shaft, so the magnet's
// north-south axis must lie ACROSS the shaft: a diametric disc lies flat, an ordinary
// axial cylinder lies on its side.
// A radial M3 grub screw holds it on the shaft. Before tightening, the cap slides about
// +/- 1 mm along the shaft: rest the magnet on a 1 mm shim laid on the chip, then tighten,
// and the gap is exact whatever the magnet's real thickness or washers under the board.
module magnet_cap() {
    bore = cap_h - (magnet_h + 0.2) - 1;   // shaft bore from the bottom, 1 mm floor under the magnet
    difference() {
        cylinder(d = cap_d, h = cap_h);
        translate([0, 0, -1]) cylinder(d = shaft_d + 0.2, h = 1 + bore, $fn = 32);
        translate([0, 0, cap_grub_z]) rotate([-90, 0, 0]) cylinder(d = 2.5, h = cap_d, $fn = 24);   // M3 grub (self-tapping)
        if (magnet == "diametric")
            translate([0, 0, cap_h - magnet_h - 0.2]) cylinder(d = magnet_d + 0.2, h = magnet_h + 1, $fn = 32);
        else   // 2 x 2 mm cylinder lying across the shaft, centred on it
            translate([0, 0, cap_h - 1.1]) rotate([0, 90, 0]) {
                cylinder(d = 2.15, h = 2.15, center = true, $fn = 24);
                translate([-2, -1.075, -1.075]) cube([2, 2.15, 2.15]);  // open to the top face (local -x = up here)
            }
    }
}

/* =================== ELECTRONICS BOX =================== */
// Open-top tray under the housing; the encoder plate is its lid. Its front wall rises to
// the bottom of the lower fan and closes the front of the bottom bay. Inside: a 5 x 7 cm
// perfboard on four standoffs, carrying the ESP32 and the TMC2209 (soldered, or in female headers).
// Modelled in place (installed coordinates); printed floor down.
module ebox() {
    x0 = -ebox_w / 2;  y0 = y_br;  y1 = duct_len + ebox_t;   // the front wall sits in front of the plate's edge
    zb = z_ep0 - ebox_h - ebox_t;                            // underside of the floor
    difference() {
        union() {
            difference() {   // hollow shell first, so the pillars and standoffs below are not cut away
                union() {
                    translate([x0, y0, zb]) cube([ebox_w, y1 - y0, ebox_h + ebox_t]);
                    translate([x0, duct_len, zb]) cube([ebox_w, ebox_t, ebox_top - zb]);   // front cover
                }
                translate([x0 + ebox_t, y0 + ebox_t, zb + ebox_t]) cube([ebox_w - 2 * ebox_t, duct_len - y0 - ebox_t, ebox_h + 1]);
            }
            for (sx = [-1, 1]) mirror([sx < 0 ? 1 : 0, 0, 0]) {   // back tabs, each on a bracket from the side wall:
                // a 45 deg ramp under it (no overhang when printing), then 3 mm straight up to the plate
                tx = x_br - tower_t - 0.2 - eb_tab[0];   // the tab's inner face (0.2 from the bay wall)
                xi = ebox_w / 2 - ebox_t;                 // the side wall's inner face
                translate([tx, y0, z_ep0 - 3]) cube([eb_tab[0], eb_tab[1], 3 + z_ep1 - z_ep0 + eb_tab[2]]);
                translate([0, y0 + eb_tab[1], 0]) rotate([90, 0, 0]) linear_extrude(eb_tab[1] - ebox_t + eps)
                    polygon([[tx, z_ep0], [xi + eps, z_ep0], [xi + eps, z_ep0 - 3 - (xi - tx)], [tx, z_ep0 - 3]]);
            }
            for (dx = [-1, 1], dy = [-1, 1])   // perfboard standoffs
                translate([dx * pb_holes[0] / 2, pb_y + dy * pb_holes[1] / 2, zb + ebox_t - eps]) cylinder(d = 6, h = pb_stand + eps, $fn = 32);
        }
        for (sx = [-1, 1]) {
            translate([sx * (x_br - tower_t / 2), duct_len - 1, ebox_screw_z]) rotate([-90, 0, 0]) cylinder(d = 3.4, h = ebox_t + 2, $fn = 24);
            translate([sx * (x_br - tower_t - 0.2 - eb_tab[0] / 2) - eb_tab[0], y0 + eb_tab[1] / 2, z_ep1 + eb_tab[2] / 2])   // tab screw
                rotate([0, 90, 0]) cylinder(d = 3.4, h = 2 * eb_tab[0], $fn = 24);
        }
        for (dx = [-1, 1], dy = [-1, 1])
            translate([dx * pb_holes[0] / 2, pb_y + dy * pb_holes[1] / 2, zb + ebox_t]) cylinder(d = 1.8, h = pb_stand + 1, $fn = 16);
        // USB-C cable through the left wall (+x, seen from the room): a 45 deg diamond (points up and down when printing) that passes
        // an 11 x 6.25 mm plug, or an engraved cross marking where to drill
        // (left wall), or the right wall with the ESP32 turned 180 deg, so the connector lands on the other side
        // of the board's centre line
        for (sx = [-1, 1]) if (usb_side == "both" || (sx > 0) == (usb_side == "left")) {
            usb_y = esp_yc + sx * usb_dy;
            if (usb_port == "diamond")
                translate([sx > 0 ? ebox_w / 2 - ebox_t - 1 : x0 - 1, usb_y, zb + ebox_t + usb_z]) rotate([0, 90, 0])
                    linear_extrude(ebox_t + 2) rotate(45) square(18 / sqrt(2), center = true);
            if (usb_port == "mark")
                for (r = [0, 90]) translate([sx * ebox_w / 2, usb_y, zb + ebox_t + usb_z]) rotate([r, 0, 0])
                    cube([1.2, 8, 1], center = true);   // 0.6 deep into the outer face
        }
        for (sx = [-1, 1])   // clearance for the lower fan's corner rubber bumpers
            translate([sx < 0 ? x0 - 1 : ebox_w / 2 - fan_rubber[1], duct_len - 1, ebox_top - fan_rubber[0]])
                cube([fan_rubber[1] + 1, ebox_t + 2, fan_rubber[0] + 1]);
        for (sx = [-1, 1])   // cable entries (clear of the USB-C slot)
            translate([sx < 0 ? x0 - 1 : ebox_w / 2 - ebox_t - 1, duct_len - cable_in[0] - 0.5, z_ep0 - cable_in[1]]) cube([ebox_t + 2, cable_in[0], cable_in[1] + 1]);
    }
}

/* =================== TEST PRINTS (optional) =================== */
// fittest: the housing's printer-sensitive features, modelled in the housing's print
// orientation (fan plate down, so the shaft holes are horizontal). About 20-30 min.
module fittest() {
    wy = 20;   // wall: y from wy to wy + mp_t (same thickness as the motor frame)
    difference() {
        union() {
            cube([60, 34, 3]);                                                // base
            cube([12, 12, fan_plate]);                                        // fan plate pad
            translate([0, wy, 0]) cube([50, mp_t, 22]);                       // wall
            translate([16, 2, 0]) cube([8, 8, 12]);                           // post for the self-tapping pilot
            translate([30, 2, 0]) cube([28, ebox_t, 20]);                     // lip test: upright plate ...
            translate([30, 2 + ebox_t - eps, 0]) rotate([90, 0, 90]) linear_extrude(28)   // ... with a 5.6 mm ledge,
                polygon([[0, 12 - lip_w], [lip_w, 12], [lip_w, 12 + lip_t], [0, 12 + lip_t]]);   // 45 deg underside like lip B
            translate([0, wy + eps, 0]) rotate([90, 0, 0])                    // AS5600 standoff pad on the wall
                hull() for (h = enc_holes) translate([28 + (h - 15) / 2, 12 + (h - 15) / 2, 0]) enc_pad_post(eps);
        }
        // fan plate: M3 clearance hole + nut pocket (pocket opens upward, as on the housing)
        translate([6, 6, -1]) cylinder(d = 3.4, h = fan_plate + 2, $fn = 24);
        translate([6, 6, fan_plate - 2.6]) cylinder(r = 5.8 / sqrt(3), h = 3, $fn = 6);
        // shaft bearing hole, horizontal
        translate([8, wy - 1, 12]) rotate([-90, 0, 0]) cylinder(d = shaft_d + shaft_clr, h = mp_t + 2, $fn = 32);
        // motor frame: M3 clearance hole, horizontal when printing
        translate([44, wy - 1, 12]) rotate([-90, 0, 0]) cylinder(d = 3.4, h = mp_t + 2, $fn = 24);
        // AS5600 diagonal slot, through pad and wall
        translate([0, wy + mp_t + 1, 0]) rotate([90, 0, 0])
            linear_extrude(mp_t + enc_standoff + 2) hull() for (h = enc_holes) translate([28 + (h - 15) / 2, 12 + (h - 15) / 2]) circle(d = enc_slot, $fn = 24);
        // self-tapping pilot (as in the box bosses and pillars)
        translate([20, 6, 3]) cylinder(d = 2.5, h = 10, $fn = 24);
        // split housing joint: M3 hole with a 90 deg countersink opening on the bed, as in the fan face
        translate([54, 29, -1]) cylinder(d = 3.4, h = 5, $fn = 24);
        translate([54, 29, -eps]) cylinder(d1 = split_csk, d2 = 3.4, h = (split_csk - 3.4) / 2, $fn = 32);
        // engraved references (see the table in the README): on the base behind the pad and the post for A and B,
        // on the front faces of the lip plate and the wall for C to F
        for (l = [["A", 6, 16], ["B", 20, 16], ["G", 54, 23]])
            translate([l[1], l[2], 3 - 0.6]) linear_extrude(1) fittest_letter(l[0]);
        translate([44, 2 + 0.6, 16]) rotate([90, 0, 0]) linear_extrude(1) fittest_letter("C");
        for (l = [["D", 8], ["E", 28.5], ["F", 44]])
            translate([l[1], wy + 0.6, 19]) rotate([90, 0, 0]) linear_extrude(1) fittest_letter(l[0]);
    }
    if (fin_t > 0) translate([8, wy, 12]) shaft_fin(shaft_d + shaft_clr, mp_t, fin_t);   // in the shaft hole (D)
}
module fittest_letter(t) text(t, size = 4, font = "Liberation Sans:style=Bold", halign = "center", valign = "center");
module fittest_letter_big(t) text(t, size = 8, font = "Liberation Sans:style=Bold", halign = "center", valign = "center");

// fin_test: two horizontal shaft bearing holes, each held up by a sacrificial lattice fin (XXX) instead of slicer
// supports; drill it out with the bit afterwards. Fin thickness: "1" = 0.45 (one 0.4 mm nozzle line), "2" = 0.8 (two).
// Print without supports. About 10 min.
module fin_test() {
    L = 12; zc = 6; d = shaft_d + shaft_clr;
    fins = [0.45, 0.8];
    difference() {
        cube([22, L, 12]);
        for (i = [0, 1]) {
            translate([6 + i * 10, -1, zc]) rotate([-90, 0, 0]) cylinder(d = d, h = L + 2, $fn = 32);
            translate([6 + i * 10, L / 2, 12 - 0.6]) linear_extrude(1) fittest_letter(str(i + 1));
        }
    }
    for (i = [0, 1]) translate([6 + i * 10, 0, zc]) shaft_fin(d, L, fins[i]);
}
// a vertical lattice fin through a hole's axis (along y from 0 to len, centred on z = 0): X struts from the bottom
// of the bore to its top. The bore stays clear for margin at each end, so the drill bit enters the round hole and
// sits square before it meets the fin. Whole X's fill the space between the margins, so every leg stands on the
// bore's floor; they are at most d wide, so the struts are 45 deg or steeper (self-supporting).
module shaft_fin(d, len, t, margin = 1.5, strut = 1.0) {
    m = min(margin, len / 4);   // short holes: smaller margins
    a = len - 2 * m;
    n = ceil(a / d);
    w = a / n;          // each X cell is w long, d high
    z0 = -d / 2;
    y0 = m;
    intersection() {
        translate([0, m, 0]) rotate([-90, 0, 0]) cylinder(d = d + 0.2, h = a, $fn = 32);   // 0.1 into the wall
        rotate([90, 0, 90]) linear_extrude(t, center = true) {           // drawn in (y, z), extruded along x
            for (k = [0 : n - 1], s = [0, 1])
                hull() {
                    translate([y0 + k * w, z0 + s * d]) circle(d = strut, $fn = 12);
                    translate([y0 + (k + 1) * w, z0 + (1 - s) * d]) circle(d = strut, $fn = 12);
                }
        }
    }
}

// oring_test: the stop flange (on the bed) and 15 mm of spigot with one O-ring groove,
// exactly as on the housing. Push it, with an O-ring, into a hole in a foam scrap.
module oring_test() {
    g0 = stop_t + 5;
    difference() {
        union() {
            cylinder(d = stop_od, h = stop_t);
            cylinder(d = sp_od, h = stop_t + 15 - sp_lead);
            translate([0, 0, stop_t + 15 - sp_lead - eps]) cylinder(d1 = sp_od, d2 = sp_od - 2 * sp_lead, h = sp_lead + eps);   // lead-in
        }
        translate([0, 0, -1]) cylinder(d = duct_id, h = stop_t + 17);
        translate([0, 0, g0]) oring_groove();   // the same groove as on the housing (the tip is up here too)
    }
}

// tube_spacer: the spigots' far ends are free (the ducts only join near the fan), so foam holes slightly off their
// 96 mm spacing would bend the ducts as they go in, and the shaft would bind in its bearings. This flat "8" slides
// over both spigots up to the stop rings and stays there, squeezed between them and the foam: two rings, as wide as
// the stop rings so it hides behind them, joined by a short bridge, holding the spigots' ends at their spacing.
// Modelled flat (z = 0 on the bed), the duct centres on the y axis.
module tube_spacer() {
    linear_extrude(spacer[0]) difference() {
        union() {
            for (z = zc) translate([0, z]) circle(d = stop_od, $fn = 180);
            square([spacer[2], pitch - stop_od + 4], center = true);   // the bridge, 2 mm into each ring
        }
        for (z = zc) translate([0, z]) circle(d = sp_od + 2 * spacer[1], $fn = 180);
    }
}

// screen_frame: the insect screen's frame, in its print orientation: the outdoor face on the bed, sleeves up, the
// upper hole (exhaust) at +y. The mesh covers the whole face, both windows and the plate between them, and its edge is pressed
// into one stadium-shaped groove around both holes. The screws sit in the four corners, outside the groove.
sc_ri = scr_sleeve[0] / 2 - scr_sleeve[1];                // window radius (the sleeve's bore)
sc_dz = scr_sleeve[1] + scr_drain[1];                     // the frame's bottom end moves down this far: as much wall
                                                          //   under the lower drain as beside the windows
sc_go = scr_w / 2 - scr_groove[2];                        // groove's outer radius, about each hole's centre
sc_gi = sc_go - scr_groove[0];                            // and its inner radius
sc_hd = scr_screw[1] + scr_csk;                           // countersink diameter at the face
sc_sx = scr_w / 2 - scr_edge - sc_hd / 2;                 // screw position across
sc_sz = pitch / 2 + sqrt(pow(sc_go + scr_edge + sc_hd / 2, 2) - pow(sc_sx, 2));   // and up, clear of the groove
sc_hz = sc_sz + sc_hd / 2 + scr_edge;                     // the corners' reach above the centre (and below, plus sc_dz)
assert(sc_gi > sc_ri + 1, "screen frame: no wall between the window and the groove");

module scr_stadium(rad) hull() for (z = [zc[0], zc[1] - sc_dz]) translate([0, z]) circle(rad, $fn = 180);
module scr_stadium_cone(r1, r2, h)   // from r1 at z = -1 to r2 at h - 1: a 45 deg chamfer's cutter when r1 - r2 = h
    hull() for (z = [zc[0], zc[1] - sc_dz]) translate([0, z, -1]) cylinder(r1 = r1, r2 = r2, h = h, $fn = 180);

module screen_frame() {
    sl = scr_sleeve[2]; ld = scr_sleeve[3]; od = scr_sleeve[0];
    taper = (scr_screw[1] - scr_screw[0]) / 2 / scr_screw[2];   // head radius lost per mm of depth
    hh = (sc_hd - scr_screw[0]) / 2 / taper;                    // countersink depth
    difference() {
        union() {
            linear_extrude(scr_t) union() {
                scr_stadium(scr_w / 2);
                translate([0, -sc_dz / 2]) offset(r = 4) offset(delta = -4) square([scr_w, 2 * sc_hz + sc_dz], center = true);
            }
            for (z = zc) translate([0, z, scr_t - eps]) {
                cylinder(d = od, h = sl - ld + eps);
                translate([0, 0, sl - ld]) cylinder(d1 = od, d2 = od - 2 * ld, h = ld + eps);   // lead-in
            }
        }
        for (z = zc) translate([0, z, -1]) cylinder(r = sc_ri, h = scr_t + scr_sleeve[2] + 2, $fn = 180);
        for (z = zc) hull() {   // the drains: through the sleeve's wall and the plate, the floor sloping down outward;
                                // tall enough to clear the round window's edge across the whole width
            dh = od / 2 - sc_ri + scr_drain[1] + 3;
            translate([-scr_drain[0] / 2, z - od / 2, scr_t + sl]) cube([scr_drain[0], dh, 1]);
            translate([-scr_drain[0] / 2, z - od / 2 - scr_drain[1], -1]) cube([scr_drain[0], dh, 1]);
        }
        translate([0, 0, -1]) linear_extrude(scr_groove[1] + 1) difference() { scr_stadium(sc_go); scr_stadium(sc_gi); }
        difference() {   // the groove mouth's chamfer: two hulled cones (a minkowski() took about a minute)
            scr_stadium_cone(sc_go + scr_chamf + 1, sc_go, scr_chamf + 1);
            scr_stadium_cone(sc_gi - scr_chamf - 1, sc_gi, scr_chamf + 1);
        }
        for (sx = [-1, 1], sz = [-1, 1]) translate([sx * sc_sx, sz * sc_sz - (sz < 0 ? sc_dz : 0), 0]) {
            translate([0, 0, -1]) cylinder(d = scr_screw[0], h = scr_t + 2);
            translate([0, 0, -eps]) cylinder(d1 = sc_hd, d2 = scr_screw[0], h = hh);
        }
    }
}

// screen_test: the frame's bottom end (groove, two screws, an arc of the sleeve and its drain), to try the cord and
// mesh in the groove, the screws in a foam scrap and the drain before printing the whole frame
module screen_test() intersection() {
    screen_frame();
    translate([-scr_w, -pitch / 2 - 20 - sc_dz - 100, -1]) cube([2 * scr_w, 100, 50]);
}

// tray: the drip tray, with its floor's underside at z = 0 (its print orientation, floor on the bed); x and y as
// installed. Each post: the foot's square socket from below, closed above by a 45 deg pyramid that the screw's head
// presses up into, the hex key's hole on through the top, and the M2 stop's pilot hole through the outer wall
tr_px  = tray_post - 2 + tray_pwall;                 // the posts' size across
tr_xo  = ebox_w / 2 + tray_gap + tr_px;              // the outer faces, across: the posts beside the box
tr_y1  = duct_len + fan_t + tray_front + tray_wall;  // the front face; the back one is at y = tray_back
tr_fs  = tray_foot[0] + 2 * tray_foot[1];            // the socket's side
tr_cx  = tr_xo - tray_pwall - tr_fs / 2;             // the sockets' centres, across
tr_kh  = 3.2;                                        // the hex key's hole
tr_pyr = (tr_fs - tr_kh) / 2;                        // the pyramid's height
tr_top = tray_sock + tr_pyr + 1.5;                   // the posts' height
tr_pc  = [for (sx = [-1, 1], y = [tray_back + tray_post / 2, tr_y1 - tray_post / 2]) [sx, y]];   // posts: side, y
tr_hu  = tray_sock + tr_fs / 2 - tray_screw[2] / 2 - tray_screw[3];   // the head's underside: its rim on the pyramid
tr_sz  = tr_hu - tray_screw[0];                      // the screw's tip, from the floor's underside
tr_nut = tray_foot[2] - 1 - 2.6;                     // the foot's nut pocket: its bottom, up the foot (under a 1 mm cap)
tr_gv  = [tray_pin[1] + tray_range[0] - 1, tray_pin[1] + tray_range[1] + 1];   // the groove, up the foot
tr_rx  = let(xi = tr_xo - tray_wall, n = tray_rib[2])   // the ribs' centres, evenly spaced across the inside
         [for (i = [1 : n]) -xi + i * 2 * xi / (n + 1)];
echo(tray_ribs_x = tr_rx);
echo(tray_size = [2 * tr_xo, tr_y1 - tray_back, tray_floor + tray_rim], tray_post_top = tr_top, tray_h_range = tray_range);
// over the range: the foot stays under the pyramid, the tip stays in the foot and through the nut, and the groove
// stops short of the nut
assert(tray_foot[2] - tray_range[0] <= tray_sock - 0.3, "tray: the foot reaches the pyramid");
assert(tr_sz >= 1 - tray_range[0], "tray: the screw's tip comes out of the foot's bottom");
assert(tr_sz <= tr_nut - tray_range[1] - 0.5, "tray: the screw's tip doesn't reach through the nut");
assert(tr_gv[1] <= tr_nut - 1, "tray: the groove reaches the nut");
assert(tray_range[0] <= tray_h && tray_h <= tray_range[1], "tray_h out of the legs' range");

module tray() {
    w = tray_wall; P = tray_post; fs = tr_fs;
    difference() {
        union() {
            difference() {   // the floor and walls
                translate([-tr_xo, tray_back, 0]) cube([2 * tr_xo, tr_y1 - tray_back, tray_floor + tray_rim]);
                translate([-tr_xo + w, tray_back + w, tray_floor]) cube([2 * (tr_xo - w), tr_y1 - tray_back - 2 * w, tray_rim + 1]);
            }
            // the end gaps: from the walls, or from the posts for a rib less than 2 mm from their sides (a
            // narrower slit beside them would hold water)
            for (x = tr_rx) let(e = (abs(x) + tray_rib[1] / 2 > tr_xo - tr_px - 2 ? P : w) + tray_rib[1])
                translate([x - tray_rib[1] / 2, tray_back + e, tray_floor - eps])
                    cube([tray_rib[1], tr_y1 - tray_back - 2 * e, tray_rib[0] + eps]);
            for (c = tr_pc) translate([c[0] * (tr_xo - tr_px / 2) - tr_px / 2, c[1] - P / 2, 0]) cube([tr_px, P, tr_top]);
        }
        for (c = tr_pc) translate([c[0] * tr_cx, c[1], 0]) {
            translate([-fs / 2, -fs / 2, -1]) cube([fs, fs, tray_sock + 1]);   // the foot's socket
            hull() {   // the pyramid
                translate([-fs / 2, -fs / 2, tray_sock - eps]) cube([fs, fs, eps]);
                translate([-tr_kh / 2, -tr_kh / 2, tray_sock + tr_pyr - eps]) cube([tr_kh, tr_kh, eps]);
            }
            translate([0, 0, tray_sock]) cylinder(d = tr_kh, h = tr_top, $fn = 24);   // the hex key's hole
            translate([c[0] * (fs / 2 - 1), 0, tray_pin[1]]) rotate([0, c[0] * 90, 0])   // the M2 stop's pilot hole:
                cylinder(d = tray_pin[0], h = tray_pwall + 2, $fn = 16);                  // outward only (the inner
                                                                                         // wall holds the water)
            translate([c[0] * (fs / 2 + tray_pwall + eps), 0, tray_pin[1]]) rotate([0, c[0] * -90, 0])   // its countersink
                cylinder(d1 = tray_pin[2], d2 = 0, h = tray_pin[2] / 2, $fn = 24);
        }
    }
}

// tray_foot: standing, as installed. The nut slides in from one side, under a 1 mm cap; the screw's tip goes on into
// the bore below it. A groove up the same face, from tr_gv[0] to tr_gv[1] and open through to the bore, takes the M2
// stop
module tray_foot() {
    f = tray_foot[0]; L = tray_foot[2]; g = tray_pin[3];
    difference() {
        hull() {
            translate([-f / 2 + 0.6, -f / 2 + 0.6, 0]) cube([f - 1.2, f - 1.2, eps]);   // a 0.6 chamfer at the bottom
            translate([-f / 2, -f / 2, 0.6]) cube([f, f, L - 0.6]);
        }
        translate([0, 0, 1.5]) hull() {   // the bore: a teardrop, its point up when printing (toward +x)
            cylinder(d = tray_screw[1], h = L, $fn = 24);
            rotate(-45) cube([tray_screw[1] / 2, tray_screw[1] / 2, L]);
        }
        hull() for (x = [0, f]) translate([x, 0, tr_nut]) cylinder(r = 5.8 / sqrt(3), h = 2.6, $fn = 6);
        translate([0, -g / 2, tr_gv[0]]) cube([f, g, tr_gv[1] - tr_gv[0]]);   // the stop's groove, to the bore
    }
}

// tray_feet: the four, each on its side with the nut's slot up (no bridges)
module tray_feet() for (i = [0 : 3]) translate([0, (i - 1.5) * (tray_foot[0] + 6), tray_foot[0] / 2])
    rotate([0, -90, 0]) translate([0, 0, -tray_foot[2] / 2]) tray_foot();

// tray_test: one corner of the tray (a post, its socket, pyramid and stop's hole, and a bit of floor and walls) and a
// foot, on its side, to try the screw, the nut, the foot's slide and the stop before printing the whole tray
module tray_test() {
    intersection() {
        tray();
        translate([tr_xo - tr_px - 6, tray_back - 1, -1]) cube([tr_px + 7, tray_post + 7, tr_top + 2]);
    }
    translate([tr_xo - tr_px - 10 - tray_foot[2] / 2, tray_back + tray_post / 2, tray_foot[0] / 2])
        rotate([0, -90, 0]) translate([0, 0, -tray_foot[2] / 2]) tray_foot();
}

// tray_view: the unit on the tray, the feet at tray_h, on a ghost of the ledge
module tray_view() {
    zt = z_ep0 - ebox_h - ebox_t - tray_rib[0] - tray_floor;   // the floor's underside: the box stands on the ribs
    assembly(plug = false);
    translate([0, 0, zt]) {
        color([0.45, 0.7, 0.85]) tray();
        for (c = tr_pc) color([0.95, 0.6, 0.25]) translate([c[0] * tr_cx, c[1], -tray_h]) tray_foot();
        for (c = tr_pc) color([0.6, 0.6, 0.62]) translate([c[0] * tr_cx, c[1], 0]) {
            translate([0, 0, tr_sz]) cylinder(d = 3, h = tray_screw[0]);
            translate([0, 0, tr_hu]) cylinder(d1 = tray_screw[2], d2 = 2.5, h = 1.65, $fn = 24);   // the head
            translate([c[0] * (tr_fs / 2 + tray_pwall + 0.4), 0, tray_pin[1]]) rotate([0, 90, 0])   // the M2 stop
                cylinder(d = 3.8, h = 1.3, center = true, $fn = 16);
        }
        %translate([-90, -10, -tray_h - 5]) cube([180, 190, 5]);   // the ledge (ghost)
    }
}

// drill_guide: two bushings on a small base, for perpendicular pilot holes in the foam insert. Lay it on the drilling
// template: the notches at both ends on the vertical centre line, the active bushing's side notches on the hole's
// cross arm; then drill through the paper. Printed base down, so the bores are vertical and round.
// foam_guide: a rigid copy of a lip foam template (tools/lip_templates_svg.py). Press it on the neoprene and cut
// around it with a craft knife. The plate is the strip's outline; a rib along its middle stiffens it and rises in the
// middle to a finger grip, inside both edges so the blade runs clear. Bisector along +y, the shaft axis along x.
// A (b = false): the flat half-ring about the shaft axis. B: lip B's 45 deg cone unrolled about its apex, so radius
// rho becomes rho * sqrt 2 and angle t becomes t / sqrt 2. Both stop where rho * cos t = lip_gap. Printed plate down.
module foam_guide(b) {
    k  = b ? sqrt(2) : 1;
    ri = r - lip_w;
    n  = 120; m = 20;
    function p(rho, t) = rho * k * [sin(t / k), cos(t / k)];
    function band(rad, w, f) = concat(   // a strip w wide along the arc of radius rad, from -f to f deg
        [for (i = [0 : n]) (rad + w / 2) * [sin(-f + 2 * f * i / n), cos(-f + 2 * f * i / n)]],
        [for (i = [0 : n]) (rad - w / 2) * [sin(f - 2 * f * i / n), cos(f - 2 * f * i / n)]]);
    a_o = acos(lip_gap / r);
    a_i = acos(lip_gap / ri);
    outline = concat(
        [for (i = [0 : n]) p(r, -a_o + 2 * a_o * i / n)],
        [for (i = [1 : m - 1]) let(rho = r - lip_w * i / m) p(rho, acos(lip_gap / rho))],
        [for (i = [0 : n]) p(ri, a_i - 2 * a_i * i / n)],
        [for (i = [1 : m - 1]) let(rho = ri + lip_w * i / m) p(rho, -acos(lip_gap / rho))]);
    s  = (r - lip_w / 2) * k;                                                   // the strip's centre line, in the plane
    fe = acos(lip_gap / (r - lip_w / 2)) / k - fg_rib[2] / s * 180 / PI;        // the rib's half-angle
    fl = fe + fg_rib[2] / 2 / s * 180 / PI;                                     // the letter, past the rib's end
    difference() {
        linear_extrude(fg_t) polygon(outline);
        translate((s - 0.3) * [sin(fl), cos(fl), 0] + [0, 0, fg_t - 0.6]) rotate(-fl) linear_extrude(1)
            text(b ? "B" : "A", size = 3.5, font = "Liberation Sans:style=Bold", halign = "center", valign = "center");
    }
    linear_extrude(fg_t + fg_rib[1]) polygon(band(s, fg_rib[0], fe));
    intersection() {
        linear_extrude(fg_grip[1]) polygon(band(s, fg_grip[0], fe));
        translate([0, 0, fg_grip[1] - fg_grip[2]]) rotate([-90, 0, 0]) cylinder(r = fg_grip[2], h = 2 * s, $fn = 120);
    }
}

module drill_guide() {
    od = max(guide_d) + guide_clear + 8;                  // bushing: 4 mm walls
    w = guide_base[0]; l = guide_base[1]; t = guide_base[2];
    ya = [-guide_pitch / 2, guide_pitch / 2];             // bushings A and B along y
    difference() {
        union() {
            translate([-w / 2, -l / 2, 0]) cube([w, l, t]);
            for (y = ya) translate([0, y, 0]) cylinder(d = od, h = guide_h);
        }
        for (i = [0, 1]) translate([0, ya[i], 0]) {
            d = guide_d[i] + guide_clear;
            translate([0, 0, -1]) cylinder(d = d, h = guide_h + 2);
            translate([0, 0, guide_h - 0.8]) cylinder(d1 = d, d2 = d + 1.6 + eps, h = 0.8 + eps);   // lead-in for the bit
            translate([0, 0, -eps]) cylinder(d1 = d + 0.8, d2 = d, h = 0.4);                    // against elephant's foot
            for (sx = [-1, 1]) translate([sx * w / 2, 0, 0]) guide_notch();                     // side notches
        }
        for (sy = [-1, 1]) translate([0, sy * l / 2, 0]) rotate(90) guide_notch();                 // end notches
        for (i = [0, 1]) translate([0, ya[i] * 0.21, t - 0.6]) linear_extrude(1)               // bore sizes, between the bushings
            text(str(guide_d[i]), size = 3, font = "Liberation Sans:style=Bold", halign = "center", valign = "center");
    }
}
module guide_notch() translate([0, 0, -1]) linear_extrude(guide_base[2] + 2) rotate(45) square(guide_notch * sqrt(2), center = true);
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
