mmassico/window_air_vent/(list of files, cad)

Other CAD files:
window_insert/stl/side_3b.stl
window_insert/stl/sash_4a.stl
window_insert/stl/sash_3a.stl
window_insert/stl/sash_2b.stl
window_insert/stl/side_0b.stl
window_insert/stl/sash_1b.stl
window_insert/stl/sash_3b.stl
window_insert/stl/side_4a.stl
window_insert/stl/side_4b.stl
window_insert/stl/sash_2a.stl
window_insert/stl/side_1a.stl
window_insert/stl/sash_0b.stl
window_insert/stl/side_1b.stl
window_insert/stl/box_0.stl
window_insert/stl/box_2.stl
window_insert/stl/box_4.stl
window_insert/stl/box_1b.stl
window_insert/stl/slice_bottom.stl
