mmassico/window_air_vent/PRINT_CHECKLIST.md

# Pre-print checklist

Every place where a printed part meets a bought part, with the value in the model, the hardware it must fit, and what is left to check. Go through it before the first print.

**Status:** ✅ checked against the spec · 📏 measure the real part · 🔧 model needs a change · ❓ open question

All dimensions in mm. Values come from `cad/window_vent.scad` (default parameters).

## Print tolerances in general

PETG holes usually come out 0.1–0.2 mm smaller than drawn, and holes printed **horizontally** (axis parallel to the bed) also come out slightly oval, lower at the top. The housing prints standing on its fan plate, so its shaft holes are horizontal; so is the shaft hole in each disc.

- 📏 After printing, run a **5.5 mm drill by hand** through the four shaft holes of the housing, and a **5 mm drill** through each disc hub. The shaft should turn freely in the housing and slide snugly through the hubs.
- ✅ Test prints (optional, before the 10-hour housing): first the small real parts (discs, motor plate, magnet cap), then `fittest` (the housing's printer-sensitive features in its print orientation, engraved A to G; the README lists what each one tests and when it passes) and `oring_test` (a spigot section with one O-ring groove, for the foam hole and the O-ring fit).

## Fans: Noctua NF-A8 PWM (80 × 80 × 25)

| Item | Model | Hardware | Status |
|---|---|---|---|
| Hole spacing | 71.5 square | 71.5 (standard 80 mm fan, Noctua spec); about 71.8 measured edge to edge, within caliper error | ✅ |
| Screw holes in the fan plate | Ø 3.4 | M3 clearance; the fan's own holes are Ø 4.3 (measured) | ✅ |
| Fan plate thickness | 6 | | |
| Nut pockets (back of the fan plate) | hex 5.8 across flats, 2.6 deep | M3 nut: 5.5 AF nominal, 2.4 thick (measured: 5.31, the low end of the 5.32-5.5 range) | ✅ it can't spin in the pocket, but may drop out: hold it with a finger until the screw catches |
| Screws | | M3 × 35: 26.25 through the fan with its rubber pads (measured: 8.75 sticks out of the fan), then the 6 mm plate; the nut sits in its pocket, so the tip ends about 2.75 past the plate's back face. No washer: the pocket holds the nut | ✅ |
| Bore | Ø 74 | NF-A8 blade circle about 76 | ✅ |

## Shaft: 5 mm steel rod, 200 mm (HSS)

| Item | Model | Hardware | Status |
|---|---|---|---|
| Bearing holes in the housing (4) | Ø 5.4 (0.4 clearance) | Ø 5.0 rod | ✅ ream if tight (see above) |
| Bearing bosses outside the ducts (4) | 45° cones, Ø 10 flat top around the shaft hole | | ✅ they stick out sideways when printing; the 45° sides leave no overhang |
| Shaft bosses inside the ducts (4) | Ø 16, 45° plane cut on the fan-plate side only | | ✅ only that side faces the bed when printing; the footprint is unchanged, so water flows around them and the air sees them as before |
| Water past lip B | the floor boss is cut back within 3 mm of lip B's end (x = −7 to −4), up to 3 mm past the lip on the fan side | | ✅ the conical lip reaches the boss along the floor; this keeps a 2–3 mm drain channel along the floor, and a 1.3 mm rim around the shaft hole |
| Bore in each disc hub | Ø 5.2, teardrop: 45° point up, toward the grub screws | | ✅ prints without support; the grub screws press the shaft into the round lower half; ream if tight |
| Length needed | 200: from 4.6 inside the magnet cap to about 10 into the coupler (8 minimum) | 200 | ✅ fits uncut |
| Grip | grub screws on a round rod | HSS is very hard | 📏 grind small flats where the discs, the coupler and the magnet cap clamp |
| Real diameter | | 4.99 measured, 200 long | ✅ |

## Discs: grub screws

| Item | Model | Hardware | Status |
|---|---|---|---|
| Screws per disc | 2, 24 apart | M3 grub screws | ✅ |
| Pilot hole | Ø 2.5, self-tapping | M3 thread | ✅ (or cut a thread with an M3 tap) |
| Depth from hub top to shaft | 6 | | ✅ M3 × 6 sits flush; M3 × 8 sticks out 2 mm, still clear of everything |
| Bevel on half B | 45°, 2 mm, on the bed-side rim, engraved B on the top face | | ✅ seats on the conical lip B with one foam-tape thickness (1 mm, square to the slope); prints as a 45° chamfer |
| Orientation | half B on the conical-lip side (right side, seen from the room) | | 📏 check before tightening the grub screws: turned the wrong way, the disc stops short of closed |

## Coupler: uxcell 5–5 mm, Ø 19 × 25 (measured Ø 18.8 × 24.64)

| Item | Model | Hardware | Status |
|---|---|---|---|
| Space between the upper shaft boss and the frame | 31 | 24.64 long | ✅ the coupler hangs on the motor shaft as before; 3 mm more room under the thinner roof |
| Space between the bracket walls | 50 | Ø 18.8 | ✅ |
| Passing through the motor frame (it goes on with the motor) | centre diamond, 23.1 across its flats (a little more than the motor plate's Ø 22.5 hole) | Ø 18.8 | ✅ 2.1 mm per side |
| Bore | | Ø 5 rod: snug, slides in | ✅ the set screws clamp it |
| Access to its set screws | diamond windows in both bracket walls | | ✅ |

## Motor: StepperOnline 17HS08-1004S (NEMA 17 pancake)

| Item | Model | Hardware | Status |
|---|---|---|---|
| Screw spacing | 31 square | 31 (NEMA 17) | ✅ |
| Screw holes in the motor plate | Ø 3.4 | M3 | ✅ |
| Centring boss hole | Ø 22.5 | boss Ø 22 × 2 | ✅ |
| Motor plate thickness | 4, plus a Ø 6 × 2 boss under each motor screw hole (`mp_boss`) | M3 × 8: 2 mm into the motor | ✅ the 17HS08-1004S's holes are 2.5 deep (sheet: 2.5 min; measured 2.5; [drawing](doc/motor_17hs08.svg)), so 0.5 mm spare ([section](doc/motor_mount.svg)). The bosses print upward (plate top face on the bed) |
| Frame pockets for the bosses and screw heads | 4 diamonds, 8 across the flats (`mp_pocket`) | boss Ø 6; button head Ø 5.7 | ✅ 1 mm clear around each boss; the heads end 0.65 below the 3 mm frame, in about 38 mm of empty tower |
| Shaft length | assumed 24 from the face | | 📏 measure; the coupler can slide up or down to suit |
| Motor plate to frame | front: 2 holes at ±20, 27 in front of the motor axis, through the 3 mm frame; back: 2 tabs (3 × 10, 8 below the frame), flush with the back edge, through notches, against the tower walls, Ø 3.4 holes through tab and wall | M3 × 10 + nut, all four | ✅ the front heads clear the motor body by 3 mm; the front nuts are reached from the tower's open front, the back ones from its open back; no nut pockets; `check.py` check 7 |

## Encoder: AS5600 board and magnet

Two common boards are supported. The chip is centred on both. Board B is the one in the kit, measured.

<p align="center">AS5600 kit board, dimensioned: 23.3 x 22.8 mm, holes 3.6 mm at 3.3 mm from the edges, pin rows 5.2 mm from the sides</p>

| Board | Size | Holes (centres) | Holes | Headers |
|---|---|---|---|---|
| A | 20 × 20 | 15 × 15 | not stated | 4-pin connector |
| B (the kit, sold with the magnet) | 23.3 × 22.8 × 1.6 thick; 3.22 over the chip | 16.7 × 16.2 (3.3 from each edge) | Ø 3.6 (M3) | 3 pins and 4 pins, 12.9 apart, along the 22.8 side |

| Item | Model | Hardware | Status |
|---|---|---|---|
| Board mounting | 4 diagonal slots from the 15 × 15 to the 17 × 17 position, 3.5 wide, on 2 mm standoff pads (Ø 5.5, a 1 mm wall around the slot; the lower 1 mm flares at 45° to Ø 7.5, clear of the solder joints under the board) | both boards above, M3 or smaller screws | ✅ board B's holes form a rectangle, 0.18 off the slot axis; the 3.5 width lets an M3 through |
| Screws | through board, pad and 4 mm plate | M3 × 12 + nut, or smaller screws with nylon washers if the holes are small | ✅ adapt to the board |
| Wiring | one diamond window, 13.5 point to point, under the chip | wires soldered straight to the board (no headers) | ✅ the wires run inward under the board (2 mm standoff gap) and down through the window |
| Magnet to chip | 1.5 nominal (`enc_gap`), set exactly on assembly: rest the magnet on a 1 mm shim laid on the chip, then tighten the cap's grub screw | AS5600: 0.5–3 recommended | ✅ the cap slides ±1, which also covers washers under the board |
| Magnet pocket | Ø 4.2 × 2.2 | 3.95 × 2 (kit, measured) | ✅ |

## Magnet cap on the shaft

| Item | Model | Hardware | Status |
|---|---|---|---|
| Cap | Ø 14 × 12, printed bore down | | ✅ |
| Bore | Ø 5.2 × 8.8 deep; the shaft reaches 4.6 in | Ø 5 rod | ✅ |
| Fixing | one radial M3 grub screw, 2 above the shaft end, self-tapping | M3 grub screw, 6 or 8 long | ✅ the cap must never turn on the shaft, or the firmware loses its "closed" reference |
| Height | slides ±1 before tightening; 1 mm below the bearing boss at its highest | | ✅ |

## O-rings and the foam insert

| Item | Model | Hardware | Status |
|---|---|---|---|
| Spigot | Ø 83.7, 1 mm 45° lead-in chamfer at the tip (`sp_od`, `sp_lead`) | foam hole about Ø 83.3 (3-1/4 in hole saw, measured 83.3 across the teeth, body 82.6) | ✅ the unit fits the holes in the 112 mm XPS insert perfectly, without O-rings (about 0.4 mm of squeeze; saws vary, so with another saw test on a scrap: sand a tight hole, use the O-rings in a loose one) |
| Groove bottom / width | Ø 78.5 / 4.2, two per spigot (`oring_floor`), only with `orings = true` (off by default; `oring_test` always has one) | O-ring 74 × 3, nitrile 70A (optional) | ✅ stretched about 6%: a little over the usual 5%, fine at these tiny pressures |
| Spigot bore | tapers from Ø 74 at the stop ring (as the duct) to Ø 75.7 at the tip (`sp_wall` 4); wall 4.85 → 4.0 | | ✅ the floor drops 0.85 mm toward the outdoor end, so condensation drains out; thickest at the root; about 1.6° from vertical when printing |
| Wall under the groove | 1.45 at the tip end, 2.05 near the stop ring | | ✅ no load on the spigot |
| Groove profile | flat floor, straight wall on the stop-ring side, 45° wall on the tip side (`oring_slope`) | | ✅ the spigots print tip up, so no wall is a flat overhang; the O-ring bears on the floor and the straight wall when pushed in |
| Squeeze in the hole (with O-rings) | about 20% in an 83.3 hole | | 📏 test the fit |
| Cold | nitrile is rated to −20 °C | | ✅ the grooves are in the room-side half of the foam, well above that |
| Hole spacing in the foam | 96 vertically, centred in the gap | the drilling template (100 and 112 width guides) | ✅ drilled with the template in the 112 mm insert |
| Drill guide (`drill_guide`, optional) | two bushings 24 apart, 20 tall; bores `guide_d` [6.35, 6.5] + 0.2 (`guide_clear`); V-notches on the template's centre line and cross arms | 1/4 in bit (pilot holes), 6.5 mm bit (probe), 75 mm of flute or more | 📏 run each bit through its bushing once; the bit can tilt about 0.6° at most |
| Insect screen frame (`screen_frame`) | 94 wide (`scr_w`), 5 thick (`scr_t`): between the caps' lips (96 apart), flush with them | foam face between the lips | ✅ 1 mm clear on each side |
| Screen frame sleeves | Ø 83.3, 10 long, 1 mm lead-in, bore 79.3 (`scr_sleeve`) | the outdoor 25.8 mm of each hole (the spigots fill the room-side 25) | 📏 a light fit in an 83.3 hole; the bore is wider than the 74 duct |
| Spline groove | 2.8 wide, 3 deep, 0.4 chamfer at the mouth (`scr_groove`, `scr_chamf`), one stadium around both holes | 0.125 in (3.2 mm) screen spline, or 3 mm O-ring cord, over fibreglass mesh | ✅ tested with the screen kit's spline and fibreglass mesh: it rolls in well and holds. The O-ring cord is untried: test it in `screen_test` first, and adjust `scr_groove[0]` if needed |
| Condensation drains | 15 wide at the bottom of each hole, through the sleeve and the plate (`scr_drain`): the floor is flush with the hole's floor inside, 1 lower at the outdoor face | water running along the hole's floor | ✅ no step for it to pool against, so it runs out under the mesh; the frame's bottom end is 3 lower (193 tall), so the groove keeps a 3 mm wall under the lower drain |
| Screen frame screws | 4 corners, Ø 4.25 holes, countersunk for an 8 mm head 3.5 high (`scr_screw`), 8.8 wide at the face (`scr_csk`) | countersunk screws, 8 mm head, about 25 mm long | ✅ about 20 mm into the foam, 9 mm clear of the holes; tested on the reprinted frame: the heads sit just below the face (the latch cover's, 0.4 wider than the head, stood 0.75 proud) |
| Probe hole vs frame | frame top 95 above the vent's centre | probe hole at 102, Ø 6.5 | ✅ about 3.7 mm clear |
| Drip tray (`tray`, optional) | 112 × 115 outside, from 6 off the foam (`tray_back`), 1.6 floor, walls 10 above it; the posts 1 beside the box (`tray_gap`); the box stands on seven 3 mm ribs, evenly spaced 13.1 apart, each 2 mm short of the walls at its ends (the outer two, close beside the posts, 2 mm short of the posts) (`tray_floor`, `tray_rim`, `tray_rib`) | window ledge; the bottom cap's lip (4.8 thick) at the foam; about 20 from the fans' edge to the window frame's wall | ✅ clear of the lip; 15.9 past the fans on each side, so about 4 from the wall; no slit narrower than 2 beside a post; no contact with the housing, fans or box except the box on the ribs (checked in the model); printed and in use under the unit |
| Tray legs | M3 screw in from below, its head up in a 45° pyramid at the socket's top (2 mm hex key from above); square 9 × 20 foot with a captive nut in a 9.4 socket; M2 × 6 flat head stop through the post's outer wall (3.5 thick, `tray_pwall`; shallow 90° countersink, 3.0 at the face: 2.8 mm of thread; the inner wall left whole), 3 above the floor's underside, in a groove up the foot and open to its bore (`tray_post`, `tray_sock`, `tray_foot`, `tray_screw`, `tray_pin`, `tray_range`) | M3 × 20 button head (ISO 7380) + M3 nut + M2 × 6 flat head, per leg | ✅ tested in `tray_test`: the head seats in the pyramid, the foot slides and the stop holds it at both ends; range 4 to 11 under the floor, set by the groove (asserts check the screw, nut and groove over it). ✅ On the full tray, the four legs set the unit's height and tilt to line it up with the foam holes. A flush countersink (3.6 at the face, 1.25 deep, to the measured head, 3.38 × 1.2) was tried on the full tray: the heads still stood a little proud (the countersink prints on its side, so it comes out small) and only 2.25 mm of thread was left, so it went back to the shallow one; the heads stand a little proud, fine for a stop that carries no load. The first design's bridged head slot sagged without supports, and its supports couldn't be removed |
| Tray floor | 1.6 thick, 5 bottom layers | water | 📏 fill it once before use |

## Electronics box (`ebox`) and cables

| Item | Model | Hardware | Status |
|---|---|---|---|
| Inside | 75.2 × 71.6, 34 high under the encoder plate | perfboard 70 × 50; TMC2209 with its heatsink, soldered: 23.9 above the floor; in female headers: 32.4 ([drawing](doc/tmc2209.svg); measured: PCB 20.81 × 15.08 × 1.62, spacer 2.62, pins 5.80, 14.70 from the PCB underside to the heatsink top) | ✅ 10.1 under the plate (1.6 in headers) |
| Perfboard standoffs | 4, 5 high, 66 × 46.26 apart (`pb_holes`), Ø 1.8 pilot | 5 × 7 cm protoboard, 1.51 thick, Ø 2.3 holes (measured: 63.70 and 43.96 between their facing edges) | ✅ M2 × 6 (laptop screws) |
| Layout | Boards soldered on the perfboard's grid (24 × 18 holes at 2.54, centred; `pb_grid`). ESP32 across the back half: back pins in row 0, USB-end pins in column 22 (`esp_col`, `esp_row`; one free column beyond, 9.6 mm from the left wall), or turned 180° toward the right wall (`ebox_elec_alt`); TMC2209 pins from column 4, rows 12 and 17 (`tmc_col`, `tmc_row`); TMC2209 front right, by the cable entry ([drawing](doc/ebox_layout.svg)) | | ✅ |
| USB-C (power and console) | 18 mm diamond in each side wall (`usb_side`, `usb_port`; `"mark"` engraves a cross to drill a 12 mm hole instead), centre 12.5 above the inner floor (ESP32 soldered) | plug 11 × 6.25, 20 long, through the wall and about 10 into the box; 5 V USB-C adapter | ✅ centred on the USB-UART connector (`usb_dy = 6`, measured: 8.25 from the board's TX/GND edge); the ESP32 lies components up, its 3V3/5V header row toward the window (toward the room when turned; the right-hand diamond is mirrored to match, 6 toward the window); both layouts checked clear of the standoffs |
| Power | no buck converter: 12 V brick for VM, fans and the 12 V sense; the ESP32 on USB | the brick's GND joined to the ESP32's GND on the perfboard | 📏 the board's 3.3 V regulator is a SOT-223 (usually an AMS1117-3.3, about 1 A); confirm its marking (about 600 mA peaks: Wi-Fi plus the SCD40) |
| Cable entries | notch at the top of each side wall, toward the front, 16 × 10 | 12 V brick wire, two fan cables, motor cable | ✅ use the one on the cable side |
| Fixing | 2 × M3 × 12 through the front cover into bosses (Ø 2.5 pilot) at the bay walls; 2 × M3 × 12 from above through the plate into back tabs | | ✅ |
| Contact with the housing | zero overlap (checked by `tools/check.py`) | | ✅ |
| Tie-wrap anchors | 3 on each side, 6 tall off the back of the fan plate (about 1.75–2 mm of material all around the slot), with a rounded back (radius 4) for the wires to rest on; top and bottom touch the outer fan nut pockets; house-shaped slot on the plate, 4.5 wide with 2 mm straight walls and a 45° roof (no flat ceiling when printing); same slot shape in both motor tower walls | tie wraps up to 3.6 wide | ✅ |
| SCD40 | not on the unit: on a free cable, out through a cable entry | I²C, about 1–2 m | ✅ place it in the room (near head height), away from the fresh-air jet, the electronics box and the sun; run the bus at 100 kHz or slower, pair SDA and SCL with GND and VCC |

## Split housing (`body_top`, `body_bottom`, `splice`): 180 mm printers only

| Item | Model | Hardware | Status |
|---|---|---|---|
| Part sizes | 90 × 130 × 114, 90 × 116 × 114, 60 × 32 × 6 | 180 × 180 × 180 bed (A1 mini) | ✅ |
| Halves = housing | identical except the four joint screw holes | | ✅ `check.py`, check 6 |
| Joint screws | Ø 3.4 holes through 6 (fan plate) + 6 (splice) | M3 × 12 countersunk (length includes the head): ends flush with the back of the splice, full nut engagement | ✅ |
| Nut pockets (back of the splice) | hex 5.8 across flats, 2.6 deep | M3 nut: 5.5 AF, 2.4 thick | ✅ |
| Screw heads on the fan face | 90° countersinks, Ø 7 at the face, at z = ±4.5 | flat head Ø 5.5–6.7 | ✅ flush or just below the fan face, so no contact with the fan frames (they start at ±8); 45° walls print from the bed without bridging |
| Splice to the ducts | 1 mm clearance all round | | ✅ |
| Middle tie-wrap anchors | whole, on `body_top`; the cut steps down 5 mm under them (1 mm below the anchor), so they print from the bed | | ✅ |
| Alignment | 0.2 mm radial play in the screw holes | shaft through all four bearing holes | ✅ tighten the screws after the shaft is in |
| Both halves from the same spool and profile | | | 📏 shrinkage must match for the shaft line |

## Open questions

None. The kit magnet (3.95 × 2) and the kit board are measured and in the model.
