mmassico/window_air_vent/images/assembly.png

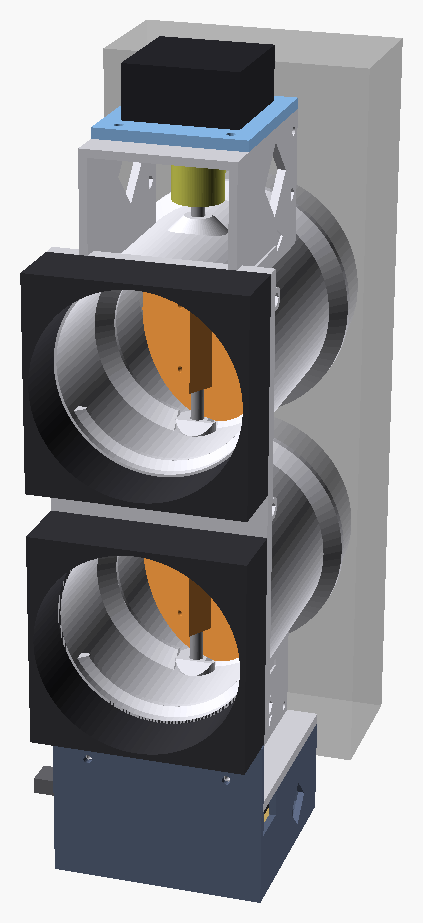
images/assembly.png
