mmassico/window_air_vent/pcb/window_vent_ctrl_devkitc.kicad_pcb

## KiCad design pcb/window_vent_ctrl_devkitc.kicad_pcb (2026-11-13)

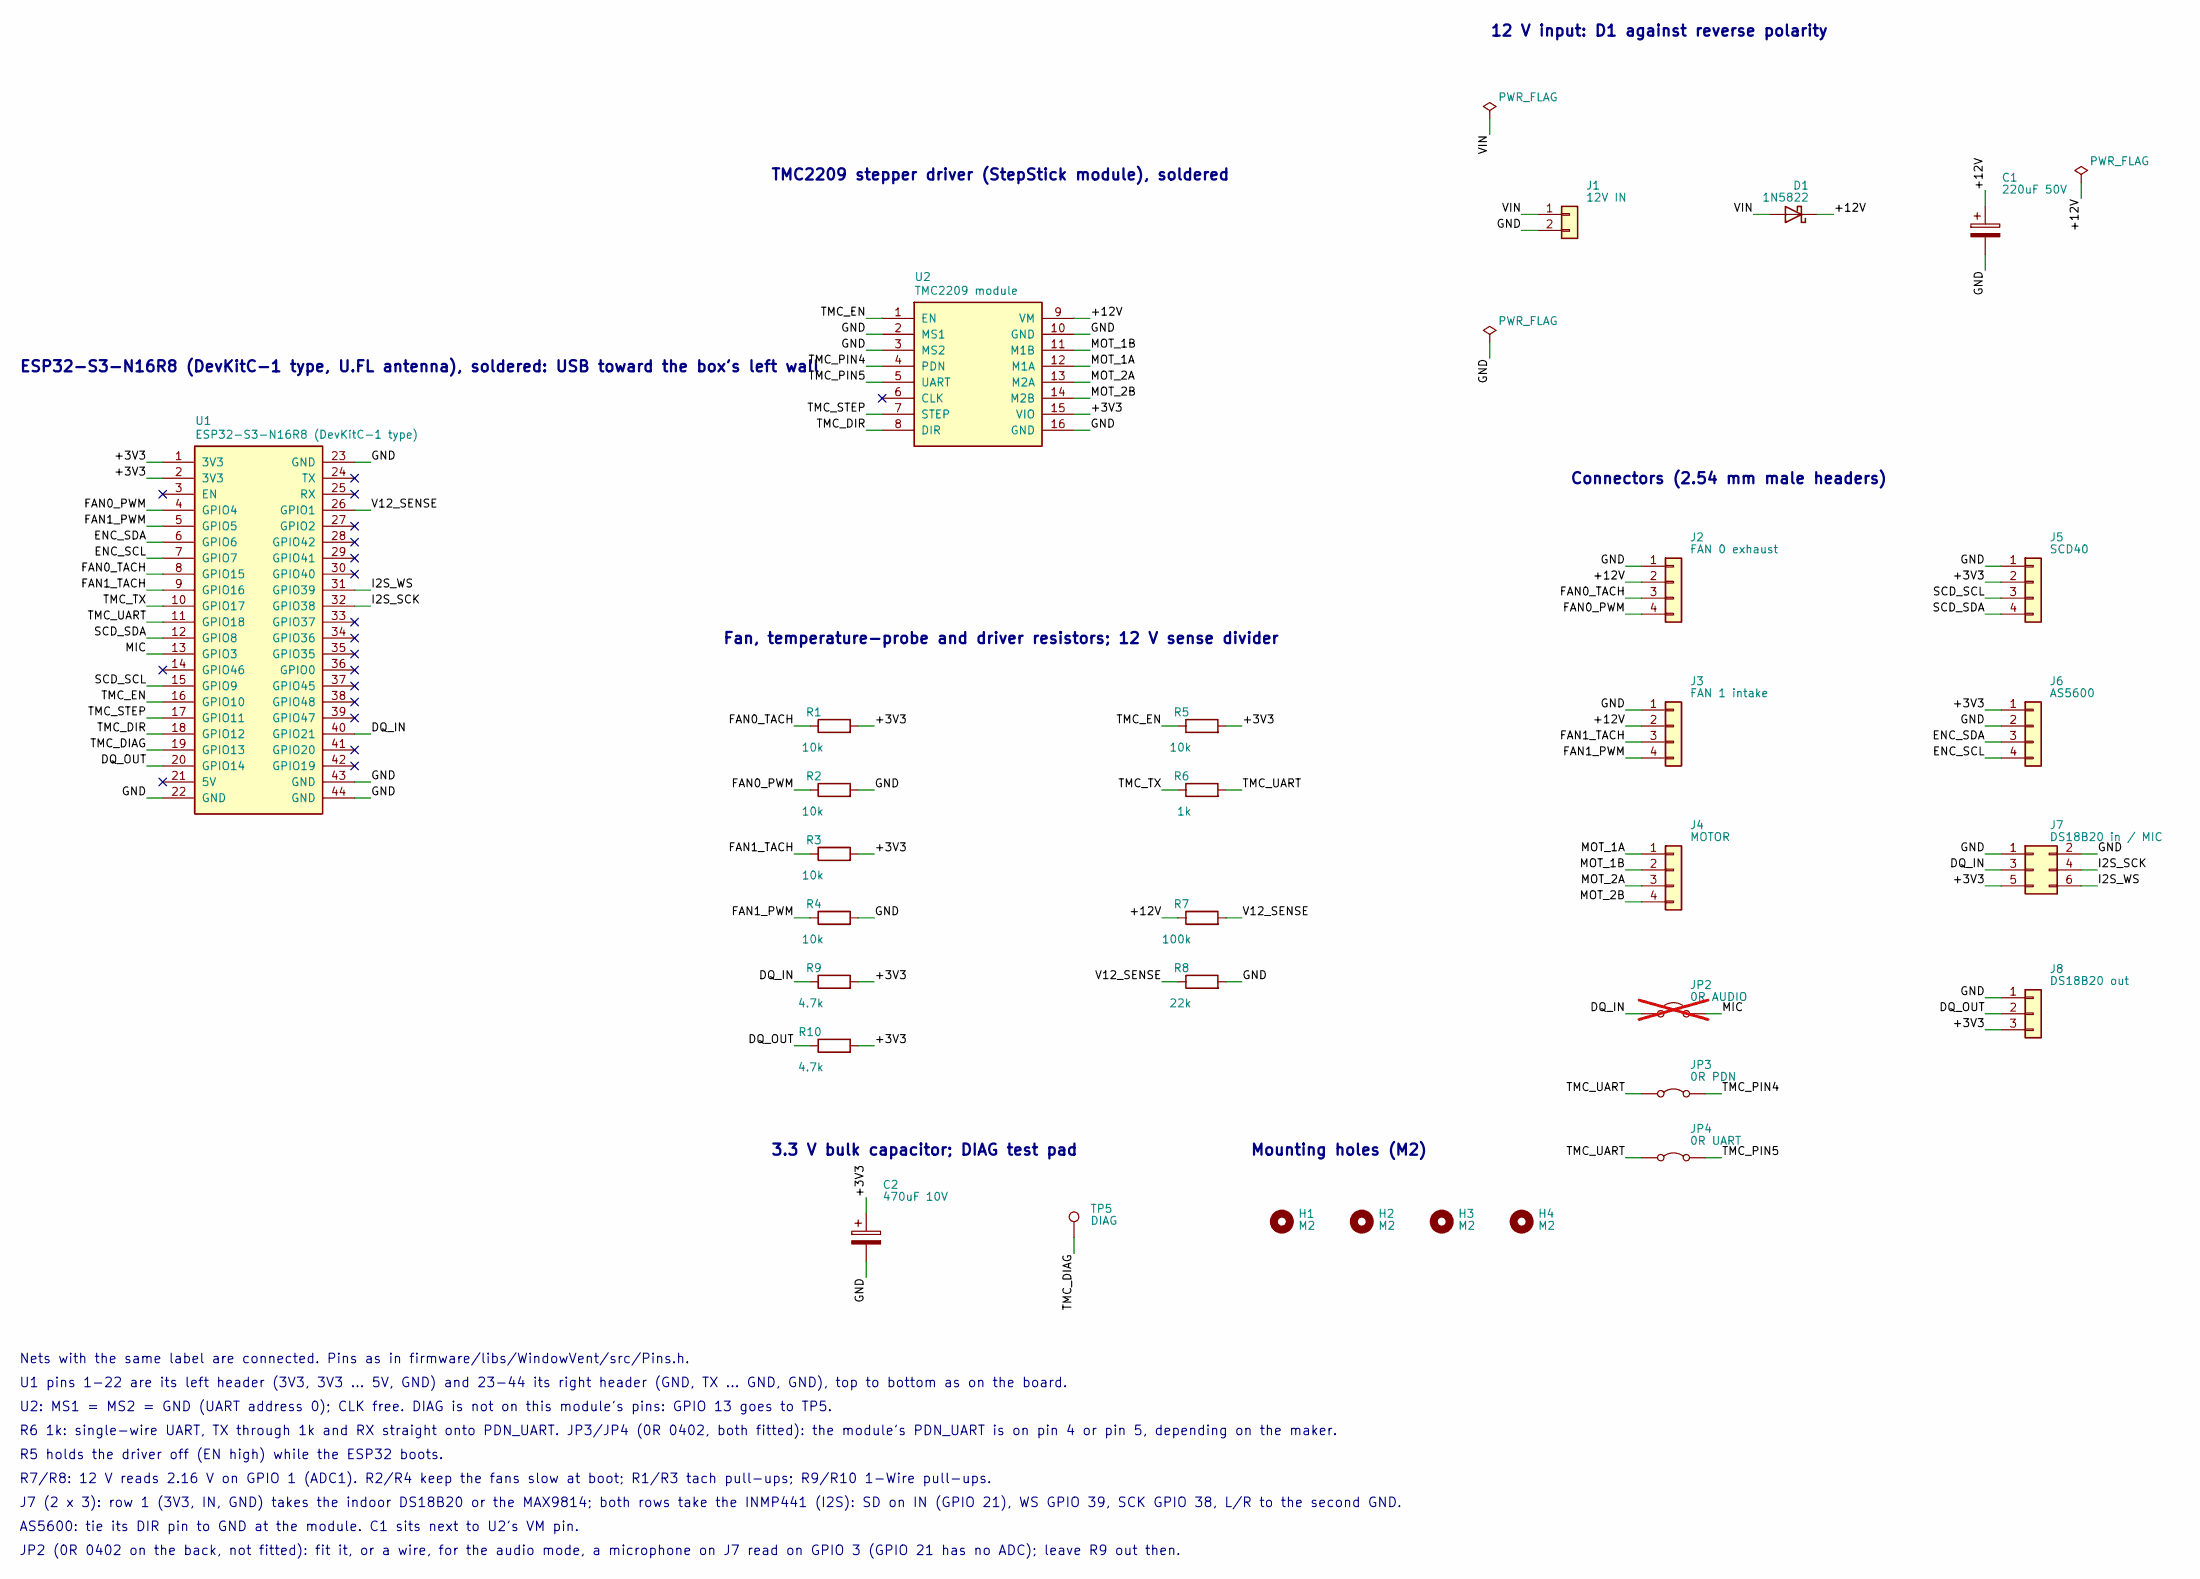
[picture p153: schematic window_vent_ctrl_devkitc.kicad_sch, Window vent controller]

Parts:
C1: 220uF 50V; CP_Radial_D10.0mm_P5.00mm
C2: 470uF 10V; CP_Radial_D6.3mm_P2.50mm
D1: 1N5822; D_DO-201AD_P5.08mm_Vertical_AnodeUp_Tight
H1, H2, H3, H4: M2; MountingHole_2.2mm_M2
J1: 12V IN; PinHeader_1x02_P2.54mm_Vertical
J2: FAN 0 exhaust; PinHeader_1x04_P2.54mm_Vertical
J3: FAN 1 intake; PinHeader_1x04_P2.54mm_Vertical
J4: MOTOR; PinHeader_1x04_P2.54mm_Vertical
J5: SCD40; PinHeader_1x04_P2.54mm_Vertical
J6: AS5600; PinHeader_1x04_P2.54mm_Vertical
J7: DS18B20 in / MIC; PinHeader_2x03_P2.54mm_Vertical
J8: DS18B20 out; PinHeader_1x03_P2.54mm_Vertical
JP2: 0R AUDIO; R_0402_1005Metric_Pad0.72x0.64mm_HandSolder; not fitted
JP3: 0R PDN; R_0402_1005Metric_Pad0.72x0.64mm_HandSolder
JP4: 0R UART; R_0402_1005Metric_Pad0.72x0.64mm_HandSolder
R1, R2, R3, R4: 10k; R_Axial_DIN0207_L6.3mm_D2.5mm_P2.54mm_Vertical
R5: 10k; R_DIN0207_P10.16mm_Flat_Tight
R6: 1k; R_DIN0207_P10.16mm_Flat_Tight
R7: 100k; R_DIN0207_P10.16mm_Flat_Tight
R8: 22k; R_DIN0207_P10.16mm_Flat_Tight
R9, R10: 4.7k; R_DIN0207_P10.16mm_Flat_Tight
TP5: DIAG; TestPoint_THTPad_D2.0mm_Drill1.0mm
U1: ESP32-S3-N16R8 (DevKitC-1 type); ESP32S3_DevKitC_N16R8
U2: TMC2209 module; TMC2209_StepStick

Connections:
/+3V3: C2.1, J5.2, J6.1, J7.5, J8.3, R1.2, R3.2, R5.2, R9.2, R10.2, U1.1 (3V3), U1.2 (3V3), U2.15 (VIO)
/+12V: C1.1, D1.1 (K), J2.2, J3.2, R7.1, U2.9 (VM)
/DQ_IN: J7.3, JP2.1 (A), R9.1, U1.40 (GPIO21)
/DQ_OUT: J8.2, R10.1, U1.20 (GPIO14)
/ENC_SCL: J6.4, U1.7 (GPIO7)
/ENC_SDA: J6.3, U1.6 (GPIO6)
/FAN0_PWM: J2.4, R2.1, U1.4 (GPIO4)
/FAN0_TACH: J2.3, R1.1, U1.8 (GPIO15)
/FAN1_PWM: J3.4, R4.1, U1.5 (GPIO5)
/FAN1_TACH: J3.3, R3.1, U1.9 (GPIO16)
/GND: C1.2, C2.2, J1.2, J2.1, J3.1, J5.1, J6.2, J7.1, J7.2, J8.1, R2.2, R4.2, R8.2, U1.22 (GND), U1.23 (GND), U1.43 (GND), U1.44 (GND), U2.2 (MS1), U2.3 (MS2), U2.10 (GND), U2.16 (GND)
/I2S_SCK: J7.4, U1.32 (GPIO38)
/I2S_WS: J7.6, U1.31 (GPIO39)
/MIC: JP2.2 (B), U1.13 (GPIO3)
/MOT_1A: J4.1, U2.12 (M1A)
/MOT_1B: J4.2, U2.11 (M1B)
/MOT_2A: J4.3, U2.13 (M2A)
/MOT_2B: J4.4, U2.14 (M2B)
/SCD_SCL: J5.3, U1.15 (GPIO9)
/SCD_SDA: J5.4, U1.12 (GPIO8)
/TMC_DIAG: TP5.1, U1.19 (GPIO13)
/TMC_DIR: U1.18 (GPIO12), U2.8 (DIR)
/TMC_EN: R5.1, U1.16 (GPIO10), U2.1 (EN)
/TMC_PIN4: JP3.2 (B), U2.4 (PDN)
/TMC_PIN5: JP4.2 (B), U2.5 (UART)
/TMC_STEP: U1.17 (GPIO11), U2.7 (STEP)
/TMC_TX: R6.1, U1.10 (GPIO17)
/TMC_UART: JP3.1 (A), JP4.1 (A), R6.2, U1.11 (GPIO18)
/V12_SENSE: R7.2, R8.1, U1.26 (GPIO1)
/VIN: D1.2 (A), J1.1

Notes on the sheet:
ESP32-S3-N16R8 (DevKitC-1 type, U.FL antenna), soldered: USB toward the box's left wall
TMC2209 stepper driver (StepStick module), soldered
12 V input: D1 against reverse polarity
Connectors (2.54 mm male headers)
Fan, temperature-probe and driver resistors; 12 V sense divider
3.3 V bulk capacitor; DIAG test pad
Mounting holes (M2)
Nets with the same label are connected. Pins as in firmware/libs/WindowVent/src/Pins.h.
U1 pins 1-22 are its left header (3V3, 3V3 ... 5V, GND) and 23-44 its right header (GND, TX ... GND, GND), top to bottom as on the board.
U2: MS1 = MS2 = GND (UART address 0); CLK free. DIAG is not on this module's pins: GPIO 13 goes to TP5.
R6 1k: single-wire UART, TX through 1k and RX straight onto PDN_UART. JP3/JP4 (0R 0402, both fitted): the module's PDN_UART is on pin 4 or pin 5, depending on the maker.
R5 holds the driver off (EN high) while the ESP32 boots.
R7/R8: 12 V reads 2.16 V on GPIO 1 (ADC1). R2/R4 keep the fans slow at boot; R1/R3 tach pull-ups; R9/R10 1-Wire pull-ups.
J7 (2 x 3): row 1 (3V3, IN, GND) takes the indoor DS18B20 or the MAX9814; both rows take the INMP441 (I2S): SD on IN (GPIO 21), WS GPIO 39, SCK GPIO 38, L/R to the second GND.
AS5600: tie its DIR pin to GND at the module. C1 sits next to U2's VM pin.
JP2 (0R 0402 on the back, not fitted): fit it, or a wire, for the audio mode, a microphone on J7 read on GPIO 3 (GPIO 21 has no ADC); leave R9 out then.

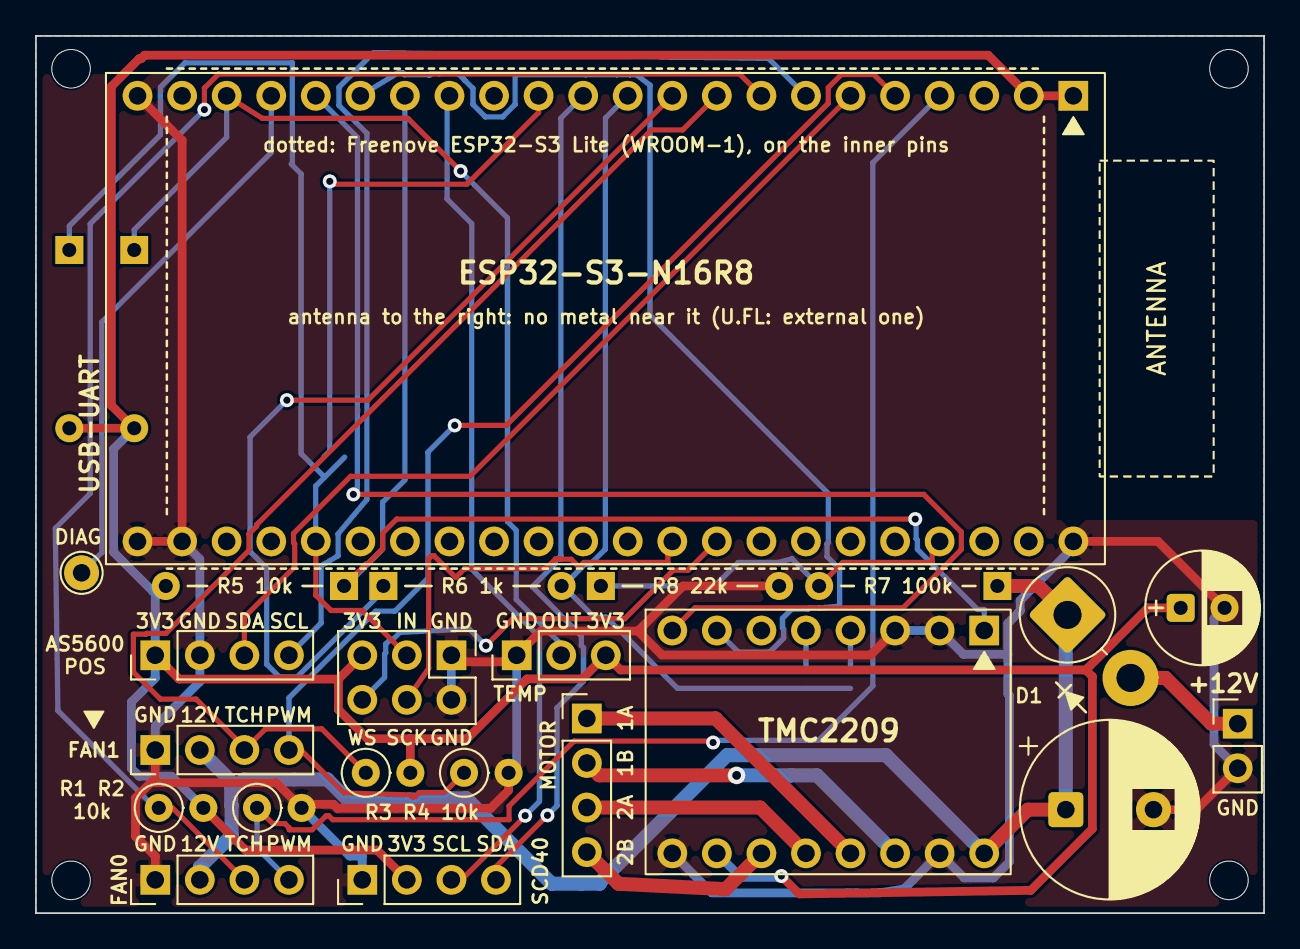
[picture p154: board window_vent_ctrl_devkitc.kicad_pcb from above]

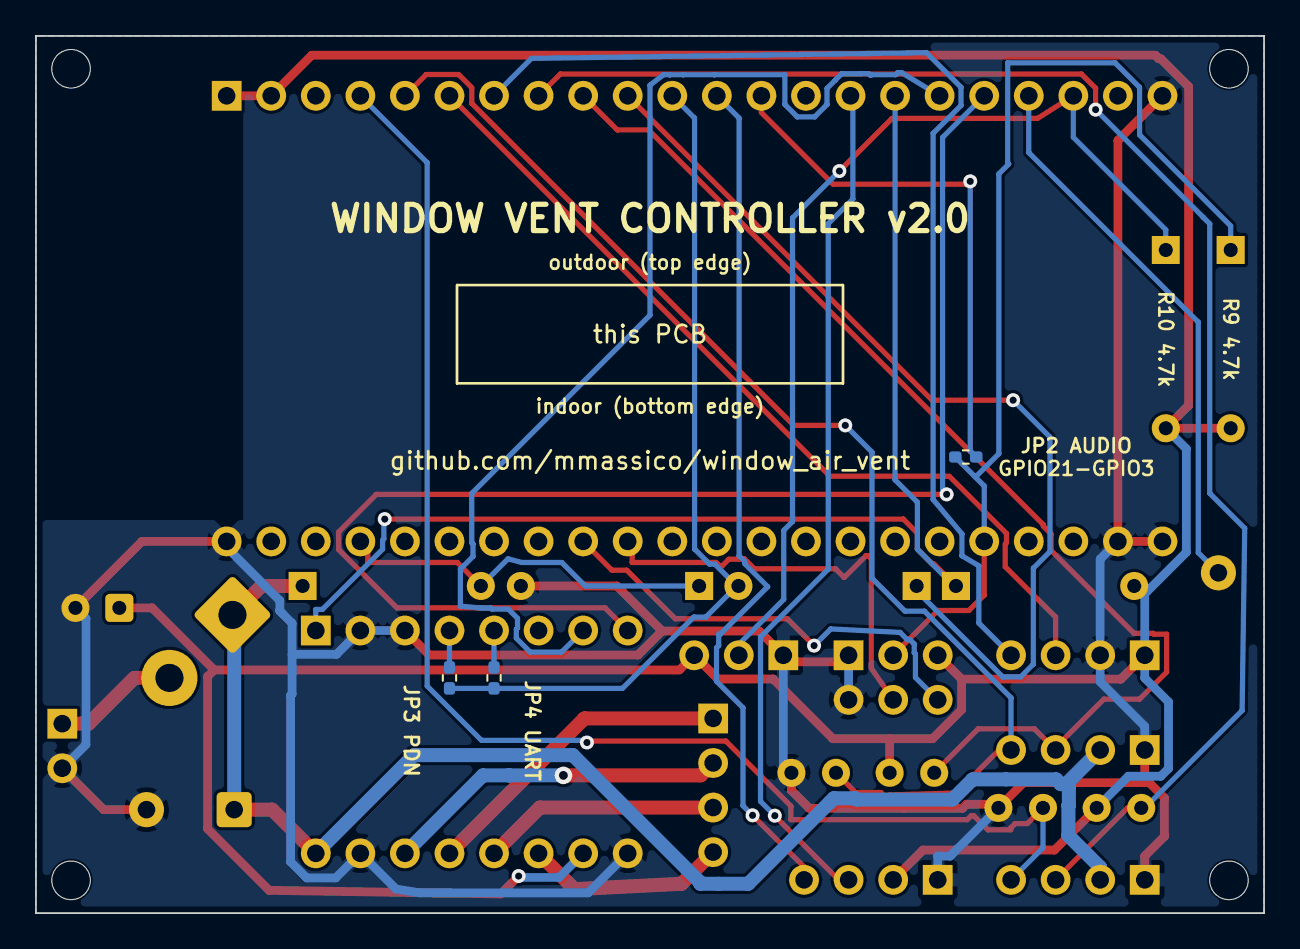
[picture p155: board window_vent_ctrl_devkitc.kicad_pcb from below]

Board: 2 copper layers, 70.0 x 50.0 mm, 31 parts (5 on the bottom side), 30 nets.
