mmassico/window_air_vent/(commit log)

2026-10-18 Window vent: dual butterfly damper with two 80 mm fans
    A CO2-controlled window ventilator for one room. A printed housing on
    the room face of a foam window insert holds two butterfly dampers on
    one vertical 5 mm shaft (NEMA 17 pancake stepper on top, AS5600
    magnetic encoder at the bottom), two 80 mm fans, and O-ring spigots
    that seal into the foam holes.
    Includes the parametric OpenSCAD model, exported STL parts, renders,
    the geometry check script (ALL CHECKS PASSED: parts, disc swing,
    lip stop, disc fitting path) and the README with hardware and prices.
    Licensed under CERN-OHL-P-2.0.
    [body.stl, disc.stl, magnet_cap.stl, motor_plate.stl, window_vent.scad]
2026-10-18 Curved shaft bosses, two grub screws per disc
    The shaft bosses at the top and bottom of each bore are now a tall
    cylinder cut by a bore-axis cylinder at the disc's sweep radius plus
    0.3 mm, so their inner face follows the disc edge with an even gap of
    about 0.75 mm (it was 0.6 to 1.6 mm with flat faces). The drip dam's
    inner face uses the same radius (clearance 0.15 -> 0.3 mm).
    Each disc now clamps the shaft with two M3 grub screws 24 mm apart
    (grub_n, grub_sp), so it can't rock on the shaft.
    Re-export the STLs, refresh the renders, add a view along the duct at
    the closed disc, and update the README. check.py: ALL CHECKS PASSED.
    [body.stl, disc.stl, magnet_cap.stl, motor_plate.stl, window_vent.scad]
2026-10-18 Add part descriptions and thumbnails to the README
    The printed parts table now has a description and a small render of
    each part (images/part_*.png), like the HRV project's README.
2026-10-18 Added "assembly_nofan" to the .scad.
    [window_vent.scad]
2026-10-19 Electronics box, encoder mount, test prints and pre-print checklist
    - AS5600 mount: diagonal slots for both common boards (15 and 17 mm
    hole squares) on 2 mm standoff pads, with a wire window below.
    - Magnet cap: 14 x 12 mm with a radial M3 grub screw; it slides +/- 1 mm
    so the gap is set on assembly with a 1 mm shim. Encoder plate lowered.
    - O-ring grooves sized for 74 x 3 mm O-rings (4.7% stretch, about 23%
    squeeze in an 82 mm foam hole).
    - Electronics box (ebox) under the housing: 5 x 7 cm perfboard carrier
    for the ESP32 and the TMC2209, front cover closing the bottom bay,
    four M3 fixings, cable entries on both sides. The encoder plate is
    its lid. check.py verifies it only tou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
    [body.stl, disc.stl, ebox.stl, fittest.stl, magnet_cap.stl, motor_plate.stl, oring_test.stl, window_vent.scad]
2026-10-19 Add bare-metal validation firmware (MIT)
    Serial command console for the ESP32-S3 to test each part on its own:
    SCD40, AS5600, TMC2209 and stepper, fans, 12 V sense, generic I2C.
    Firmware README with wiring, Arduino settings and bring-up steps.
    Ignore ref_designs/ and build output.
2026-10-19 Name the USB connectors as on the board's silkscreen
    Refer to USB-UART (onboard code uploader) and USB-OTG instead of the
    CH343 chip, explain USB CDC On Boot, and drop the unverified left/right
    port description.
2026-10-19 Describe stage 2 as the standalone LAN WebUI
2026-10-19 Add a wiring diagram for the bare-metal firmware
    firmware/images/wiring.svg shows every peripheral, pull resistor and
    supply connection; tools/wiring_svg.py draws it from the same pin list
    as Pins.h.
2026-10-19 Add a split housing for 180 mm printers
    body_top and body_bottom: the housing cut midway between the ducts, each
    printed fan plate down like the full body. A splice plate behind the fan
    plate joins them with 4 x M3 x 10, heads in counterbores between the fans.
    The middle tie-wrap anchors stay whole on the top half. check.py verifies
    the halves equal the housing minus the screw holes; all checks pass.
    [body_bottom.stl, body_top.stl, splice.stl, window_vent.scad]
2026-10-20 Print without supports, fit the measured parts, add optional louvers
    Housing and parts:
    - 45 deg faces wherever something would print in mid-air: O-ring groove
    wall, outer shaft-boss domes, plane cut on the inner bosses, conical
    lip B with a matching bevel on half of each disc (engraved B), rounded
    tie-wrap anchors with house-shaped slots, AS5600 pad flares
    - Water channel past lip B in each floor boss
    - Motor frame: diamond openings, 3 mm roof; motor plate with two front
    screws and two back tabs bolted through the tower walls (no nut pockets)
    - Split housing: countersunk joint screws, splice nut pockets up,
    middle anchors whole on body_top, split_assembly view
    - AS5600 kit board a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
    [body.stl, body_bottom.stl, body_top.stl, disc.stl, ebox.stl, fittest.stl, louver_blade.stl, louver_chassis.stl]
2026-10-20 Regenerate the images, add a dimensioned AS5600 drawing
    - tools/render_images.py regenerates every README image from the models
    with the original cameras; all images now show the current design
    - doc/as5600.svg (drawn by tools/as5600_svg.py): the measured AS5600 kit
    board, shown in the README hardware section and the checklist
2026-10-20 Lay out the electronics box: ESP32, TMC2209, USB-C power
    - Model the perfboard, ESP32-S3 (with its USB-C plug) and TMC2209 in the
    box (views ebox_elec and ebox_elec_alt); box 2 mm taller for the
    TMC2209's heatsink in headers.
    - ESP32 at the back, its USB end 3 holes in from a side wall, clear of
    the corner standoff; it can face the left or the right wall.
    - 18 mm diamond in each side wall for the USB-C cable (usb_side,
    usb_port), centred on the USB-UART connector.
    - Power: a 12 V brick plus a 5 V USB-C adapter; no buck converter.
    - Add to-scale drawings of the box layout and the ESP32 board.
    - check.py: the boards fit the box in both layouts.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
    [body.stl, body_bottom.stl, body_top.stl, disc.stl, ebox.stl, fittest.stl, magnet_cap.stl, motor_plate.stl]
2026-10-20 Add board drawings to the README, solder the TMC2209, lip foam templates
    - README: new sections with the ESP32-S3, TMC2209 and electronics box
    layout drawings.
    - New dimensioned TMC2209 drawing (tools/tmc2209_svg.py). Model: pins
    and spacer drawn, heatsink turned (fins along the pin rows), heights
    as on the ESP32.
    - TMC2209 soldered to the perfboard by default (tmc_mount); female
    headers stay optional and still fit.
    - Box layout drawing: this perfboard (70 x 50), the largest that fits
    (74 x 63), and the standoffs (66 x 46).
    - Full-size cutting templates for the lip foam, flat and unrolled
    conical lips (tools/lip_templates_svg.py: SVG, Letter PDF and a
    README preview). Hardware: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
    [window_vent.scad]
2026-10-20 README: M3 x 12 also fits the motor plate screws
2026-10-20 README: say where the lips are in assembly step 1
2026-10-20 Disc: teardrop shaft bore, prints without support
    The hub's horizontal 5.2 mm bore gets a 45 deg point on top, toward the
    grub screws: no support inside it, and the screws press the shaft into
    the round lower half. Disc STL and the images that show it regenerated.
    [disc.stl, window_vent.scad]
2026-10-20 Add the motor drawing; motor screws M3 x 6
    - New dimensioned drawing of the 17HS08-1004S stepper (tools/motor_svg.py),
    from the maker's sheet, checked with a caliper; shown in the README.
    - Its M3 holes are only 2.5 mm deep, so the motor screws through the 4 mm
    plate are now M3 x 6 (M3 x 8 would bottom out).
    [window_vent.scad]
2026-10-21 Added doc/motor_mount.svg.
2026-10-21 Motor plate: 2 mm bosses so M3 x 8 fits the motor's 2.5 mm holes
    - A 6 x 2 mm boss under each motor screw hole (mp_boss): through the
    4 mm plate and the boss, an M3 x 8 reaches 2 mm into the motor, 0.5 mm
    short of the bottom of its 2.5 mm holes.
    - The frame's small diamond pockets grow from 6.5 to 8 mm across the
    flats (mp_pocket), 1 mm clear around each boss.
    - Section drawing of a motor screw (tools/motor_mount_svg.py), checklist
    rows, STLs and images regenerated.
    [body.stl, body_bottom.stl, body_top.stl, disc.stl, ebox.stl, fittest.stl, magnet_cap.stl, motor_plate.stl]
2026-10-21 Fixed thumbnails for louvers.
    [window_vent.scad]
2026-10-21 README: thumbnails and an intro for the test prints
    - Thumbnail column in the test prints table, as in the part tables; new
    render of oring_test (added to tools/render_images.py).
    - A short paragraph introducing the fit-test coupon and its A to G table.
    [render_images.py]
2026-10-21 Wiring: two DS18B20 temperature sensors (outdoor, optional indoor)
    - Outdoor DS18B20 (waterproof probe through the foam) on GPIO 14, indoor
    one on GPIO 21, each with a 4.7 k pull-up to 3V3. The indoor one is
    optional (dotted in the diagram): the SCD40 also reads room temperature.
    - Wiring diagram, firmware README table and Pins.h updated; the sketch
    does not read them yet.
2026-10-21 Foam insert: 83 mm holes, snug plain spigots, drilling template
    - Spigots Ø 83.4 for 83 mm holes cut with a 3-1/4 in hole saw (about
    0.4 mm of squeeze in XPS), with a 1 mm lead-in chamfer. Plain by default
    (orings = false); the grooves, reworked for the 83 mm hole
    (oring_floor = 78.5), come back with orings = true. oring_test keeps its
    groove.
    - The spigot bore tapers from Ø 74 at the stop ring to Ø 75.4 at the tip
    (sp_wall = 4): condensation drains toward the outdoor end, and the wall
    is thickest at the root.
    - Full-size drilling template for the foam insert (Letter PDF, SVG and a
    README preview), with an optional hole for the outdoor DS18B20 probe.
    - Drawing of the 83 mm h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
    [body.stl, body_bottom.stl, body_top.stl, disc.stl, ebox.stl, fittest.stl, magnet_cap.stl, motor_plate.stl]
2026-10-21 Electronics: measured perfboard, boards on its grid; fan screws confirmed
    - Perfboard measured: Ø 2.3 holes at 66 x 46.26, 1.51 thick, a centred
    24 x 18 grid at 2.54 (pb_holes, pb_t, pb_grid). Standoffs and USB
    diamonds follow.
    - The ESP32 and TMC2209 are soldered on that grid, so their pins now land
    on its holes (esp_col, esp_row, tmc_col, tmc_row replace esp_dx and
    esp_dy). ESP32 end pins one column in from the edge: 3.1 mm clear of the
    corner standoff, 3.6 mm of its screw head.
    - Layout drawing redrawn on the real grid.
    - Checklist: M3 x 35 fan screws confirmed (8.75 out of the fan, tip 2.75
    past the plate, no washer); measured 5.31 mm nut; USB row heights fixed.
    Co-Authored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
    [ebox.stl, window_vent.scad]
2026-10-21 Firmware: DS18B20 temperature probes ('temp' command); hardware table
    - New Ds18b20 module with its own 1-Wire driver (open-drain GPIO, timing
    slots with interrupts held off, Skip ROM, CRC check), so the sketch
    still needs no library.
    - Console: 'temp' reads both probes, 'temp rom' shows their ROM codes;
    'info' lists them; 'mon' shows outdoor and indoor temperatures without
    blocking. Version 1.1. Compiles with no warnings; not run on hardware.
    - README: DS18B20 probe (outdoor, plus an optional indoor one) and its
    4.7 k pull-up in the hardware table; firmware README bring-up step and
    command list.
    [baremetal.ino]
2026-10-21 README: slicer settings for each part
    Wall loops and infill for each printed part (walls matter more than the
    infill for these thin parts), gyroid infill, 5 top and bottom layers, and
    how to block the supports the slicer may add in the shaft holes.
2026-10-21 AS5600 drawing: the diametric magnet over the chip
    The side view shows the kit's 3.95 x 2 mm magnet centred over the chip at
    its 1 mm working gap, with N and S across the diameter, and a note that an
    axial magnet would not work lying flat.
    [as5600_svg.py]
2026-10-21 README: say what each board does in its heading
    The AS5600, ESP32-S3 and TMC2209 headings now name the part's function:
    a magnetic rotary position sensor, the Wi-Fi microcontroller, a silent
    stepper motor driver.
2026-10-21 README: check the shaft holes on fittest before adding supports
    The housing row of the slicer settings and the supports note point to
    fittest feature D, the same horizontal shaft hole: if it prints clean
    without supports, so will the housing.
2026-10-21 Modified "assembly_nofan" view (added ebox + transparency)
    [window_vent.scad]
2026-10-22 Spigots to 83.7 for the measured hole saw; 30 psi XPS foam
    The 3-1/4 in hole saw measures 83.3 across its teeth (body 82.6), so the
    plain spigots go from 83.4 to 83.7 for about 0.4 mm of squeeze. The hole
    saw drawing now uses the measured diameters; README and checklist follow.
    README: the foam insert is 2 in XPS, 30 psi grade (e.g. FOAMULAR C-300),
    with a note on shiplap edges.
    [body.stl, body_bottom.stl, body_top.stl, oring_test.stl, window_vent.scad]
2026-10-22 README assembly view: rotate to show the discs in the tubes
2026-10-22 README: labelled assembly view
    images/assembly_lbl.png names the main parts (motor, motor plate and tower,
    coupler, fans, discs, shaft, spigot, housing, electronics box, foam).
    The unlabelled images/assembly.png stays in the repo.
2026-10-22 assembly_lbl.png: wider margins around the labels
2026-10-22 assembly_noplug view and the assembly_lbl render job
    window_vent.scad: electronics() and assembly() take plug = true; the new
    part "assembly_noplug" hides the ESP32's USB-C plug. Defaults unchanged.
    render_images.py: assembly_lbl renders assembly_noplug at 2x and adds
    labels with leader lines in side margins (anchors picked by hand, see
    ASM_LABELS).
    [window_vent.scad]
2026-10-22 Added wiring diagram in the "Firmware" section.
2026-10-22 Fixed image path for the wiring diagram image.
2026-10-23 Drill guide for perpendicular pilot holes in the foam insert
    New part drill_guide: two 20 mm bushings 24 apart on a 26 x 46 base,
    bores guide_d [6.35, 6.5] + 0.2 (hole saw pilot, probe), V-notches at
    the ends and beside each bushing to set on the drilling template's lines.
    Foam template: solid vertical centre line through all three holes, long
    cross arms for the side notches, hole labels moved right of the centre
    line (6 mm from both lines), drawing moved down 4 mm.
    README (drilling section, slicer table, volumes), checklist, check.py
    and render_images.py updated.
    [drill_guide.stl, window_vent.scad]
2026-10-23 Foam template: probe labels swapped, two lines above the arm, one below
    [foam_template_svg.py]
2026-10-24 TMC2209 measured: sizes, heights, heatsink position and profile
    Measured on the module: PCB 20.81 x 15.08 x 1.62, spacer 2.62, pins
    5.80, heatsink 15 x 14.4, 14.70 from the PCB underside to its top
    (13.08 above the PCB once its thermal sticker is pressed on).
    The heatsink sits toward the DIR/GND end, clear of the potentiometer,
    with the same 0.34 gap there as at its sides (model, tmc2209.svg,
    ebox_layout.svg). The drawing's side view now shows its 7 fins, the
    2.25 base with a 10 mm flat strip on the PCB, the edge reliefs over the
    pin tips, and the shallower outer valleys (3.5).
    Box clearance unchanged: 10.1 mm under the encoder plate (1.6 in headers).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
    [window_vent.scad]
2026-10-24 Hole saw drawing: measured pilot drill and arbor
    Pilot drill Ø 5.80, its full diameter leading the teeth by 12.0 (118 deg
    point beyond), arbor + pilot 93.5 (listed 98). The filed tooth now
    measures within the 83.3 sweep.
2026-10-24 Perfboard build plan (SVG for the README, 3-page PDF for the bench)
    tools/perfboard_svg.py draws the 5 x 7 cm protoboard with the ESP32-S3
    and the TMC2209 on their grid positions, headers J1-J8, R1-R10, C1, and
    61 numbered underside wires with a clearance check (no wire within 0.3
    pitch of a hole it does not connect). The PDF has the component side,
    the solder side and the wire list on landscape Letter pages.
    README: the plan under the wiring diagram in the Firmware section, and
    in the Files block.
    [perfboard_svg.py]
2026-10-24 Perfboard rows numbered as printed: 18 at the back, 1 at the front
    The protoboard's numbers run the other way from the plan's first
    version (A18 is the back right corner seen from above). Hole names in
    the plan, its wire list and notes follow; grid comments in the model
    and the box layout script say so. Placement and wiring unchanged.
    [window_vent.scad]
2026-10-24 Perfboard plan: semi-transparent white outline behind the pin labels
    Header and TMC2209 pin names get a white outline at 0.6 opacity, the
    ESP32-S3 pin names at 0.3, so they read over the dark housings and
    module outlines while what is behind them still shows. The header pin
    labels are also a little larger (9.5).
2026-10-24 Perfboard PDF: notes fit page 1 at 100 %, antenna label outlined
    The notes are paragraphs wrapped to each layout's width (210 characters
    on the landscape PDF page, 128 on the README sheet); page 1 drops to six
    lines, about 12 mm above the bottom edge, and the script refuses a page 1
    whose notes run lower. The "antenna: keep clear" label gets the same
    semi-transparent white outline as the pin labels, for paper.
2026-10-24 Perfboard plan: subtitles name the window and room sides
    "Component side, seen from above: window (outdoor) side at the top,
    room (indoor) side at the bottom" and "Solder side, turned over left to
    right: A on the left, window side still at the top", in the SVG and the
    PDF.
2026-10-24 Controller PCB (KiCad 10): schematic, layout, routing, Gerbers
    A 2-layer 70 x 50 mm board of the protoboard's size and M2 holes, with the
    ESP32-S3 and the TMC2209 on the same pins, so it drops into the box in its
    place. Ground plane on both layers, 0.8 mm tracks for 12 V and the motor,
    1N5822 reverse-polarity diode with a bypass jumper (JP1), 220 uF on VM,
    test pads (GND, 3V3, VIN, 12V, DIAG), labelled headers, no copper near the
    antenna. DRC clean with schematic parity.
    tools/pcb_parts.py holds the parts and nets; pcb_schematic.py writes the
    project and schematic (and its PDF), pcb_layout.py the footprints and
    placement, pcb_route.py routes with Freerouting and pours ground,
    pcb_finish.py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
    [window_vent_ctrl.kicad_pcb, window_vent_ctrl.kicad_sch]
2026-10-24 SCD40 module drawing; README: its section, TMC2209 text measured
    doc/scd40.svg (tools/scd40_svg.py): the 13.70 x 21.70 x 1.62 board, 7.85
    overall, four pin holes 2.54 apart (GND, VDD, SCL, SDA) measured edge to
    hole edge (2.63, 1.00; centres 3.13, 1.50); the sensor's size and place
    and the corner hole are estimates.
    README: "The SCD40 board, the CO2 sensor" after the TMC2209; the TMC2209
    section now gives its measured sizes; Files block updated.
2026-10-24 PCB silkscreen: USB-UART cue, TEMP bracket, orientation sketch
    Front: "USB-UART" at the board edge beside the ESP32's USB-UART connector
    (replacing the footprint's "USB"); a dotted bracket from J7 and J8 to
    "TEMP"; SCD40 and MOTOR at FAN1's spacing; FAN1/SCD40 pin labels at the
    same 2 mm as the other rows; C1's "+", J1's GND and D1 moved clear.
    Back: title and URL clear of the vias, with a small sketch of the board
    between "outdoor (top edge)" and "indoor (bottom edge)". DRC clean.
    [window_vent_ctrl.kicad_pcb]
2026-10-24 PCB silkscreen: FAN1 down arrow, AS5600 POS and SCD40 CO2 labels
    A small down triangle above FAN1 (the exhaust, the bottom duct); a second
    line under AS5600 ("POS") and SCD40 ("CO2", with a subscript 2). DRC clean.
    [window_vent_ctrl.kicad_pcb]
2026-10-25 Shaft hole fins, box back tabs, fan rubber notches, louver comb guides
    - Sacrificial X fin (fin_t = 0.8, two nozzle lines) in every horizontal
    5.4 mm shaft hole: the body's four bearing holes and fittest D. It holds
    up the top of the hole instead of slicer supports; drill it out by hand.
    New fin_test part (holes with 0.45 and 0.8 fins). README images show
    the holes drilled out; the part views keep the fins.
    - Electronics box: the back pillars and screws from above are replaced by
    two tabs (eb_tab) on 45 deg brackets, up through notches in the encoder
    plate, against the inner faces of the bay walls, each held by an
    M3 x 10 through the wall with a nut inside.
    - Box front cover: 1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
    [body.stl, body_bottom.stl, body_top.stl, ebox.stl, fin_test.stl, fittest.stl, louver_chassis.stl, louver_retainer.stl]
2026-10-26 Louvers: snap-arm combs, front link with a tab; check.py groups
    - Retaining combs, reworked after test prints: round guide ridge under
    each peg in a groove (comb_key 1.5 x 0.75, key_clr 0.2, key_shape),
    4 mm spine, 0.2 mm peg clearance for all pegs (comb_fit), and a snap
    arm at each end whose barb clicks into a pocket in its own channel
    through the side wall (snap_l, snap_t, snap_b). peg_test2: a 3-slot
    wall slice cut from the chassis with a 3-peg comb, to test the fit.
    - Link on the room side by default (link_side = front, blades turned
    over): a tab in its middle sticks out of the frame at every angle,
    with grip ribs along it. link_side = back keeps the hidden link.
    - tools/ch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
    [louver_chassis.stl, louver_link.stl, louver_peg_test2.stl, louver_retainer.stl, louvers.scad]
2026-10-26 Louver link without felt; encoder label on the assembly image
    - louver_link_nopad: the link with its bar 3 mm thick (0.2 mm from the
    wall) instead of the felt strip; the tab stays 2.4 mm, flush with the
    bar's outer face so both print flat. link_pad picks the link shown in
    the assembly; check.py tests both links from -45 to 45 deg.
    - Link thumbnails turned to show the tab (and the step on link_nopad).
    - assembly_lbl.png: "Position encoder, inside" label, its line dashed
    where the part is hidden; every leader line is now horizontal (labels
    sit level with their anchors), so none looks dotted when scaled.
    - README: the new link's row, thumbnail and felt notes.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
    [louver_link.stl, louver_link_nopad.stl, louvers.scad]
2026-10-26 README: status note reflects the printed and test-fitted mechanics
2026-10-26 Tube spacer; no-felt louver link becomes the default
    - tube_spacer: a flat "8" over both spigots, against the stop rings and
    squeezed by the foam, so the spigots' free ends keep their 96 mm
    spacing and foam holes slightly off can't bend the ducts and bind the
    shaft. Press fit on the spigots (spacer = [2.5, -0.05, 8]; 0.2 and
    0.05 were loose). assembly_spc view: with the spacer, foam moved back.
    README: parts and print settings rows, thumbnail.
    - Louvers: louver_link_nopad tested and made the default (link_pad =
    false); the felt link stays as an option. README and image updated.
    [louvers.scad, tube_spacer.stl, window_vent.scad]
2026-10-27 Discs: extra room for the lip foam (seat_rlf = 0.5), housing unchanged
    The 1.6 mm neoprene squeezed into the 1 mm gap was too stiff to close
    by hand and let light through. Half A's face is lowered 0.5 mm and
    half B's bevel set back 0.5 mm square to the slope, for a 1.5 mm gap
    with the housing as printed. Printed and tested: near perfect.
    [disc.stl, window_vent.scad]
2026-10-27 Disc seats per half, disc_nofoam for bare lips; drill guide 5.2 / 6 mm
    - seat_rlf is now [A, B]: half A lowered 0.6 (face at 2.4, on a layer
    boundary; offsets the shaft resting 0.1 off centre toward lip A),
    half B unchanged at 0.5. Printed and tested.
    - Negative values add material: disc_nofoam (lip_foam = false,
    seat_bare = [-0.6, -0.8]) closes about 0.3 mm from the bare lips,
    with the housing unchanged. check.py runs checks 2 to 4 for both
    discs. README: "Without lip foam" (trade-offs, how to adjust).
    - How it seals: conical lip band corrected to about 2.8 mm; foam gap.
    - drill_guide: guide_d = [5.2, 6] (the saw's 5.8 pilot follows a
    5.2 hole; 6 is snug on the probe).
    - Disc im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
    [disc.stl, disc_nofoam.stl, drill_guide.stl, window_vent.scad]
2026-10-27 README: lip seals tested; filament, grub screws and assembly synced
    - Status: lip seals installed and tested after two rounds of disc
    seat tuning; tube spacer tested; disc_nofoam CAD-checked only.
    - Filament: volumes from the current STLs (body 281, discs 2 x 12.7,
    tube_spacer added; total about 372 cm3), split halves, test prints,
    louvers.
    - Grub screws: 6 mm in the discs, 4-5 mm in the magnet cap.
    - Assembly: fit the tube spacer before pushing the spigots in.
2026-10-28 Flat shaft bosses (flat_boss = true): 0.2 mm gap at every angle
    - The bosses' inner faces are flat, square to the shaft, and the discs'
    two shaft ends are cut to matching flats (disc_flat 32.55). A flat end
    turning about the shaft stays in its plane, so the gap is fboss_clr =
    0.2 mm at every angle; the curved faces left 0.75 mm closed and 0.3 at
    worst. flat_boss = false keeps the curved v1 bosses (sboss_clr = 0.3);
    housing and discs must match.
    - The bearing-hole fins start at the bosses' actual inner face (boss_in).
    - check.py: all checks pass, both discs. STLs: body, body_top,
    body_bottom, disc, disc_nofoam (67 x 65 x 14).
    - README: how it seals, status, disc rows, "Housing and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
    [body.stl, body_bottom.stl, body_top.stl, disc.stl, disc_nofoam.stl, window_vent.scad]
2026-10-28 Lip foam cutting guides; README: flat-boss housing printed, fins tested
    - foam_guide_a / foam_guide_b: rigid copies of the two lip foam
    templates. A 3 mm plate with the strip's exact outline (within
    0.002 mm of tools/lip_templates_svg.py), a stiffening rib along its
    middle that stops 5 mm short of the ends, and an arched finger grip
    18 mm high, all inside the edges so the knife runs clear. Plate on
    the bed, no supports, about 15-20 min each.
    - README: guides table in "Cutting the lip foam", filament and slicer
    rows. Status: the flat-boss housing, its discs and the new ebox are
    printed and fit (boss gap gone, back tabs and fan rubber notches
    right); the shaft hole fins print w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
    [foam_guide_a.stl, foam_guide_b.stl, window_vent.scad]
2026-10-28 Firmware: audio mode, a microphone's sound level on GPIO 3
    - AUDIO_MODE in Pins.h (default 0, or -DAUDIO_MODE=1): an analog
    microphone module (MAX9814) on the indoor DS18B20's header instead of
    that probe. GPIO 21 has no ADC, so a wire on the PCB joins it to
    GPIO 3 (ADC1 channel 2); the firmware leaves GPIO 21 disconnected (no
    pulls) and the header's 4.7 k pull-up stays out.
    - Sound.cpp: bursts of one-shot reads at 8 kHz (the 12 V sense shares
    ADC1, so no continuous mode), DC removed, 150 Hz high-pass, RMS in
    dBFS; DC bias, peak to peak, clipping and the achieved rate.
    - Commands: sound, sound mon [ms] (10 s energy average, maximum, bar
    graph), sound cal <dB> (offset to dB SPL,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
2026-10-29 Wiring diagram: optional MAX9814 microphone (audio mode)
    The MAX9814 on the indoor probe's header, the GPIO 21 to GPIO 3 wire and
    the pull-up left out in audio mode. Both optional parts share one dashed
    outline. wiring_svg.py takes an optional output path.
2026-10-29 Controller PCB v1.1: solder jumper JP2 joins GPIO 21 to GPIO 3 (audio mode)
    JP2, open by default, on the back under the ESP32: bridge it to read a
    microphone on J7 with GPIO 3 (ADC1). The board is re-routed; the routing
    now keeps vias off every silkscreen label. The v1.0 Gerber zip stays (the
    boards already ordered). Docs, Pins.h and the wiring diagram mention JP2.
    [window_vent_ctrl.kicad_pcb, window_vent_ctrl.kicad_sch]
2026-10-29 README: PCB bill of materials
2026-10-29 Firmware README: MAX9814 at 40 dB gain; KiCad project file
    GAIN to VDD keeps the MAX9814's AGC out of the way up to about 94 dB SPL,
    so the sound level reads linearly. The project file carries the design
    rules and net classes written by tools/pcb_route.py.
2026-10-29 Wiring diagram: MAX9814 GAIN to VDD (40 dB)
2026-10-29 Force updating the wiring diagram image on GitHub.
2026-10-30 Firmware: drivers moved to a shared library (firmware/libs/WindowVent)
    The pin map, the drivers and the serial console leave baremetal/ for an
    Arduino library, so the coming web application can use them too. Builds
    pass --libraries libs; the scripts and the schematic note point at the
    new Pins.h path.
    [window_vent_ctrl.kicad_sch]
2026-10-30 Firmware: standalone WebUI (dashboard, settings, simulation)
    firmware/webui: the application. CO2 control (look-up curve, open/close
    hysteresis, absolute maximum, temperature caps and free cooling, quiet
    hours, outdoor noise), with its own web page on the home network:
    dashboard with gauges and graphs (uPlot, history in PSRAM), settings
    with a CO2 curve editor, developer view with a simulation (manual values
    or a room model), Wi-Fi setup network with a captive portal, mDNS and
    NTP. ESP-IDF's HTTP server and a WebSocket; ArduinoJson 7. Runs on a
    bare ESP32-S3 in simulation; not run with the parts yet.
    tools/webui_pack.py packs web/ into gzipped C headers. The READMEs cover
    the build, the fir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
    [App.h, Control.cpp, Control.h, History.cpp, History.h, Hw.cpp, Hw.h, Log.cpp]
2026-10-30 WebUI: graphs follow model time in a fast simulation; whole-house sliders
    The history gets its own clock: real time, or the room model's time while
    it runs faster than real time; each record carries it, and the graphs
    draw against it, so x60 fills the 1 h view in a minute. At x1 nothing
    changes. The room model's volume goes to 500 m3, with a new slider for
    the natural air changes (leaks, an open door, the house's stack effect).
    [History.cpp, History.h, Sim.cpp, Sim.h, Web.cpp, webui.ino]
2026-10-30 Firmware README: dashboard screenshot of the WebUI
    A dark-theme capture of the dashboard during a staged simulated evening
    (one, two, then no occupants), with the colours saved on the vent.
2026-10-31 Window insert: printed edge caps for the foam, fit tests and window profiles
    New window_insert/ folder: the foam insert's printed caps, fitted to the
    sliding window's measured profiles, so the foam stays a plain rectangle.
    - cad/window_caps.scad: profile slices (keyed for corner checks) and the
    corner test pieces; top/bottom caps with rib slots, side cap with its
    tongue notched for the centre rib, rail and foam strip, sash cap with
    its groove tongue
    - stl/: the test pieces, exported in print orientation
    - doc/: top and side views of the window's profiles, to scale
    - tools/window_profiles_svg.py: draws both views
    - README: how the caps work, the drawer installation, the test prints
    Co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
    [corner_bottom.stl, corner_sash_bottom.stl, corner_sash_top.stl, corner_side_bottom.stl, corner_side_top.stl, corner_top.stl, corners.stl, slice_bottom.stl]
2026-10-31 Window insert README: clearer wording for the u coordinate
2026-10-31 Window insert README: printed parts tables with thumbnails
    The test prints section becomes Printed parts, in the main README's
    table format (part, thumbnail, quantity, description, size, print
    orientation), for the profile slices and the corner pieces.
    tools/render_images.py renders the thumbnails from the model.
2026-10-31 Window insert: fixes from the corner fit test, drawings updated
    - Sash cap: the channel's walls go on to the ceiling and the floor past
    the sash's end, the room-side one notched for the room-side rib and
    rail; the groove tongue is cut down to 3.3 deep over its last 12 mm at
    each end, over the screw heads in the sash's groove.
    - Side cap: the tongue stops 3.0 mm above the floor, over a 1.7 mm soft
    foam strip on the channel's floor.
    - Re-exported corner_sash_top, corner_sash_bottom, corner_side_bottom and
    the corners plate; thumbnails and README updated.
    - Measurement drawings: the floor strip in the side view, the screw heads
    in the top view.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
    [corner_sash_bottom.stl, corner_sash_top.stl, corner_side_bottom.stl, corners.stl, window_caps.scad]
2026-11-01 Window insert: full caps in segments with snap joiners, wider foam
    - Top and bottom caps in one piece each; the side and sash caps in five
    segments (joints at 216, 432, 648 and 864 mm), joined by separate
    joiners that snap into a socket in each segment's end: a diamond bump
    clicks into a diamond window in a tab of the socket's wall, and each
    socket's closed end is a 45 degree gable (no bridges when printed
    standing).
    - Side cap: relief around the window latch (room-side lip and base).
    - Foam 112 mm wide, lips 8 mm deep and 4.8 mm thick: 96 mm of foam
    uncovered for the vent's chassis, and the sash open 118 mm.
    - Joint test pieces and joiners exported, with thumbnails; corner piece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
    [corner_bottom.stl, corner_sash_bottom.stl, corner_sash_top.stl, corner_side_bottom.stl, corner_side_top.stl, corner_top.stl, corners.stl, joiner_sash.stl]
2026-11-01 Window insert README: slicer settings and the infill reasoning
2026-11-01 Window insert README: assembly views (overall and three corners)
2026-11-01 Window insert joints: tighter joiner, a defined stop, flat-bottomed sockets
    From the PLA joint test: the joiner went 1.2 mm too deep (its chamfered end
    bottomed on the gable's slopes past its length), the joint opened 1 mm when
    pulled, the bumps held poorly and the body was loose.
    - Joiner: 0.1 clearance per side (was 0.2); 16.0 per half, its 1 mm end
    chamfer bearing on the gable 0.1 short (j_end); a 0.4 chamfer along the
    long edges of its bed face (elephant's foot).
    - Bump: 1.0 high (was 0.6), 0.1 inside the window's edges (was 0.3), its
    catch 0.2 from the window's (j_catch, was 0.45).
    - Sockets printed opening up get a flat bottom at the same stop depth.
    - Re-exported the joiners an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
    [joiner_sash.stl, joiner_side.stl, joint_sash_lower.stl, joint_side_lower.stl, joint_tests.stl, window_caps.scad]
2026-11-01 Window insert: engraved part labels on the full caps
    Each full cap has its label engraved 0.6 deep on its back (the face against
    the window, on its outdoor half): T and B for the top and bottom caps, F0 to
    F4 for the side cap's segments (side frame), W0 to W4 for the sash cap's
    (window sash). The segments' labels read upward as installed.
    - tag(): text engraved into a face, given its reading direction and the
    letters' up direction; tag_h and tag_d set the size and depth.
    - The assembly view now places the printed top and bottom caps (at_top(),
    at_bottom()), so their labels show there too.
    - README: a Label column in the full caps table.
    - Images re-rendered (the joiners' bed chamfer; pr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
    [window_caps.scad]
2026-11-01 Window insert: sloped latch relief and a latch test slice
    - side_2's latch relief: its top rises at 45 degrees toward the room, and
    over the lip toward the foam too, so the base and lip above it print
    standing without an overhang; its bottom mirrors it.
    - latch_slice: a 3 mm slice of the side cap at the latch zone's mid-height,
    printed flat, to check the latch's clearance in the real window (it
    clears). README section, STL and thumbnail.
    The full caps' STLs stay out until the foam is measured.
    [latch_slice.stl, window_caps.scad]
2026-11-01 Window insert README: assembly views composed into one image
    GitHub stripes the rows of a README table, so the overall view and the
    three corner views are now one image, composed by render_images.py
    (compose(): the corners stacked on the right, numbered 1 to 3). The
    captions follow as a numbered list. The corner views are zoomed out a
    little to avoid clipping; their separate images are removed.
    [render_images.py]
2026-11-01 Window insert: full caps exported for 2 in foam, README parts list
    The foam measured 49.9 to 51 mm; the lips leave 51.2 mm, so foam_t stays
    50.8 and the full caps (cap_top, cap_bottom, side_0..4, sash_0..4, joiners)
    are exported. The README gets a Parts section: what to print, with
    thumbnails and slicer estimates, what to buy, then the test pieces. The
    status now reads ready to print.
    The cap and profile extrusions get convexity = 10: OpenSCAD's preview drew
    the caps' slots see-through.
    [cap_bottom.stl, cap_top.stl, joiners.stl, sash_0.stl, sash_1.stl, sash_2.stl, sash_3.stl, sash_4.stl]
2026-11-02 Window insert: wider snap tab, snap test, deeper sash sockets
    The snap tab is now 11.6 x 13 mm (was 8 x 12): more material beside the
    window, about the same flex, less strain at its root. A small snap_test
    part (one wall of a sash joint and a joiner) checks it; it passed.
    The wider tab left the sash cap's sockets almost no rigid outer wall, so
    the joint could rock in the tab's direction. The sash sockets now go 25 mm
    deep (the side cap's stay 15 mm), with 52 mm joiners that bear on rigid
    walls well past the tabs. Plate layouts, thumbnails and README updated.
    [joiner_sash.stl, joiners.stl, joint_sash_lower.stl, joint_sash_upper.stl, joint_side_lower.stl, joint_side_upper.stl, joint_tests.stl, sash_0.stl]
2026-11-02 Window insert: hollow printed boxes, an evaluation
    insert_boxes.scad models five hollow PETG boxes stacked between the caps
    in place of the XPS foam: thin shells with inner walls parallel to the
    faces (air gaps in series), printed standing with 45 degree corbels under
    each cell's roof. The box at the latch is notched like the foam. The vent
    box takes the vent's two holes and the probe's, and is cut into four
    pieces through the holes' centres, so every half hole prints as a bowl.
    bore_test prints half a sleeve to try the spigot's fit.
    [bore_test.stl, box_0.stl, box_1a.stl, box_1b.stl, box_1c.stl, box_1d.stl, box_2.stl, box_3.stl]
2026-11-02 Window insert: joiner_sash thumbnail at its new 52 mm length
2026-11-02 Window insert: side and sash caps print in halves
    Whole segments, 215 mm tall, were knocked off the bed near their top as
    they printed standing. Each segment now prints in two halves, a and b,
    about 108 mm tall like the caps, joined at its middle with the same
    sockets and joiners: 9 joints per cap. The halves keep the segments'
    joints, so whole segments (halves = false) still fit them.
    side_2b, whose lower end is in the latch relief, prints turned over on
    its full-profile end; seg_flip() picks the orientation and the sockets'
    flat or gabled ends follow it. The joiners plate now holds 9 side and 18
    sash joiners. README: parts tables, plates, and a 20 mm outer brim.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
    [joiners.stl, sash_0.stl, sash_0a.stl, sash_0b.stl, sash_1.stl, sash_1a.stl, sash_1b.stl, sash_2.stl]
2026-11-03 Controller PCB v1.2: R9 and R10 lie flat on the back
    On v1.1 the standing 1-Wire pull-ups R9 and R10 sat in the path of the
    ESP32's second USB-C plug (the unused USB-OTG one). They now lie flat on
    the solder side, along the left column: only their flat pads are on top,
    and the box's 5 mm standoffs leave room under the board. R9 stays easy
    to remove for the audio mode. The GND and 3V3 test pads move up above
    them. Re-routed with Freerouting, DRC clean; v1.2 Gerbers, renders and
    README updated.
    [window_vent_ctrl.kicad_pcb, window_vent_ctrl.kicad_sch]
2026-11-03 Window insert README: the slicer settings that printed the side cap
2026-11-03 Window insert: latch cover, a liner for the foam's notch at the latch
    A floor just outdoor of the latch zone, 45 degree risers out to the foam's
    room face and a border screwed into the foam. Its end at the side cap is
    straight, the cap (grown by the clearance) subtracted from it. README: the
    part, the notch to carve, the screws.
    [latch_cover.stl, window_caps.scad]
2026-11-03 README: stepper motor lead colours on the J4 header
    Table of the 17HS08-1004S leads (black, green, red, blue) against J4's
    pins, silkscreen and TMC2209 outputs, with a coil check by ohmmeter and
    how to reverse the direction.
2026-11-04 Insect screen frame for the foam's outdoor face
    screen_frame holds fibreglass mesh over both holes, pressed into a
    stadium-shaped spline groove (0.125 in spline or 3 mm O-ring cord).
    Two sleeves plug into the holes' outdoor ends to centre and hold it,
    and four countersunk screws in the corners keep it in place. It fits
    between the caps' lips and stays clear of the probe hole.
    screen_test is its top end, to try the spline and screws first.
    README section, parts, filament, slicer and hardware rows, checklist
    rows, thumbnails, and both parts in check.py.
    [screen_frame.stl, screen_test.stl, window_vent.scad]
2026-11-04 Add a full-size paper template for the latch cover's notch
    tools/latch_template_svg.py draws the notch's outer edge on the room
    face and its floor, both from the model's values, with their heights
    above the foam's bottom edge and 100 mm bars to check the print scale.
    The README links the PDF and lists the new files. The PETG row now
    gives the joiners and the latch cover their own weights.
2026-11-04 Add condensation drains to the screen frame, widen the countersinks
    Screen frame: a 15 mm slot at the bottom of each hole, through the
    sleeve and the plate (scr_drain), its floor flush with the hole's floor
    and dropping 1 mm to the outdoor face, so water runs out under the mesh
    instead of pooling against the sleeve. The frame's bottom end moves
    down 3 mm (193 tall) to keep the groove's wall under the lower drain.
    screen_test is now the bottom end, with a drain. The groove's mouth
    chamfer is two hulled cones instead of a minkowski(): the same shape,
    and the frame renders in about 33 s instead of 77 s. Thumbnails are
    turned so the drains show at the bottom.
    Countersinks: 0.8 mm wider than the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
    [latch_cover.stl, screen_frame.stl, screen_test.stl, window_caps.scad, window_vent.scad]
2026-11-04 Mark the screen frame's spline groove as tested
    The 2.8 mm groove holds 0.125 in screen spline over fibreglass mesh
    well. The O-ring cord is still untried, so screen_test stays the first
    step for it and for other splines.
2026-11-04 Add an optional drip tray with four adjustable legs
    The tray sits on the window ledge under the whole unit, from the foam to
    just past the fans, and catches condensation drips; the electronics box
    stands on three ribs above its floor. A leg in each corner levels it: an
    M3 x 20 button head, held by its head in a slot at the top of a corner
    post and turned from above with a 2 mm hex key, drives a square foot
    with a captive nut in the post's socket (3.5 to 11 mm under the floor).
    The posts stay inside the tray's outline, clear of the window frame.
    New parts: tray, tray_feet (four), tray_test (one corner and a foot),
    and tray_view. check.py now accepts parts printed as several pieces.
    README se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
    [tray.stl, tray_feet.stl, tray_test.stl, window_vent.scad]
2026-11-04 Stiffen the drip tray with five full-length ribs
    The ribs now run from wall to wall, 3 mm tall instead of 2, and five
    instead of three. The outer two sit under the electronics box's side
    walls and run into the corner posts, so they carry the unit's weight to
    the legs instead of the thin floor. Also mark the screen frame's wider
    countersinks as tested.
    [tray.stl, tray_test.stl, window_vent.scad]
2026-11-04 Widen the drip tray, clear the bottom cap's lip, seven even ribs
    The tray's back face now sits 6 mm off the foam (tray_back), clear of
    the bottom cap's 4.8 mm lip. The back posts no longer fit behind the
    electronics box, so all four posts stand beside it (tray_gap), and the
    tray grows to 109 x 115 mm: 14.4 mm past the fans on each side.
    Seven ribs, evenly spaced 13.1 mm apart across the inside; the outer
    two fall under the box's side walls. Each rib stops 2 mm short of the
    walls, and a rib that would pass close beside a post stops 2 mm short
    of the post instead, so no narrow slit holds water.
    [tray.stl, tray_test.stl, window_vent.scad]
2026-11-04 Redesign the drip tray's legs to print without bridges or supports
    The first legs' bridged head slot sagged without supports, and with
    supports they couldn't be cleaned out. Now the M3 screw goes in from
    below, its button head pressing up into a 45 deg pyramid at the top of
    the post's socket, still turned from above with a 2 mm hex key.
    An M2 x 6 flat head screw through the post's outer wall (thickened to
    3.5 mm, tray_pwall, for its thread; shallow countersink) rides in a
    groove up the foot: it holds the leg in and sets the travel, 4 to 11 mm
    under the floor (tray_range). The foot is 20 mm long and prints on its
    side, its nut slot, groove and teardrop bore facing up. Asserts check
    the screw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
    [tray.stl, tray_feet.stl, tray_test.stl, window_vent.scad]
2026-11-05 Make the drip tray's M2 stop screws sit flush
    The countersink now follows the measured head (3.38 x 1.2-1.25): 3.6 at
    the post's face, 1.25 deep, leaving 2.25 mm of thread in the 3.5 wall.
    The leg is marked as tested in tray_test.
    [tray.stl, tray_test.stl, window_vent.scad]
2026-11-05 Add 112 mm width guides to the foam drilling template
    The window insert's XPS foam is now 112 mm wide; the 100 mm guides stay.
2026-11-05 Mark the foam holes, spigot fit and drip tray as tested
    The holes, drilled with the template in the 112 mm insert, fit the unit
    without O-rings, and the tray levels it to them (height and tilt).
2026-11-05 Return the drip tray's M2 stops to the shallow countersink
    The flush countersink, tried on the full tray, still left the heads a
    little proud (it prints on its side and comes out small) and only
    2.25 mm of thread. The shallow one keeps 2.8 mm; a slightly proud head
    is fine for a stop that carries no load.
    [tray.stl, tray_test.stl, window_vent.scad]
2026-11-05 Firmware: first bench test with the parts; SCD40 stopped at boot
    The bare-metal console checked every part on the bench: SCD40, AS5600,
    outdoor DS18B20, MAX9814, TMC2209 and motor, both fans, 12 V sense.
    - Scd40Begin stops a measurement left running through an ESP32 reset:
    the sensor otherwise refused serial, self-test and start, and the web
    application would have retried its start forever.
    - AUDIO_MODE is 1 by default (the microphone is fitted).
    - baremetal 1.3.
    - README notes: the NF-A8s stop at 0-5 % and start near 10 %; modules
    like the TMC2209-LA route PDN_UART to pin 4 through a 0 ohm link, so
    pins 4 and 5 are joined with a wire.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
    [baremetal.ino]
2026-11-05 Web firmware: encoder-based damper stall and closed detection
    The encoder must keep finding a new closest approach to the target (by
    0.5 deg); with no progress for 600 ms the motor stops. Closing and within
    5 deg of closed, the disc is seated on the lips; anywhere else it is
    blocked and flagged as a fault. A seated damper pushed open again (airflow,
    a hand) closes again. The 8 s move timeout stays as a backstop.
    Compiles without warnings; not yet run on the hardware.
    [Hw.cpp]
2026-11-05 Controller PCB v1.3: TMC2209 UART on pins 4 and 5; 0402 jumpers
    Some TMC2209 modules (the TMC2209-LA among them) have a 0 ohm link that
    routes the chip's PDN_UART to their PDN pin (pin 4) instead of their UART
    pin (pin 5), which v1.2 alone wired: the driver stayed silent until a wire
    joined pins 4 and 5. JP3 (pin 4) and JP4 (pin 5), both fitted, now put the
    UART line on both; leave one out if a module uses that pin for something
    else. They sit on the back, under the pins.
    Every jumper is now an 0402 hand-solder footprint for a 0 ohm resistor or
    a short wire: JP2 (audio mode) was a solder jumper, and is marked DNP on
    the schematic and the board. Re-routed with Freerouting, DRC clean with
    sch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
    [window_vent_ctrl.kicad_pcb, window_vent_ctrl.kicad_sch]
2026-11-05 Window insert: outdoor microphone tube for the audio mode
    The MAX9814 isn't weatherproof, so it stays on the room side and listens
    through an L in the foam. cad/mic_tube.scad: a tube through a 10 mm hole,
    standing 12 mm out of the outdoor face and cut there at 45 degrees, top
    the longer side, as a roof over the opening; an elbow screwed to the room
    face (2 screws, as the latch cover's), turning the sound path up to the
    capsule, which points down into a light press-fit bore under a tray for
    the module; a lid with a cable notch. A flat on the tube's room end keys
    it in the elbow, so the roof stays on top; in the foam the tube is round,
    so it seals all around. mic_bore_test tries three capsule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
    [mic_bore_test.stl, mic_elbow.stl, mic_lid.stl, mic_tube.scad, mic_tube.stl]
2026-11-05 Microphone tube: elbow in two parts, joined by four M2 screws
    The one-piece elbow printed its 10.4 mm socket as a horizontal hole. It
    now splits level with the flange's top: the lower part (flange, socket,
    the start of the sound path) prints lying on its flange, so the socket is
    a vertical hole and the path turns up as a teardrop, point up; the upper
    part (the capsule's bore and the tray) stands as installed, so the bore
    stays round. Four M2 x 6 countersunk screws from inside the tray, in
    pockets under the PCB, go into tapped 1.6 mm holes in the lower part. The
    tray's floor is 3 mm higher, so the capsule's bore stays above the split.
    The assembly view shows the two parts in their own colour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
    [mic_elbow.stl, mic_elbow_lower.stl, mic_elbow_upper.stl, mic_lid.stl, mic_tube.scad]
2026-11-06 Microphone tube: tube screwed in its socket, lid clip, wider tray
    From the first print:
    - the socket's bottom is a 45 degree cone, the tube's stop (it was a
    flat overhang as printed);
    - an M2 x 6 through the elbow's side, tapped into the tube's wall,
    holds the tube in its socket, so it can't slide into the foam;
    - the lid's rim clips into a groove in the tray's long walls;
    - 1.5 mm beside the PCB in the tray, for tweezers; the foam screws,
    the flange and the joint's front M2 screws move out to suit.
    [mic_elbow_lower.stl, mic_elbow_upper.stl, mic_lid.stl, mic_tube.scad, mic_tube.stl]
2026-11-06 Web firmware 0.2.0: Wi-Fi console, update over Wi-Fi, damper boundary test, dBA
    - Console over the Wi-Fi: the serial commands also run from POST
    /api/console and the Developer tab, in the loop; new status, log,
    enc, tmc, i2c scan, sound, ota and test commands. The log keeps 2000
    lines in PSRAM, served by GET /api/log.
    - Test mode: fan and damper commands drive the hardware directly; it
    ends by itself after 10 min.
    - Firmware update over the Wi-Fi (POST /update, System tab): written
    to the other app slot; the new firmware confirms itself after 30 s
    on the Wi-Fi, or the vent rolls back (crash at boot, or 5 min).
    - A password (serial: pass) guards the console and the update.
    - Dampe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
    [App.h, Hw.cpp, Hw.h, Log.cpp, Log.h, Web.cpp, Web.h]
2026-11-06 Web firmware: SCD40 temperature offset from the console
    co2 offset [C] shows or sets the SCD40's temperature offset, and
    co2 tref <C> sets it so the sensor matches a reference thermometer
    beside it. Kept in the sensor's EEPROM. To set once the vent is in its
    final place.
2026-11-06 Web page: two graphs, legends show the latest values
    Humidity joins CO2 and the fans (both in %), and in audio mode the
    outdoor sound joins the temperatures, on a dBA axis at the right: the
    third graph is gone. The legends under the graphs show the latest
    values when the mouse isn't over them, instead of "--".
2026-11-06 Web firmware 0.2.2: continuous sound, settings sync, phone sliders
    - The microphone is sampled without a pause: ADC DMA at 8000 samples/s
    (SoundStream), filtered into 1/8 s blocks by a task. It replaces a
    100 ms burst every 2 s, which heard 5 % of the time. The noise
    threshold uses the loudest block, so one bark or horn is enough, and
    the graph shows the loudest block of each 10 s. The 12 V sense shares
    ADC1, so it comes through the same stream.
    - Open pages follow settings changed elsewhere: the state carries a
    revision, and a page reloads the settings when it changes, keeping
    its unsaved edits.
    - A page back from the background fetches the history it missed, so
    the graphs n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
    [App.h, Control.cpp, History.cpp, History.h, Hw.cpp, Settings.cpp, Settings.h, Sim.cpp]
2026-11-06 Web firmware 0.2.5: damper reversal, steady connection, page layout
    - Damper: a new target in mid-move restarts the stall check. It was
    measuring progress against the old target, so a reversal could stop
    the motor with a false "blocked" fault.
    - The page's WebSocket no longer drops every few seconds: the server
    had 8 connections, and closed the one it had heard from the longest
    ago when short, always a WebSocket. It now has 12, and pages send a
    keep-alive every 2 s.
    - History: no records from the simulation in the seconds after boot.
    - Tiles: 3 x 2 above 900 px, in equal widths and heights. The graphs
    have the same axis widths, so their time axes line up. The tile's
    "Loud outsi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
    [App.h, Hw.cpp, Web.cpp, webui.ino]
2026-11-06 READMEs: status updated, the vent is installed and running in a window
    The root, window insert and firmware introductions now say so, with
    what is still open: the SCD40's CO2 against a calibrated meter, and
    the microphone's level through its tube, which was not measured.
2026-11-06 Web firmware 0.2.7: boundary test can't save a wrong motor direction
    Booting with the disc already on the lips, the motor slips and the disc
    bounces back a few degrees. The test took that for a motor turning the
    wrong way, flipped motorDir and saved it, leaving the damper stuck closed
    with the fans running. Now:
    - closing must go 20 deg the wrong way, not 3, to count;
    - motorDir is saved only if the test succeeds, and restored if it fails;
    - stops too close together try the other direction, once: a disc near the
    open stop can't show a wrong direction while closing.
    Also: Wi-Fi power saving off (on mains power, answers matter more), and a
    console command, cpu: each task's share of its core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
    [App.h, Hw.cpp, Net.cpp, webui.ino]
2026-11-07 MAX9814 drawing; mic tube from measured module sizes
    - doc/max9814.svg (tools/max9814_svg.py): the microphone board, dimensioned:
    25.6 x 14.3 x 1.62, 9.0 overall, capsule 9.70 x 7.38 at 2.10 from the end,
    header and 2.30 mounting holes. New README section, linked from the tube.
    - mic_tube.scad: module and capsule from the measurements; capsule bore
    10.0 (cap_fit 0.3, 0.2 was hard to remove), bore test 0.2 to 0.4; tray
    floor 1 mm higher so the deeper bore stays above the split. STLs, part
    sizes and thumbnails updated (the tube is unchanged).
    - SCD40 membrane warning moved under the SCD40 drawing.
    [mic_bore_test.stl, mic_elbow_lower.stl, mic_elbow_upper.stl, mic_lid.stl, mic_tube.scad]
2026-11-07 PCB v1.4: J7 as a 2x3 header for an INMP441 I2S microphone
    - J7 row 1 unchanged (3V3, IN, GND: indoor DS18B20 or MAX9814); row 2 adds
    WS (GPIO 39), SCK (GPIO 38) and a GND for the mic's L/R pin; SD on IN
    (GPIO 21).
    - To make room: the motor header J4 stands beside the TMC2209, the SCD40's
    J5 takes J4's place on the bottom row, R3/R4 sit under J7. Silkscreen
    reworked (vertical MOTOR/SCD40 names, TEMP under J8).
    - Schematic, board, renders and v1.4 Gerber zip regenerated; DRC clean
    with schematic parity.
    - READMEs and Pins.h: the INMP441 pins (firmware support not yet).
    [window_vent_ctrl.kicad_pcb, window_vent_ctrl.kicad_sch]
2026-11-07 INMP441 I2S microphone option (MIC_INMP441), wiring diagram, CO2 check
    - SoundStream: an I2S path (SoundStreamBeginI2s) for the INMP441, sharing
    the filters, blocks and ring with the analog one; micOk in SoundStats.
    - Pins.h: MIC_INMP441 (default 0, the MAX9814), I2S pins SCK 38, WS 39,
    SD 21, MIC_CAL_DB 120 for the INMP441 (-26 dBFS at 94 dB SPL).
    - webui 0.2.8: I2S start, 12 V sense by analogRead in that mode; the
    saved micCal is tied to its microphone ("mic" in the settings).
    - baremetal: sound, sound mon, sound cal and the status line with the
    INMP441.
    - Wiring diagram: the INMP441 (dashed), SD on GPIO 21, WS/SCK tags.
    - READMEs: the INMP441 option; the SCD40's CO2 agrees with th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
2026-11-07 webui 0.2.9: sockets command, connection/CPU/Wi-Fi stats on the System tab, header aligned
    - Console: "sockets" lists the web server's connections (HTTP or WebSocket, client, age), the counters since
    boot (open, peak, accepted, closed while full by the LRU purge) and the Wi-Fi drops.
    - System tab: Wi-Fi channel and drops (with the last reason), connections, last reset cause, CPU busy per
    core (5 s), the loop's longest pass, free memory with its lowest point.
    - Web.cpp: open/close callbacks keep the socket counters. Net.cpp: Wi-Fi events count every drop.
    - Page: the header and tabs line up with the content's maximum width; their background still spans the window.
    Stable reference: this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
    [App.h, Net.cpp, Net.h, Web.cpp, Web.h, webui.ino]
2026-11-08 PCB v1.5: 470 uF +3V3 bulk capacitor, wide supply tracks, route cleanup
    - C2 (470 uF 10 V, 6.3 mm radial) replaces the 3V3/GND test pads in the
    top-left corner, far from the antenna; its leads serve as test points.
    The test-pad labels are gone and a "+" marks the capacitor's polarity.
    - New "Supply" net class: +3V3 routed at 0.5 mm; C2's GND pad has a solid
    zone connection.
    - No ground fill along the top edge on F.Cu, which caused kinks in the
    tracks there.
    - pcb_route.py: post-routing cleanup that widens necked segments back to
    their class width and straightens small jogs, only where clearance
    allows; it reports the unconnected count before and after.
    - README: v1.5 notes, BOM r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
    [window_vent_ctrl.kicad_pcb, window_vent_ctrl.kicad_sch]
2026-11-08 webui 0.2.10: a page that stops reading no longer hangs the web server
    A WebSocket client that keeps its connection but stops reading (a page
    asleep in a background tab or on a phone) filled its TCP window; each
    broadcast then blocked 5 s in the server's single task, so new requests
    were never served while pings still answered. Reproduced from the
    mini-PC with a client that never reads.
    - Own non-blocking WebSocket frame writer: a frame goes out as far as
    there is room, the rest is kept and sent later (never cut); while a
    page is behind it skips newer states, and after 15 in a row it is
    closed (the page reconnects when it wakes up).
    - No broadcast backlog: a new state is dropped while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
    [App.h, Web.cpp, Web.h, webui.ino]
2026-11-08 Intake below, exhaust on top: fan roles as a setting, swapped default
    The cold incoming air sinks and the warm exhaust rises, so with the
    intake on top part of the fresh air could fall straight into the
    exhaust indoors, and the exhaust plume could rise into the intake
    outdoors. With the intake low, neither loops back into the other.
    webui 0.2.11:
    - New setting fans.intakeFan (Settings > Fans, "Intake on the lower fan
    (FAN1)"), default INTAKE_FAN in App.h, now 1. HwFanConn() maps the
    roles to the connectors for the PWM and the rpm readings; the control,
    balance, dashboard, history and simulation stay in intake/exhaust.
    - Console: fan <0|1|all> by connector (FAN0 upper, FAN1 lower, as o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
    [body.stl, body_bottom.stl, body_top.stl, insert_boxes.scad, window_vent.scad, window_vent_ctrl.kicad_pcb, window_vent_ctrl.kicad_sch]
2026-11-08 Outdoor probe: put it far from the exhaust if possible
    Since the swap the template's probe spot, above the upper hole, sits
    over the exhaust, whose warm air skews the reading. The drilling
    template gets a fifth instruction line (title and lines moved up a
    little to clear the probe's labels), and the README's parts list and
    drilling section say to put the probe far from the exhaust if possible
    (not between the holes: the insect screen's frame covers that strip).
    [foam_template_svg.py]
2026-11-08 webui 0.2.12: the live sound graph and tile show the loudest 1/8 s
    The noise cap and the stored history use the loudest 1/8 s, but the
    live graph and the sound tile used the level averaged over each second,
    so a short loud sound could close the damper while an open page showed
    only a small bump (a reload, from the history, did show it).
    - The state now carries in.sndMax: the loudest 1/8 s since the previous
    state, tracked at every control step so nothing in between is lost.
    - The page uses it for the live graph points ("Outdoor sound, loudest")
    and for the tile's number, bar marker and threshold colour; older
    firmware falls back to in.snd.
    - Firmware README: what the tile and the grap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
    [App.h, webui.ino]
2026-11-08 webui 0.2.13: spacing for a second section in a card
    - A heading that isn't the first in its card gets 24 px above it:
    "Firmware update" under the Restart button (System tab) and
    "Hardware" under the control outputs (wrench tab).
    - 14 px between the hardware chips and their readings (wrench tab,
    before "12 V supply").
2026-11-09 webui 0.2.14: rebuild the graphs when their canvas state is reset
    After a canvas context loss (the computer or the GPU asleep, a tab hidden
    for long) the browser resets the drawing state, but uPlot keeps its cached
    font and draws the axis labels at the 10 px default, tiny on a high-DPI
    screen. Check the font on contextrestored and when the tab becomes visible,
    and rebuild the graphs if it was reset.
    [App.h]
2026-11-13 PCB v2.0: for an ESP32-S3-N16R8 board with an external antenna
    A DevKitC-1 type board, 2 x 22 pins, with a U.FL connector. Its 20
    middle pins of each row land on the Freenove's holes, so the Freenove
    still fits on the inner pins (outline dotted on the silkscreen, antenna
    keep-out shared). No JP1, TP3 or TP4; C2 below the antenna end, J1
    lower, D1 turned 45 deg with a tight courtyard.
    The tools build v2.0 by default; VENT_PCB=lite builds v1.5. The README
    now presents v2.0. Row spacing and board size are from photos: measure
    before ordering.
    [window_vent_ctrl_devkitc.kicad_pcb, window_vent_ctrl_devkitc.kicad_sch]
2026-11-13 Optional fan spacer with straightening vanes for two stacked fans
    A 12 mm square block between two fans in series (push-pull): the fans'
    76 mm bore, a 30 mm hub ring and 8 radial vanes straighten the first
    fan's swirl and keep the rotors apart. M3 x 70 through-bolts hold the
    whole stack on the fan plate's nuts. Prints with no supports.
    check.py gets a fan_spacer group (check 9), render_images.py its part
    image, and the README a section, a print row and the bolt lengths.
    [fan_spacer.scad, fan_spacer.stl]
2026-11-14 Fan shims: clear the fans' corner rubber pads on the spacer
    A 1.35 mm cross-shaped sheet on each face of the fan spacer, its
    corners cut away around the pads, so the fans bear on it instead of
    only on their pads. Four tabs at mid-sides key it into the spacer's
    bore between the vanes; 4 mm triangles stiffen the cross's inner
    corners. The stack is 2.7 mm longer: M3 x 75 bolts (or length = 10
    and M3 x 70).
    check.py also checks that the tabs clear the vanes.
    [fan_shim.stl, fan_spacer.scad, fan_spacer.stl]
2026-11-14 Fan gasket template: neoprene to seal the slit under each fan
    The fans' corner pads leave a 1.35 mm slit between each fan and the
    fan plate, where air leaks back from the pressure side. A 1.6 mm
    neoprene gasket in the shims' cross shape seals it and keeps the fan
    on a soft mount. The new fan_gasket_template part is the shim's outline
    without tabs, 2 mm thick, to cut it; shim and template share one
    outline module.
    [fan_gasket_template.stl, fan_spacer.scad]
2026-11-14 Fan shim: tab pairs against the vanes, so it can't turn; 1.25 mm thick
    Each of the four tabs is split in two halves, one against each vane of
    its gap (0.2 mm clearance), so the shim can't turn between the vanes.
    check.py checks that turning it 1 deg either way makes them hit.
    The shim is now 1.25 mm, just under the pads' 1.35, so they still press
    a little; the stack is 70.5 mm to the back of the fan plate (M3 x 75).
    [fan_shim.stl, fan_spacer.scad]
